MissouriMRDT/ArmBoard_Hardware/README.md

# ArmBoardHardware
Hardware design files for robotic arm

Master branch holds completed versions, branch arm board holds works in progress
