MissouriMRDT/ArmBoard_Hardware/Manufacturing/Armboard BOM.xlsx

Id | Designator | Package | Designation | Item Name | Manufacturer Number | Vendor | Quantity | Cost Per Item | URL | Standard Components Document (https://docs.google.com/spreadsheets/d/1Z3rDIutImW05QqWMk1JalDYzc1NMwjMxJc6CKg8kRtc/edit)
1 | C1, C2, C5, C6, C7, C8, C9, C10, C11 | 10uF | 603 smd | CAP CER 10UF 10V X5R 0603 | C0603C106M8PAC7411 | DigiKey | 9 | 0.48 | C0603C106M8PAC7411 KEMET | Capacitors | DigiKey (https://www.digikey.com/en/products/detail/kemet/C0603C106M8PAC7411/12701345)
2 | D1, D4, D7, D10, D13, D26, D29 |  | 603 smd | Zener diode |  | DigiKey | 7 | 0.10 | Already have them I think
3 | ConnA |  | Anderson PP | Black Housing | 1327G6 | Powerwerx | 8 | 0.39 | https://powerwerx.com/anderson-powerpole-colored-housings
4 | ConnB |  | Anderson PP | Red Housing | 1327 | Powerwerx | 8 | 0.39 | https://powerwerx.com/anderson-powerpole-colored-housings
5 | ConnC |  | Anderson PP | Green Housing | 1327G5 | Powerwerx | 1 | 0.39 | https://powerwerx.com/anderson-powerpole-colored-housings
6 | Conn8, Conn11, Conn12, Conn15, Conn16, Conn19, Conn20, Conn21 | Molex_SL_02 | MRDT_Connectors:MOLEX_SL_02_Horizontal | Molex SL 2 | 705530001 | DigiKey | 8 | 0.82 | https://www.digikey.com/en/products/detail/molex/0705530001/114951?s=N4IgTCBcDaIOoFkAsBOADGgtAOQCIgF0BfIA
7 | Conn9, Conn10, Conn13, Conn14, Conn17, Conn18 | Molex_SL_03 | MRDT_Connectors:MOLEX_SL_03_Horizontal | Molex SL 3 | 705530002 | DigiKey | 6 | 1.18 | https://www.digikey.com/en/products/detail/molex/0705530002/114955
8 | D2, D3, D5, D6, D8, D9, D11, D12, D14, D15, D16, D25, D27, D28, D30, D31 | Blue | 603 smd | LED BLUE CLEAR CHIP SMD | LTST-C191TBKT | DigiKey | 16 | 0.33 | https://www.digikey.com/en/products/detail/lite-on-inc/LTST-C191TBKT/573587
9 | D17, D18, D19, D32, D33 | Green | 603 smd | LED GREEN CLEAR CHIP SMD | LTST-C191KGKT | DigiKey | 11 | 0.26 | https://www.digikey.com/en/products/detail/lite-on-inc/LTST-C191KGKT/386834
10 | Q1 Q2 | MOSFET NpN 6Amps | SMD:SOT-23-3 | 833-SI3420A-TP | SI3420A-TP | Mouser | 2 | 0.37 | https://www.mouser.com/ProductDetail/Micro-Commercial-Components-MCC/SI3420A-TP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
11 | R18, R19 | 330 | 603 smd | RES SMD 330 OHM 5% 1/4W 0603 | ESR03EZPJ331 | Digikey | 2 | 0.10 | https://www.digikey.com/en/products/detail/rohm-semiconductor/ESR03EZPJ331/1762730
13 | 1k1, 1k2, 1k3, 1k4, 1k5, 1k6, 1k7, 1k8, 1k9, 1k10, 1k11, 1k12, 1k13, 1k14, 1k15, 1k16, 1k17, 1k18, 1k19, 1k20, 1k21, 1k22, 1k23, 1k24, 1k25, 1k26, 1k27, 1k28, 1k29, 1k30, 1k31, 1k32, 1k33, 1k34, 1k35, 1k36, 1k37, 1k38, 1k39, 1k40, 1k41, 1k42 | 1k | 603 smd | RES SMD 1K OHM 5% 1/4W 0603 | ESR03EZPJ102 | DigiKey | 42 | 0.10 | https://www.digikey.com/en/products/detail/rohm-semiconductor/ESR03EZPJ102/1762721
14 | R35, R36, R37, R38, R39, R40, R41 | 3.3k | 603 smd | RES SMD 3.3K OHM 5% 1/4W 0603 | ESR03EZPJ332 | DigiKey | 7 | 0.10 | https://www.digikey.com/en/products/detail/rohm-semiconductor/ESR03EZPJ332/4051239
15 | R42, R43, R44, R45, R46, R47, R48 | 10k | 603 smd | RES SMD 10K OHM 5% 1/4W 0603 | ESR03EZPJ103 | DigiKey | 14 | 0.10 | https://www.digikey.com/en/products/detail/rohm-semiconductor/ESR03EZPJ103/1762722
16 | R15, R16,R42, R43, R44, R45, R46, R47, R48 | 120 | 603 smd | RES SMD 100 OHM 5% 1/4W 0603 | ESR03EZPJ101 | DigiKey | 9 | 0.10 | https://www.digikey.com/en/products/detail/te-connectivity-passive-product/CRGCQ0603F120R/8576279
17 | SW1 SW2 SW3 SW4 SW5 SW6 SW7 | SW_Push | Button_Switch_SMD:SW_SPST_TL3305A | SWITCH TACTILE SPST-NO 50MA 12V | TL3305AF160QG | DigiKey | 7 | 0.13 | https://www.digikey.com/en/products/detail/e-switch/TL3305AF160QG/5816195
18 | U1 | TM4C129E_Launchpad | MRDT_Shields:TM4C129E_Launchpad_FULL_SMD_BOTTOM | LAUNCHPAD TM4C129X EVAL BRD |  |  | 1 | 17.00
19 | U2 | OKI | MRDT_Devices:OKI_Horizontal | DC DC CONVERTER 3.3V 5W | OKI-78SR-3.3/1.5-W36H-C | Digikey | 1 | 4.30 | https://www.digikey.com/en/products/detail/murata-power-solutions-inc/OKI-78SR-3.3-1.5-W36H-C/4878851
20 | MC1, MC2, MC3, MC4, MC5, MC6, MC7 | MRDT_ICs:MultiPowerSO_30 | VNH5019A_E | VNH5019A_E |  | DigiKey | 7 | 4.50 | https://www.digikey.com/en/products/detail/stmicroelectronics/VNH5019A-E/3087979
