MissouriMRDT/ArmBoard_Hardware/Hardware/ArmBoard_Hardware/ArmBoard_Hardware.step

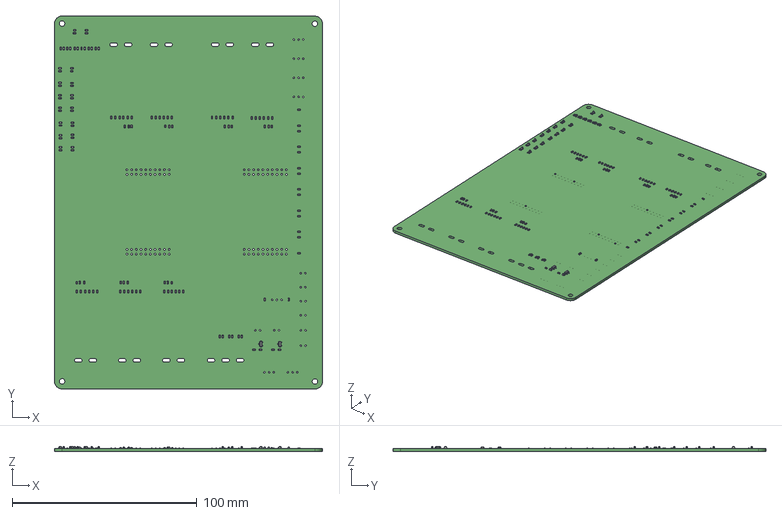
[picture p1: CAD file, 2022-03-09]
Hardware/ArmBoard_Hardware/ArmBoard_Hardware.step
145.2 x 202.0 x 2.85 mm
