MissouriMRDT/ArmBoard_Hardware/Documentation/ArmBoard_Hardware.pdf

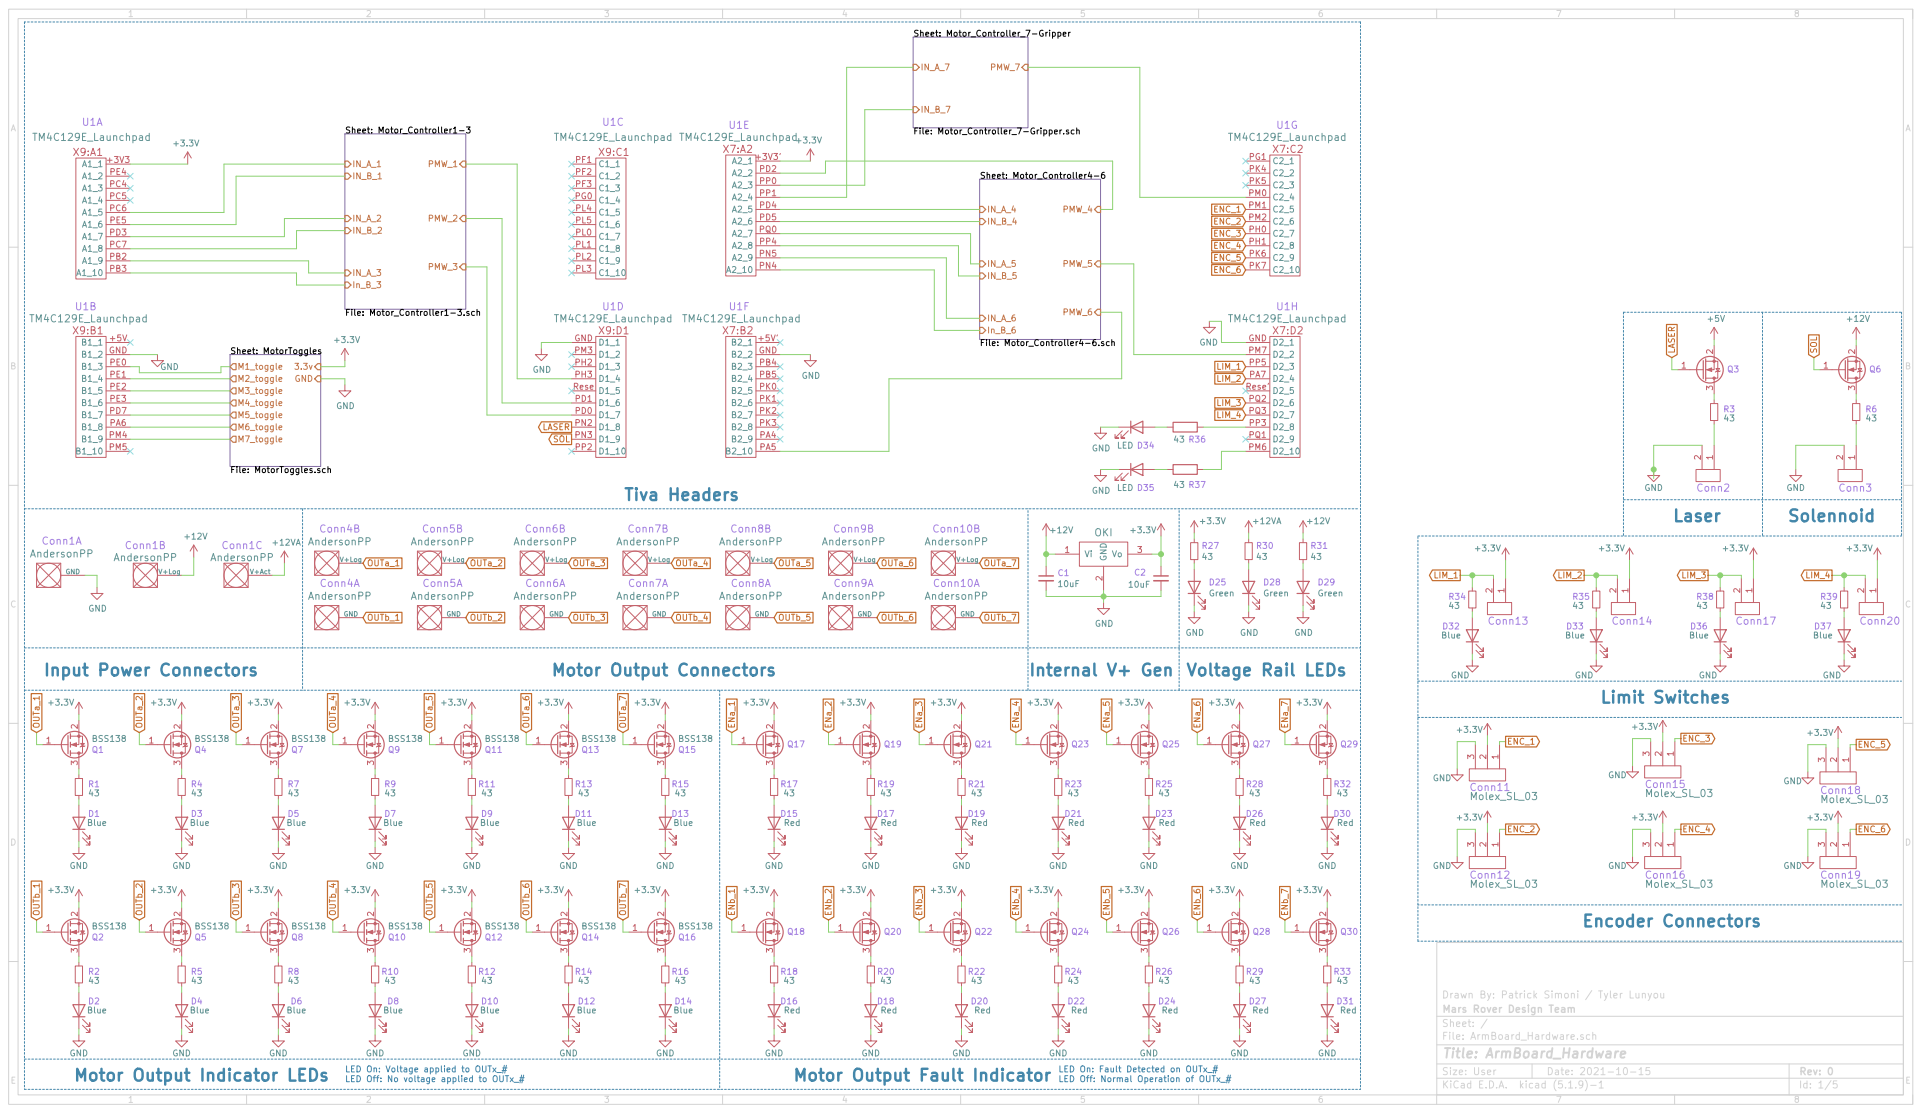
[picture p2: page 1]

Drawn By: Patrick Simoni / Tyler Lunyou
File: ArmBoard_Hardware.sch Sheet: / Mars Rover Design Team

Motor Output Fault Indicator

LED On: Fault Detected on OUTx_#
LED Off: Normal Operation of OUTx_#

LED Off: No voltage applied to OUTx_#

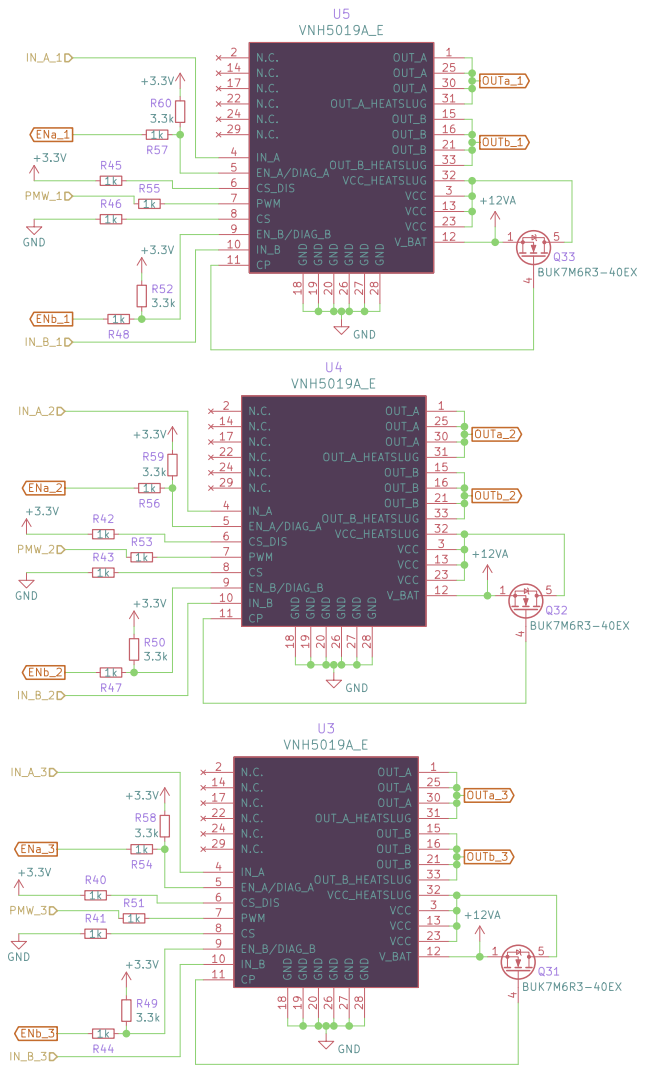
[picture p3: page 2]

Mars Rover Design Team
Sheet: /Motor_Controller1-3/
File: Motor_Controller1-3.sch
Id: 2/5 Title: ArmBoard_Hardware

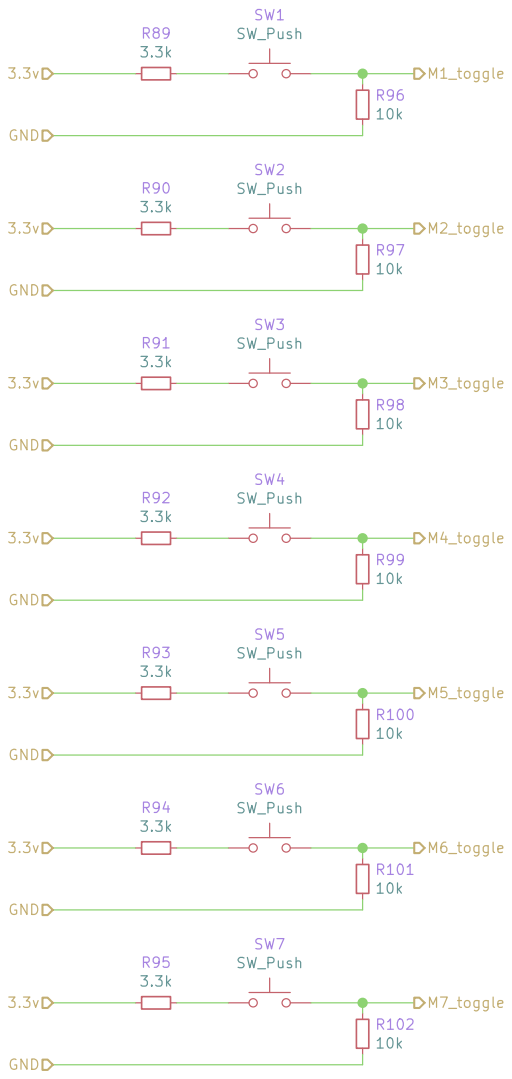
[picture p4: page 3]

Drawn By: Patrick Simoni / Tyler Lunyou
Mars Rover Design Team
Sheet: /MotorToggles/
File: MotorToggles.sch
Id: 3/5 Title: ArmBoard_Hardware

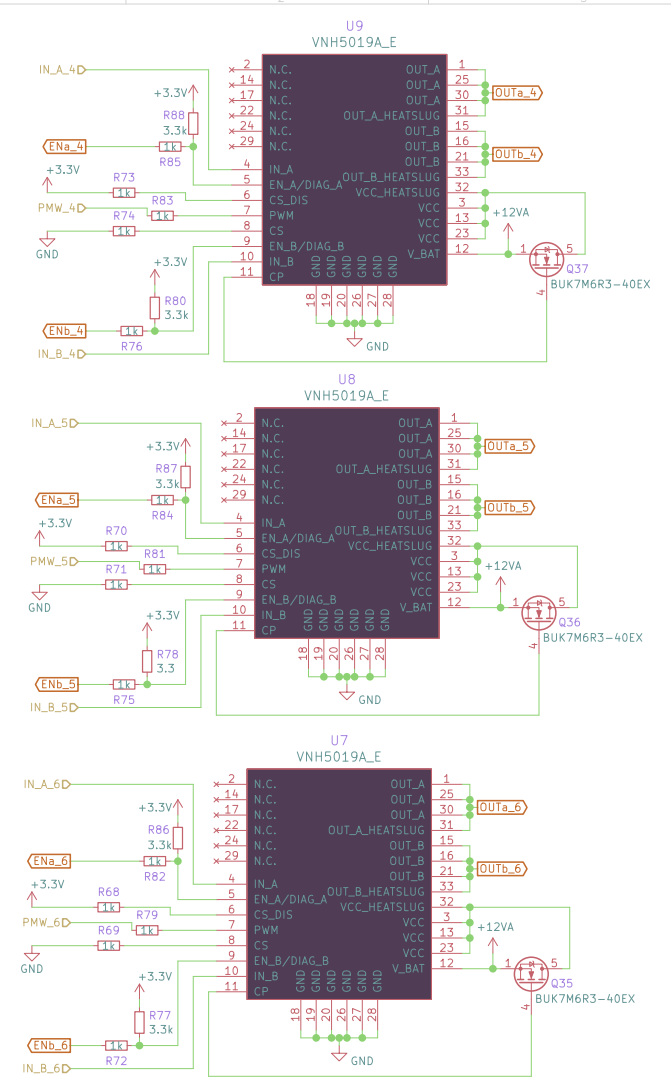
[picture p5: page 4]

Mars Rover Design Team
Sheet: /Motor_Controller4-6/
File: Motor_Controller4-6.sch
Id: 4/5 Title: ArmBoard_Hardware

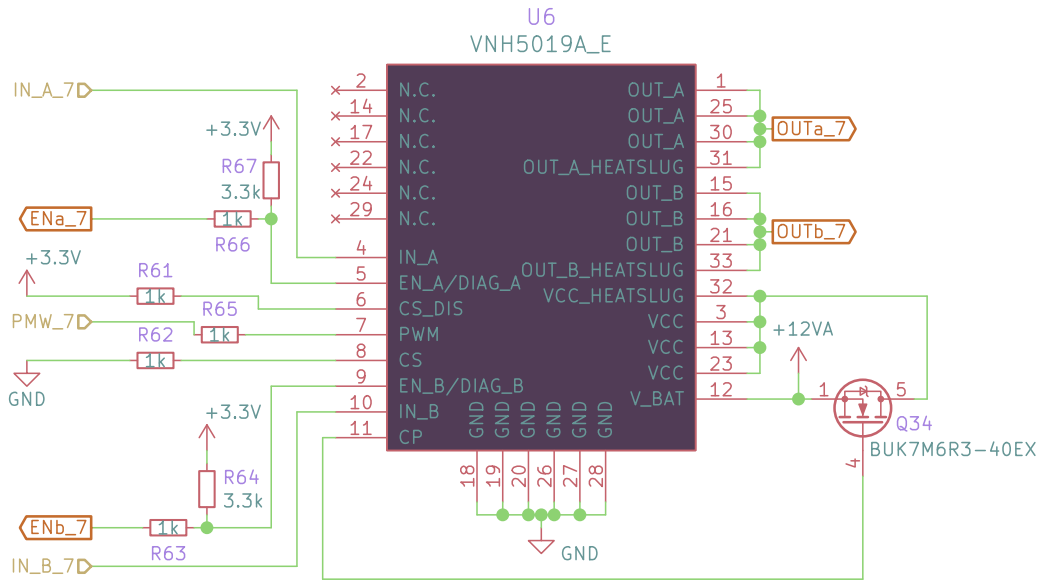
[picture p6: page 5]

Drawn By: Patrick Simoni / Tyler Lunyou
Mars Rover Design Team
Sheet: /Motor_Controller_7-Gripper/
File: Motor_Controller_7-Gripper.sch
Id: 5/5 Title: ArmBoard_Hardware
