MissouriMRDT/ArmBoard_Hardware/Hardware/ArmBoard_Hardware/ArmBoard_Hardware.kicad_pcb

## KiCad design Hardware/ArmBoard_Hardware/ArmBoard_Hardware.kicad_pcb (2022-05-07)

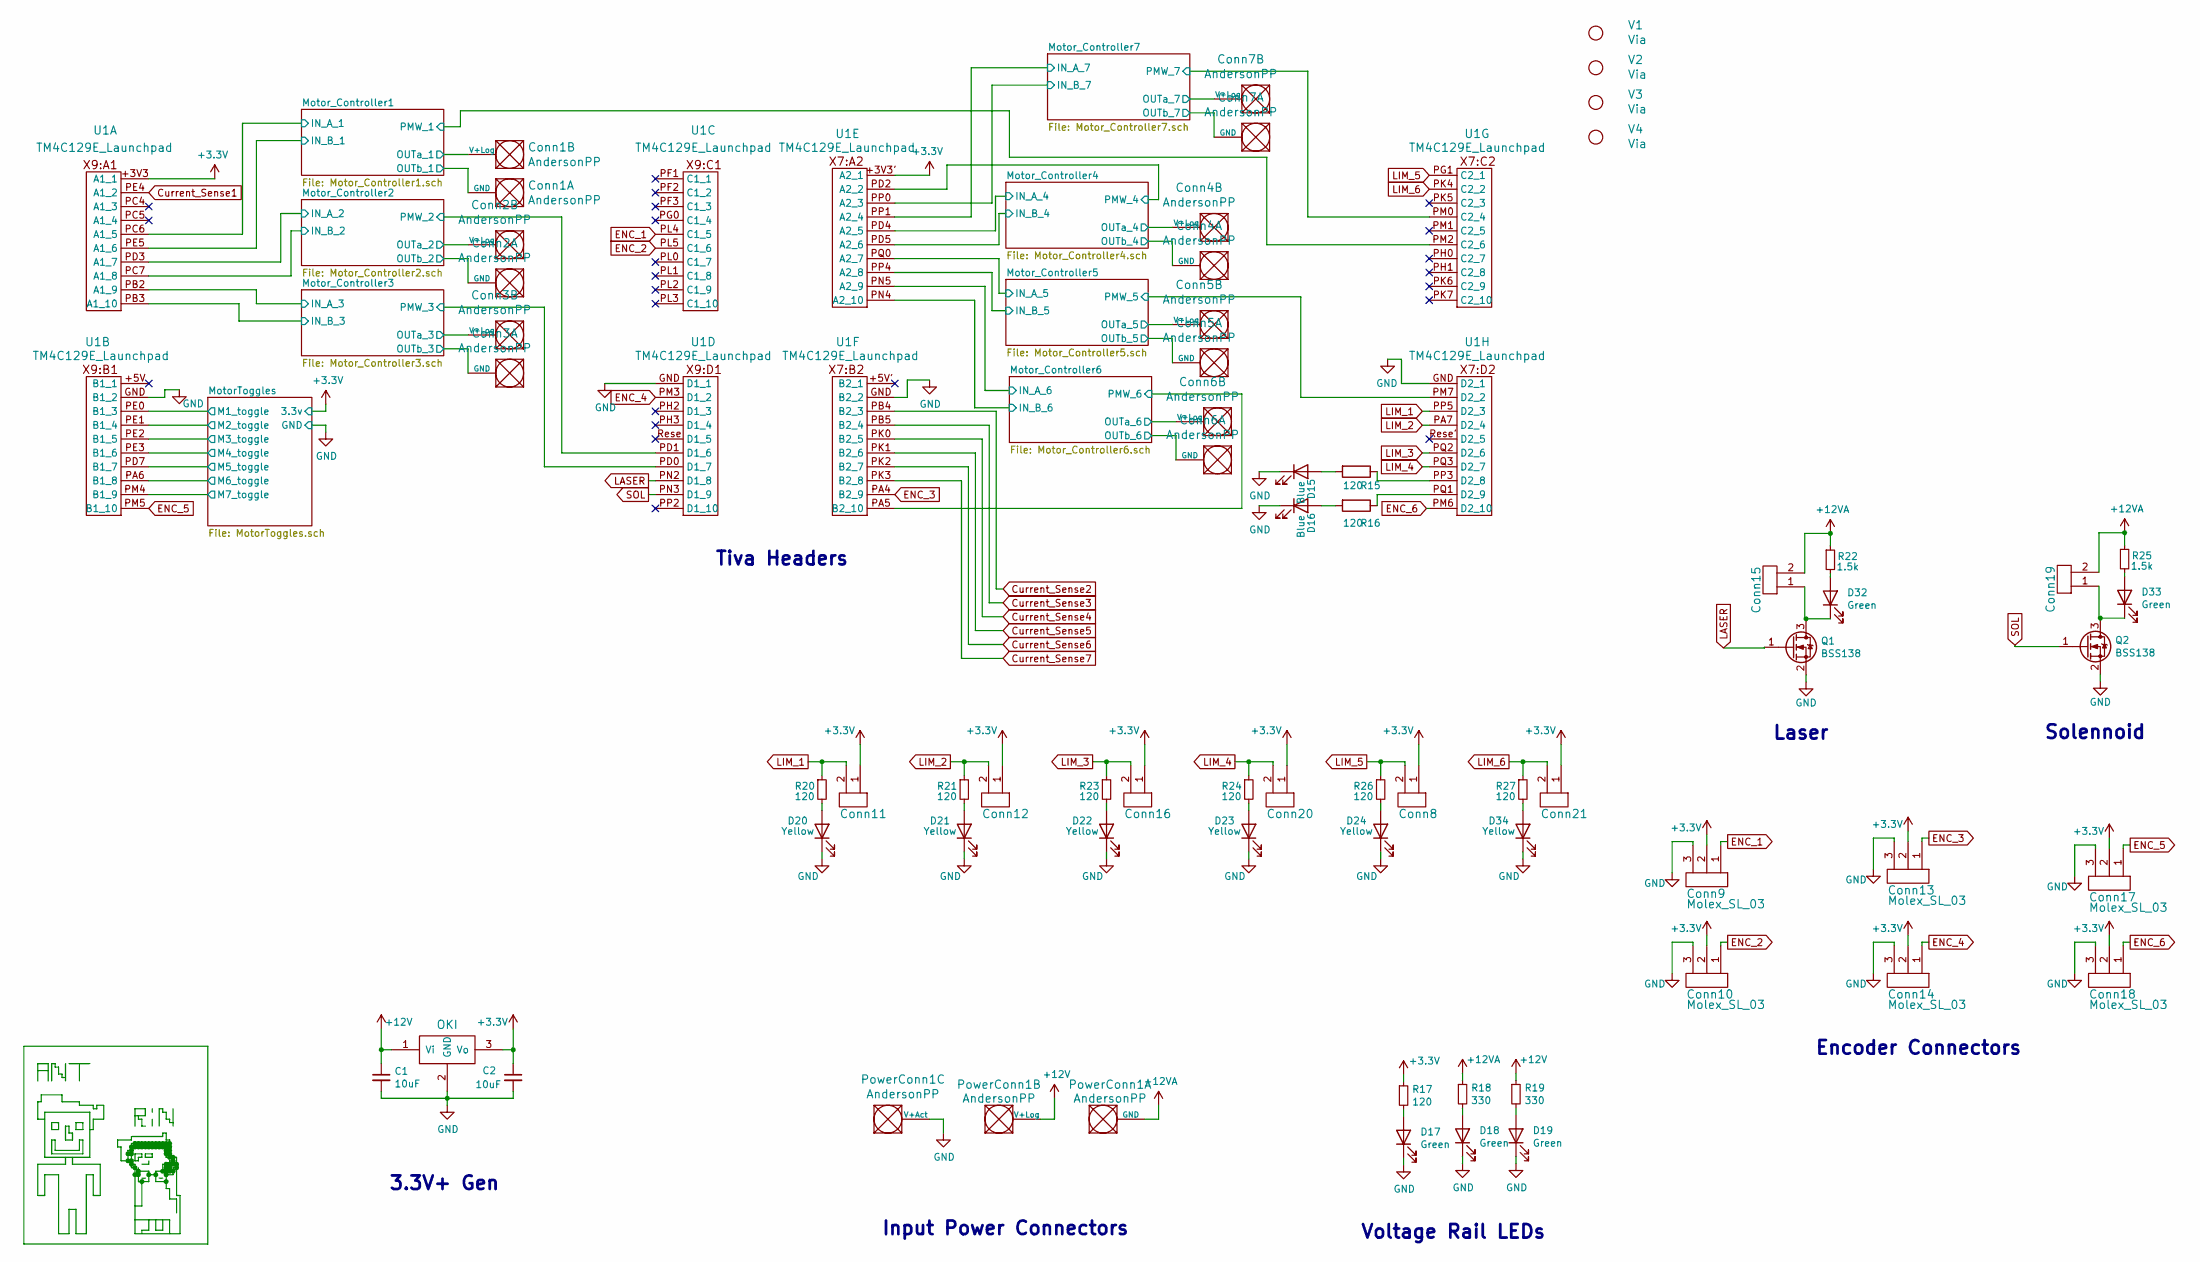
[picture p18: schematic ArmBoard_Hardware.sch]

Parts:
C1, C2: 10uF; C_0603_1608Metric_Pad1.08x0.95mm_HandSolder
Conn1, Conn2, Conn3, Conn4, Conn5, Conn6, Conn7: AndersonPP; Square_Anderson_2_H_Side_By_Side
Conn8, Conn11, Conn12, Conn15, Conn16, Conn19, Conn20, Conn21: Molex_SL_02; MOLEX_SL_02_Vertical
Conn9, Conn10, Conn13, Conn14, Conn17, Conn18: Molex_SL_03; MOLEX_SL_03_Vertical
D15, D16: Blue; LED_0603_1608Metric_Pad1.05x0.95mm_HandSolder
D17, D18, D19, D32, D33: Green; LED_0603_1608Metric_Pad1.05x0.95mm_HandSolder
D20, D21, D22, D23, D24, D34: Yellow; LED_0603_1608Metric_Pad1.05x0.95mm_HandSolder
OKI1: OKI; OKI_Horizontal
PowerConn1: AndersonPP; Square_Anderson_3_H_Side_By_Side
Q1, Q2: BSS138; SOT-23
R15, R16, R17, R20, R21, R23, R24, R26, R27: 120; R_0603_1608Metric_Pad0.98x0.95mm_HandSolder
R18, R19: 330; R_0603_1608Metric_Pad0.98x0.95mm_HandSolder
R22, R25: 1.5k; R_0603_1608Metric_Pad0.98x0.95mm_HandSolder
U1: TM4C129E_Launchpad; TM4C129E_Launchpad_FULL_THT_TOP-MOUNTLESS
V1, V2, V3, V4: Via; 4_40_Hole_Corner

Connections:
+3V3: C2.1, Conn8.1, Conn9.2, Conn10.2, Conn11.1, Conn12.1, Conn13.2, Conn14.2, Conn16.1, Conn17.2, Conn18.2, Conn20.1, Conn21.1, OKI1.3 (Vo), R17.1, U1.+3V3 (A1_1), U1.+3V3' (A2_1); also elsewhere on the board
+12V: C1.1, OKI1.1 (Vi), PowerConn1.2 (V+Log), R19.1
+12VA: Conn15.2, Conn19.2, PowerConn1.1 (GND), R18.1, R22.1, R25.1; also elsewhere on the board
/MotorToggles/M1_toggle: U1.PE0 (B1_3); also elsewhere on the board
/MotorToggles/M2_toggle: U1.PE1 (B1_4); also elsewhere on the board
/MotorToggles/M3_toggle: U1.PE2 (B1_5); also elsewhere on the board
/MotorToggles/M4_toggle: U1.PE3 (B1_6); also elsewhere on the board
/MotorToggles/M5_toggle: U1.PD7 (B1_7); also elsewhere on the board
/MotorToggles/M6_toggle: U1.PA6 (B1_8); also elsewhere on the board
/MotorToggles/M7_toggle: U1.PM4 (B1_9); also elsewhere on the board
/Motor_Controller1/IN_A_1: U1.PC6 (A1_5); also elsewhere on the board
/Motor_Controller1/IN_B_1: U1.PE5 (A1_6); also elsewhere on the board
/Motor_Controller1/OUTa_1: Conn1.2 (V+Log); also elsewhere on the board
/Motor_Controller1/OUTb_1: Conn1.1 (GND); also elsewhere on the board
/Motor_Controller1/PMW_1: U1.PM2 (C2_6); also elsewhere on the board
/Motor_Controller2/IN_A_2: U1.PD3 (A1_7); also elsewhere on the board
/Motor_Controller2/IN_B_2: U1.PC7 (A1_8); also elsewhere on the board
/Motor_Controller2/OUTa_2: Conn2.2 (V+Log); also elsewhere on the board
/Motor_Controller2/OUTb_2: Conn2.1 (GND); also elsewhere on the board
/Motor_Controller2/PMW_2: U1.PD1 (D1_6); also elsewhere on the board
/Motor_Controller3/IN_A_3: U1.PB2 (A1_9); also elsewhere on the board
/Motor_Controller3/IN_B_3: U1.PB3 (A1_10); also elsewhere on the board
/Motor_Controller3/OUTa_3: Conn3.2 (V+Log); also elsewhere on the board
/Motor_Controller3/OUTb_3: Conn3.1 (GND); also elsewhere on the board
/Motor_Controller3/PMW_3: U1.PD0 (D1_7); also elsewhere on the board
/Motor_Controller4/IN_A_4: U1.PD4 (A2_5); also elsewhere on the board
/Motor_Controller4/IN_B_4: U1.PD5 (A2_6); also elsewhere on the board
/Motor_Controller4/OUTa_4: Conn4.2 (V+Log); also elsewhere on the board
/Motor_Controller4/OUTb_4: Conn4.1 (GND); also elsewhere on the board
/Motor_Controller4/PMW_4: U1.PD2 (A2_2); also elsewhere on the board
/Motor_Controller5/IN_A_5: U1.PQ0 (A2_7); also elsewhere on the board
/Motor_Controller5/IN_B_5: U1.PP4 (A2_8); also elsewhere on the board
/Motor_Controller5/OUTa_5: Conn5.2 (V+Log); also elsewhere on the board
/Motor_Controller5/OUTb_5: Conn5.1 (GND); also elsewhere on the board
/Motor_Controller5/PMW_5: U1.PM7 (D2_2); also elsewhere on the board
/Motor_Controller6/IN_A_6: U1.PN5 (A2_9); also elsewhere on the board
/Motor_Controller6/IN_B_6: U1.PN4 (A2_10); also elsewhere on the board
/Motor_Controller6/OUTa_6: Conn6.2 (V+Log); also elsewhere on the board
/Motor_Controller6/OUTb_6: Conn6.1 (GND); also elsewhere on the board
/Motor_Controller6/PMW_6: U1.PA5 (B2_10); also elsewhere on the board
/Motor_Controller7/IN_A_7: U1.PP1 (A2_4); also elsewhere on the board
/Motor_Controller7/IN_B_7: U1.PP0 (A2_3); also elsewhere on the board
/Motor_Controller7/OUTa_7: Conn7.2 (V+Log); also elsewhere on the board
/Motor_Controller7/OUTb_7: Conn7.1 (GND); also elsewhere on the board
/Motor_Controller7/PMW_7: U1.PM0 (C2_4); also elsewhere on the board
Current_Sense1: U1.PE4 (A1_2); also elsewhere on the board
Current_Sense2: U1.PB4 (B2_3); also elsewhere on the board
Current_Sense3: U1.PB5 (B2_4); also elsewhere on the board
Current_Sense4: U1.PK0 (B2_5); also elsewhere on the board
Current_Sense5: U1.PK1 (B2_6); also elsewhere on the board
Current_Sense6: U1.PK2 (B2_7); also elsewhere on the board
Current_Sense7: U1.PK3 (B2_8); also elsewhere on the board
ENC_1: Conn9.1, U1.PL4 (C1_5)
ENC_2: Conn10.1, U1.PL5 (C1_6)
ENC_3: Conn13.1, U1.PA4 (B2_9)
ENC_4: Conn14.1, U1.PM3 (D1_2)
ENC_5: Conn17.1, U1.PM5 (B1_10)
ENC_6: Conn18.1, U1.PM6 (D2_10)
GND: C1.2, C2.2, Conn9.3, Conn10.3, Conn13.3, Conn14.3, Conn17.3, Conn18.3, D15.1 (K), D16.1 (K), D17.1 (K), D18.1 (K), D19.1 (K), D20.1 (K), D21.1 (K), D22.1 (K), D23.1 (K), D24.1 (K), D34.1 (K), OKI1.2 (GND), PowerConn1.3 (V+Act), Q1.2 (S), Q2.2 (S), U1.GND (B1_2); also elsewhere on the board
LASER: Q1.1 (G), U1.PN2 (D1_8)
LIM_1: Conn11.2, R20.1, U1.PP5 (D2_3)
LIM_2: Conn12.2, R21.1, U1.PA7 (D2_4)
LIM_3: Conn16.2, R23.1, U1.PQ2 (D2_6)
LIM_4: Conn20.2, R24.1, U1.PQ3 (D2_7)
LIM_5: Conn8.2, R26.1, U1.PG1 (C2_1)
LIM_6: Conn21.2, R27.1, U1.PK4 (C2_2)
unnamed: Conn15.1, D32.1 (K), Q1.3 (D)
unnamed: Conn19.1, D33.1 (K), Q2.3 (D)
unnamed: D15.2 (A), R15.2
unnamed: D16.2 (A), R16.2
unnamed: D17.2 (A), R17.2
unnamed: D18.2 (A), R18.2
unnamed: D19.2 (A), R19.2
unnamed: D20.2 (A), R20.2
unnamed: D21.2 (A), R21.2
unnamed: D22.2 (A), R23.2
unnamed: D23.2 (A), R24.2
unnamed: D24.2 (A), R26.2
unnamed: D32.2 (A), R22.2
unnamed: D33.2 (A), R25.2
unnamed: D34.2 (A), R27.2
unnamed: R15.1, U1.PP3 (D2_8)
unnamed: R16.1, U1.PQ1 (D2_9)
SOL: Q2.1 (G), U1.PN3 (D1_9)

Notes on the sheet:
Encoder Connectors
Input Power Connectors
3.3V+ Gen
Voltage Rail LEDs
Laser
Solennoid
Tiva Headers

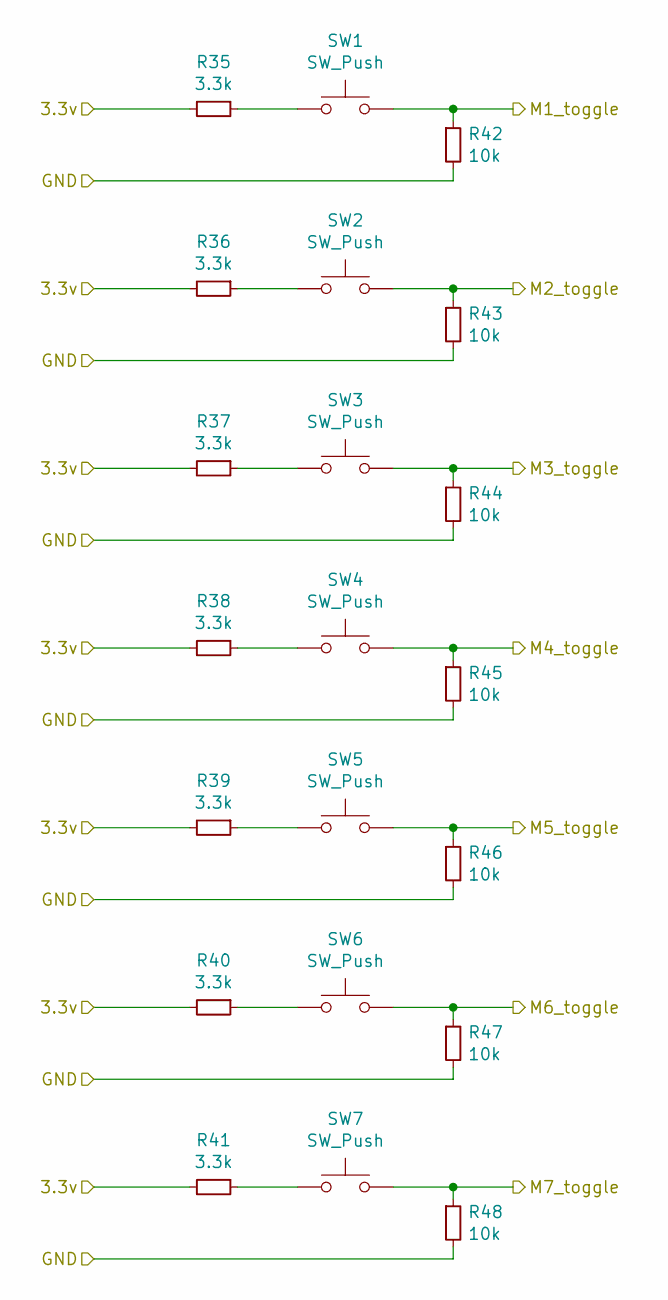
[picture p19: schematic MotorToggles.sch, ArmBoard_Hardware]

Parts:
R35, R36, R37, R38, R39, R40, R41: 3.3k; R_0603_1608Metric_Pad0.98x0.95mm_HandSolder
R42, R43, R44, R45, R46, R47, R48: 10k; R_0603_1608Metric_Pad0.98x0.95mm_HandSolder
SW1, SW2, SW3, SW4, SW5, SW6, SW7: SW_Push; SW_SPST_TL3305A

Connections:
+3V3: R35.2, R36.2, R37.2, R38.2, R39.2, R40.2, R41.2; also elsewhere on the board
/MotorToggles/M1_toggle: R42.1, SW1.2; also elsewhere on the board
/MotorToggles/M2_toggle: R43.1, SW2.2; also elsewhere on the board
/MotorToggles/M3_toggle: R44.1, SW3.2; also elsewhere on the board
/MotorToggles/M4_toggle: R45.1, SW4.2; also elsewhere on the board
/MotorToggles/M5_toggle: R46.1, SW5.2; also elsewhere on the board
/MotorToggles/M6_toggle: R47.1, SW6.2; also elsewhere on the board
/MotorToggles/M7_toggle: R48.1, SW7.2; also elsewhere on the board
GND: R42.2, R43.2, R44.2, R45.2, R46.2, R47.2, R48.2; also elsewhere on the board
unnamed: R35.1, SW1.1
unnamed: R36.1, SW2.1
unnamed: R37.1, SW3.1
unnamed: R38.1, SW4.1
unnamed: R39.1, SW5.1
unnamed: R40.1, SW6.1
unnamed: R41.1, SW7.1

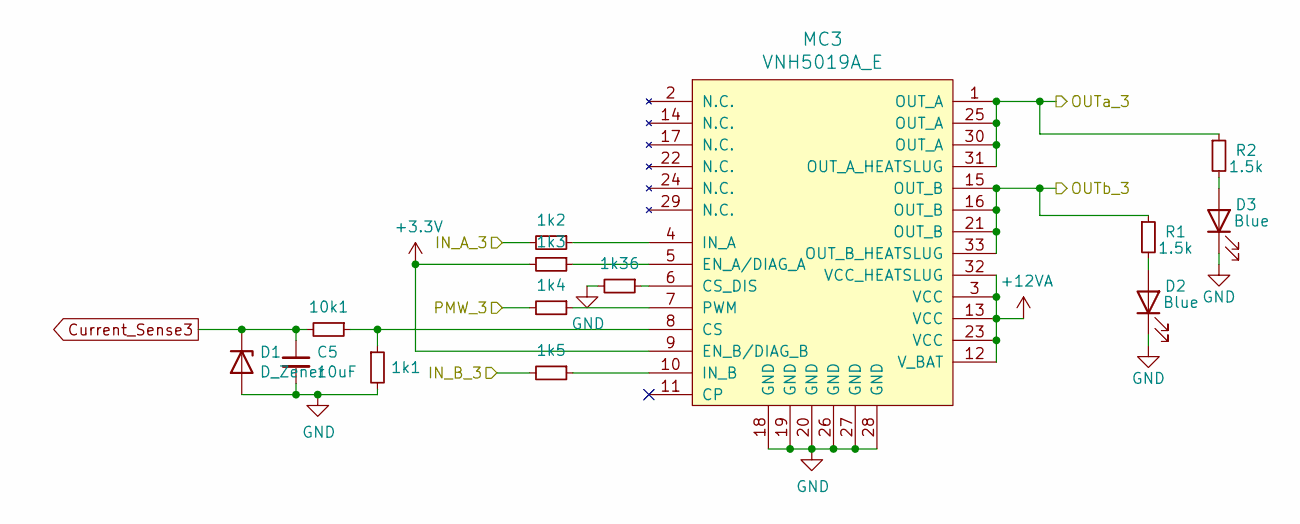
[picture p20: schematic Motor_Controller3.sch, ArmBoard_Hardware]

Parts:
1k1, 1k2, 1k3, 1k4, 1k5, 1k36, 10k1: R_Small; R_0603_1608Metric_Pad0.98x0.95mm_HandSolder
C5: 10uF; C_0603_1608Metric_Pad1.08x0.95mm_HandSolder
D1: D_Zener; D_0603_1608Metric_Pad1.05x0.95mm_HandSolder
D2, D3: Blue; LED_0603_1608Metric_Pad1.05x0.95mm_HandSolder
MC3: VNH5019A_E; MultiPowerSO_30
R1, R2: 1.5k; R_0603_1608Metric_Pad0.98x0.95mm_HandSolder

Connections:
+3V3: 1k3.2, MC3.9 (EN_B/DIAG_B); also elsewhere on the board
+12VA: MC3.3 (VCC), MC3.12 (V_BAT), MC3.13 (VCC), MC3.23 (VCC), MC3.32 (VCC_HEATSLUG); also elsewhere on the board
/Motor_Controller3/IN_A_3: 1k2.2; also elsewhere on the board
/Motor_Controller3/IN_B_3: 1k5.2; also elsewhere on the board
/Motor_Controller3/OUTa_3: MC3.1 (OUT_A), MC3.25 (OUT_A), MC3.30 (OUT_A), MC3.31 (OUT_A_HEATSLUG), R2.1; also elsewhere on the board
/Motor_Controller3/OUTb_3: MC3.15 (OUT_B), MC3.16 (OUT_B), MC3.21 (OUT_B), MC3.33 (OUT_B_HEATSLUG), R1.1; also elsewhere on the board
/Motor_Controller3/PMW_3: 1k4.2; also elsewhere on the board
Current_Sense3: 10k1.2, C5.1, D1.1 (K); also elsewhere on the board
GND: 1k1.2, 1k36.2, C5.2, D1.2 (A), D2.1 (K), D3.1 (K), MC3.18 (GND), MC3.19 (GND), MC3.20 (GND), MC3.26 (GND), MC3.27 (GND), MC3.28 (GND); also elsewhere on the board
unnamed: 1k2.1, MC3.4 (IN_A)
unnamed: 1k3.1, MC3.5 (EN_A/DIAG_A)
unnamed: 1k4.1, MC3.7 (PWM)
unnamed: 1k5.1, MC3.10 (IN_B)
unnamed: 1k36.1, MC3.6 (CS_DIS)
unnamed: 1k1.1, 10k1.1, MC3.8 (CS)
unnamed: D2.2 (A), R1.2
unnamed: D3.2 (A), R2.2

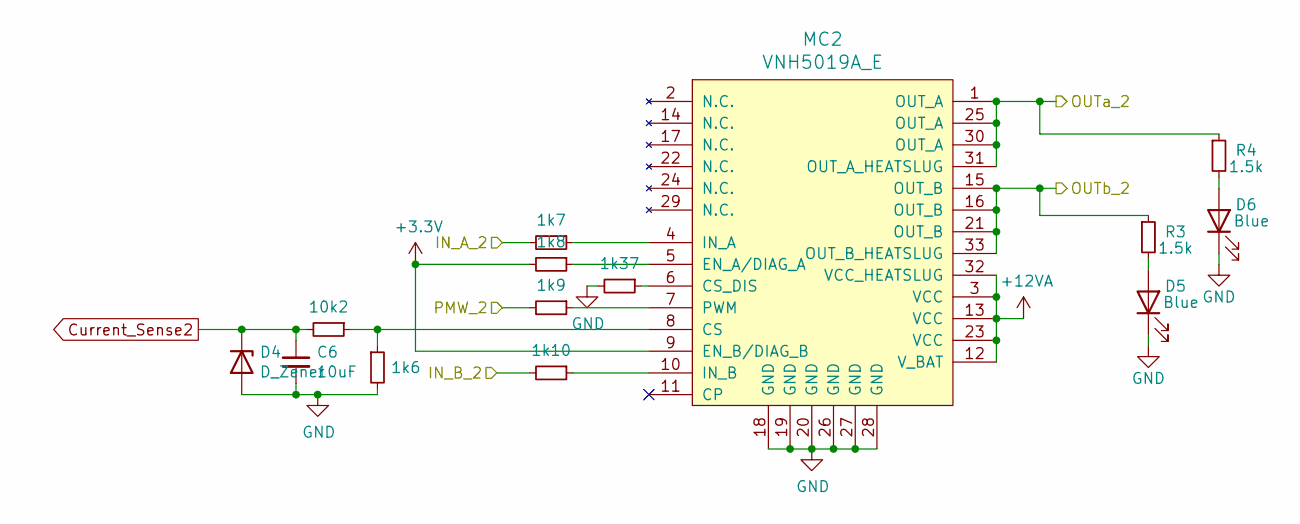
[picture p21: schematic Motor_Controller2.sch, ArmBoard_Hardware]

Parts:
1k6, 1k7, 1k8, 1k9, 1k10, 1k37, 10k2: R_Small; R_0603_1608Metric_Pad0.98x0.95mm_HandSolder
C6: 10uF; C_0603_1608Metric_Pad1.08x0.95mm_HandSolder
D4: D_Zener; D_0603_1608Metric_Pad1.05x0.95mm_HandSolder
D5, D6: Blue; LED_0603_1608Metric_Pad1.05x0.95mm_HandSolder
MC2: VNH5019A_E; MultiPowerSO_30
R3, R4: 1.5k; R_0603_1608Metric_Pad0.98x0.95mm_HandSolder

Connections:
+3V3: 1k8.2, MC2.9 (EN_B/DIAG_B); also elsewhere on the board
+12VA: MC2.3 (VCC), MC2.12 (V_BAT), MC2.13 (VCC), MC2.23 (VCC), MC2.32 (VCC_HEATSLUG); also elsewhere on the board
/Motor_Controller2/IN_A_2: 1k7.2; also elsewhere on the board
/Motor_Controller2/IN_B_2: 1k10.2; also elsewhere on the board
/Motor_Controller2/OUTa_2: MC2.1 (OUT_A), MC2.25 (OUT_A), MC2.30 (OUT_A), MC2.31 (OUT_A_HEATSLUG), R4.1; also elsewhere on the board
/Motor_Controller2/OUTb_2: MC2.15 (OUT_B), MC2.16 (OUT_B), MC2.21 (OUT_B), MC2.33 (OUT_B_HEATSLUG), R3.1; also elsewhere on the board
/Motor_Controller2/PMW_2: 1k9.2; also elsewhere on the board
Current_Sense2: 10k2.2, C6.1, D4.1 (K); also elsewhere on the board
GND: 1k6.2, 1k37.2, C6.2, D4.2 (A), D5.1 (K), D6.1 (K), MC2.18 (GND), MC2.19 (GND), MC2.20 (GND), MC2.26 (GND), MC2.27 (GND), MC2.28 (GND); also elsewhere on the board
unnamed: 1k7.1, MC2.4 (IN_A)
unnamed: 1k8.1, MC2.5 (EN_A/DIAG_A)
unnamed: 1k9.1, MC2.7 (PWM)
unnamed: 1k10.1, MC2.10 (IN_B)
unnamed: 1k37.1, MC2.6 (CS_DIS)
unnamed: 1k6.1, 10k2.1, MC2.8 (CS)
unnamed: D5.2 (A), R3.2
unnamed: D6.2 (A), R4.2

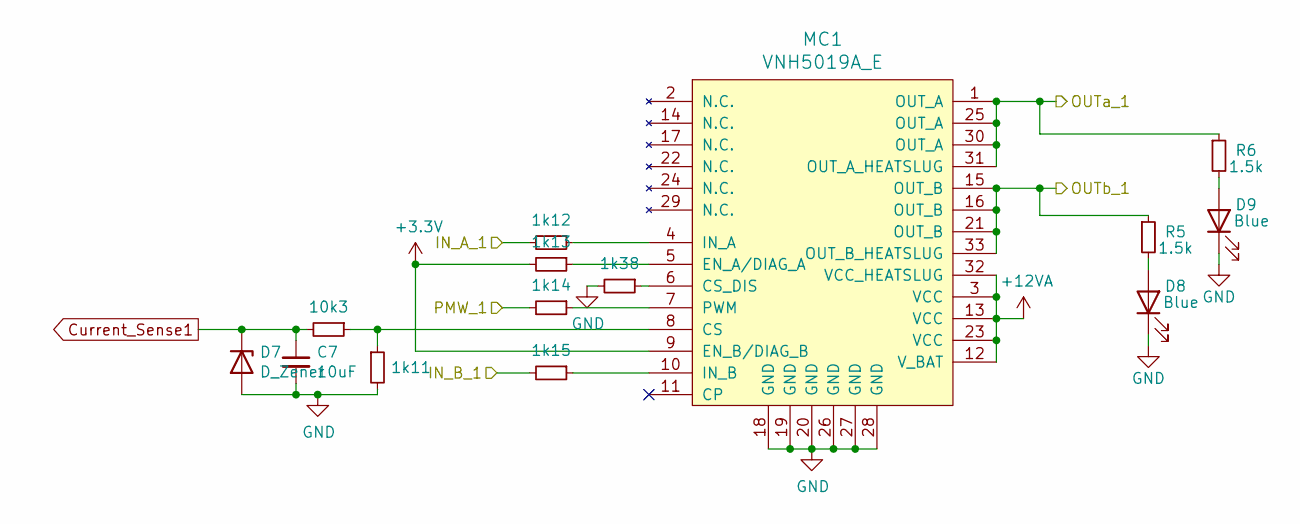
[picture p22: schematic Motor_Controller1.sch, ArmBoard_Hardware]

Parts:
1k11, 1k12, 1k13, 1k14, 1k15, 1k38, 10k3: R_Small; R_0603_1608Metric_Pad0.98x0.95mm_HandSolder
C7: 10uF; C_0603_1608Metric_Pad1.08x0.95mm_HandSolder
D7: D_Zener; D_0603_1608Metric_Pad1.05x0.95mm_HandSolder
D8, D9: Blue; LED_0603_1608Metric_Pad1.05x0.95mm_HandSolder
MC1: VNH5019A_E; MultiPowerSO_30
R5, R6: 1.5k; R_0603_1608Metric_Pad0.98x0.95mm_HandSolder

Connections:
+3V3: 1k13.2, MC1.9 (EN_B/DIAG_B); also elsewhere on the board
+12VA: MC1.3 (VCC), MC1.12 (V_BAT), MC1.13 (VCC), MC1.23 (VCC), MC1.32 (VCC_HEATSLUG); also elsewhere on the board
/Motor_Controller1/IN_A_1: 1k12.2; also elsewhere on the board
/Motor_Controller1/IN_B_1: 1k15.2; also elsewhere on the board
/Motor_Controller1/OUTa_1: MC1.1 (OUT_A), MC1.25 (OUT_A), MC1.30 (OUT_A), MC1.31 (OUT_A_HEATSLUG), R6.1; also elsewhere on the board
/Motor_Controller1/OUTb_1: MC1.15 (OUT_B), MC1.16 (OUT_B), MC1.21 (OUT_B), MC1.33 (OUT_B_HEATSLUG), R5.1; also elsewhere on the board
/Motor_Controller1/PMW_1: 1k14.2; also elsewhere on the board
Current_Sense1: 10k3.2, C7.1, D7.1 (K); also elsewhere on the board
GND: 1k11.2, 1k38.2, C7.2, D7.2 (A), D8.1 (K), D9.1 (K), MC1.18 (GND), MC1.19 (GND), MC1.20 (GND), MC1.26 (GND), MC1.27 (GND), MC1.28 (GND); also elsewhere on the board
unnamed: 1k12.1, MC1.4 (IN_A)
unnamed: 1k13.1, MC1.5 (EN_A/DIAG_A)
unnamed: 1k14.1, MC1.7 (PWM)
unnamed: 1k15.1, MC1.10 (IN_B)
unnamed: 1k38.1, MC1.6 (CS_DIS)
unnamed: 1k11.1, 10k3.1, MC1.8 (CS)
unnamed: D8.2 (A), R5.2
unnamed: D9.2 (A), R6.2

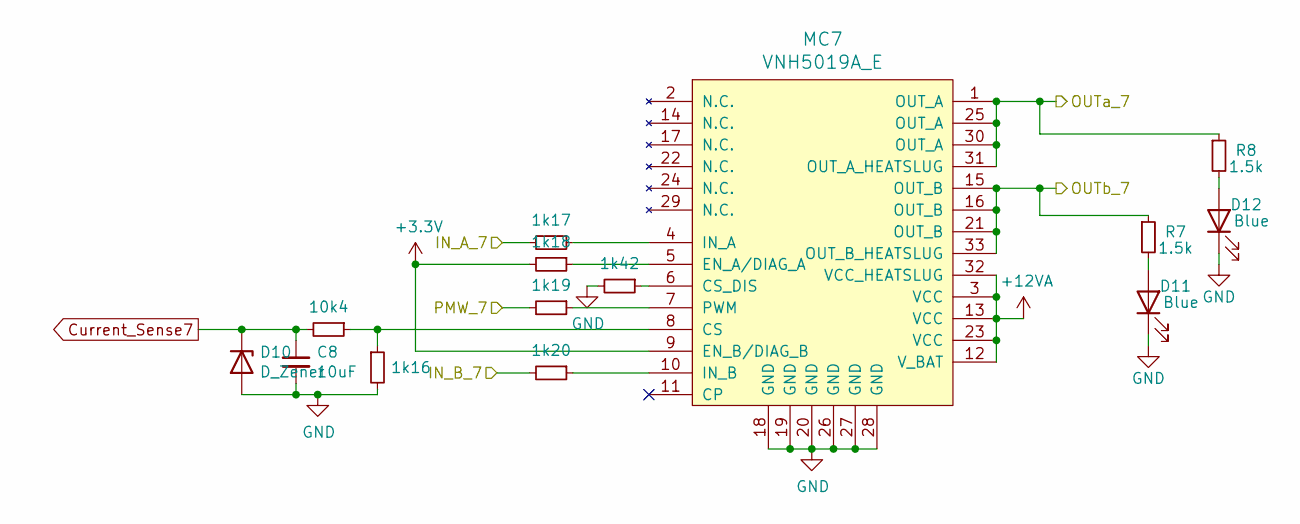
[picture p23: schematic Motor_Controller7.sch, ArmBoard_Hardware]

Parts:
1k16, 1k17, 1k18, 1k19, 1k20, 1k42, 10k4: R_Small; R_0603_1608Metric_Pad0.98x0.95mm_HandSolder
C8: 10uF; C_0603_1608Metric_Pad1.08x0.95mm_HandSolder
D10: D_Zener; D_0603_1608Metric_Pad1.05x0.95mm_HandSolder
D11, D12: Blue; LED_0603_1608Metric_Pad1.05x0.95mm_HandSolder
MC7: VNH5019A_E; MultiPowerSO_30
R7, R8: 1.5k; R_0603_1608Metric_Pad0.98x0.95mm_HandSolder

Connections:
+3V3: 1k18.2, MC7.9 (EN_B/DIAG_B); also elsewhere on the board
+12VA: MC7.3 (VCC), MC7.12 (V_BAT), MC7.13 (VCC), MC7.23 (VCC), MC7.32 (VCC_HEATSLUG); also elsewhere on the board
/Motor_Controller7/IN_A_7: 1k17.2; also elsewhere on the board
/Motor_Controller7/IN_B_7: 1k20.2; also elsewhere on the board
/Motor_Controller7/OUTa_7: MC7.1 (OUT_A), MC7.25 (OUT_A), MC7.30 (OUT_A), MC7.31 (OUT_A_HEATSLUG), R8.1; also elsewhere on the board
/Motor_Controller7/OUTb_7: MC7.15 (OUT_B), MC7.16 (OUT_B), MC7.21 (OUT_B), MC7.33 (OUT_B_HEATSLUG), R7.1; also elsewhere on the board
/Motor_Controller7/PMW_7: 1k19.2; also elsewhere on the board
Current_Sense7: 10k4.2, C8.1, D10.1 (K); also elsewhere on the board
GND: 1k16.2, 1k42.2, C8.2, D10.2 (A), D11.1 (K), D12.1 (K), MC7.18 (GND), MC7.19 (GND), MC7.20 (GND), MC7.26 (GND), MC7.27 (GND), MC7.28 (GND); also elsewhere on the board
unnamed: 1k17.1, MC7.4 (IN_A)
unnamed: 1k18.1, MC7.5 (EN_A/DIAG_A)
unnamed: 1k19.1, MC7.7 (PWM)
unnamed: 1k20.1, MC7.10 (IN_B)
unnamed: 1k42.1, MC7.6 (CS_DIS)
unnamed: 1k16.1, 10k4.1, MC7.8 (CS)
unnamed: D11.2 (A), R7.2
unnamed: D12.2 (A), R8.2

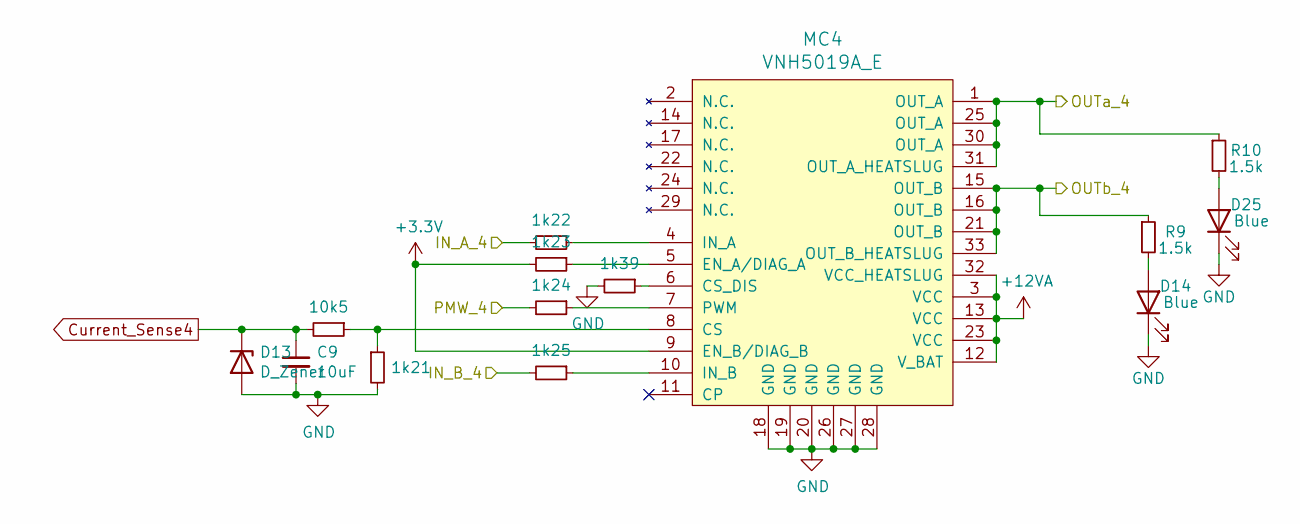
[picture p24: schematic Motor_Controller4.sch, ArmBoard_Hardware]

Parts:
1k21, 1k22, 1k23, 1k24, 1k25, 1k39, 10k5: R_Small; R_0603_1608Metric_Pad0.98x0.95mm_HandSolder
C9: 10uF; C_0603_1608Metric_Pad1.08x0.95mm_HandSolder
D13: D_Zener; D_0603_1608Metric_Pad1.05x0.95mm_HandSolder
D14, D25: Blue; LED_0603_1608Metric_Pad1.05x0.95mm_HandSolder
MC4: VNH5019A_E; MultiPowerSO_30
R9, R10: 1.5k; R_0603_1608Metric_Pad0.98x0.95mm_HandSolder

Connections:
+3V3: 1k23.2, MC4.9 (EN_B/DIAG_B); also elsewhere on the board
+12VA: MC4.3 (VCC), MC4.12 (V_BAT), MC4.13 (VCC), MC4.23 (VCC), MC4.32 (VCC_HEATSLUG); also elsewhere on the board
/Motor_Controller4/IN_A_4: 1k22.2; also elsewhere on the board
/Motor_Controller4/IN_B_4: 1k25.2; also elsewhere on the board
/Motor_Controller4/OUTa_4: MC4.1 (OUT_A), MC4.25 (OUT_A), MC4.30 (OUT_A), MC4.31 (OUT_A_HEATSLUG), R10.1; also elsewhere on the board
/Motor_Controller4/OUTb_4: MC4.15 (OUT_B), MC4.16 (OUT_B), MC4.21 (OUT_B), MC4.33 (OUT_B_HEATSLUG), R9.1; also elsewhere on the board
/Motor_Controller4/PMW_4: 1k24.2; also elsewhere on the board
Current_Sense4: 10k5.2, C9.1, D13.1 (K); also elsewhere on the board
GND: 1k21.2, 1k39.2, C9.2, D13.2 (A), D14.1 (K), D25.1 (K), MC4.18 (GND), MC4.19 (GND), MC4.20 (GND), MC4.26 (GND), MC4.27 (GND), MC4.28 (GND); also elsewhere on the board
unnamed: 1k22.1, MC4.4 (IN_A)
unnamed: 1k23.1, MC4.5 (EN_A/DIAG_A)
unnamed: 1k24.1, MC4.7 (PWM)
unnamed: 1k25.1, MC4.10 (IN_B)
unnamed: 1k39.1, MC4.6 (CS_DIS)
unnamed: 1k21.1, 10k5.1, MC4.8 (CS)
unnamed: D14.2 (A), R9.2
unnamed: D25.2 (A), R10.2

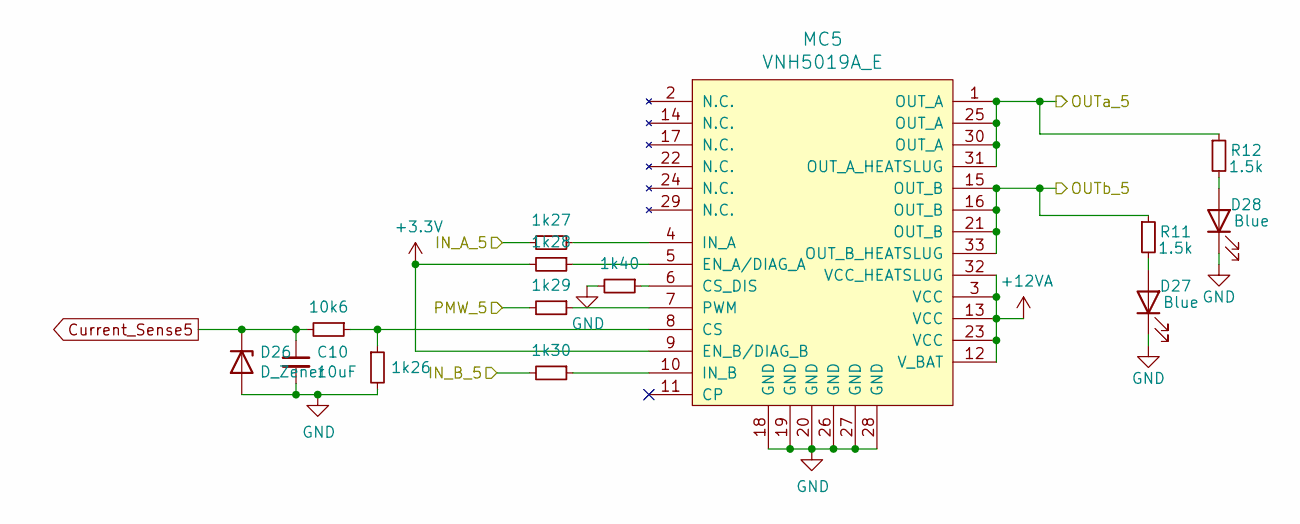
[picture p25: schematic Motor_Controller5.sch, ArmBoard_Hardware]

Parts:
1k26, 1k27, 1k28, 1k29, 1k30, 1k40, 10k6: R_Small; R_0603_1608Metric_Pad0.98x0.95mm_HandSolder
C10: 10uF; C_0603_1608Metric_Pad1.08x0.95mm_HandSolder
D26: D_Zener; D_0603_1608Metric_Pad1.05x0.95mm_HandSolder
D27, D28: Blue; LED_0603_1608Metric_Pad1.05x0.95mm_HandSolder
MC5: VNH5019A_E; MultiPowerSO_30
R11, R12: 1.5k; R_0603_1608Metric_Pad0.98x0.95mm_HandSolder

Connections:
+3V3: 1k28.2, MC5.9 (EN_B/DIAG_B); also elsewhere on the board
+12VA: MC5.3 (VCC), MC5.12 (V_BAT), MC5.13 (VCC), MC5.23 (VCC), MC5.32 (VCC_HEATSLUG); also elsewhere on the board
/Motor_Controller5/IN_A_5: 1k27.2; also elsewhere on the board
/Motor_Controller5/IN_B_5: 1k30.2; also elsewhere on the board
/Motor_Controller5/OUTa_5: MC5.1 (OUT_A), MC5.25 (OUT_A), MC5.30 (OUT_A), MC5.31 (OUT_A_HEATSLUG), R12.1; also elsewhere on the board
/Motor_Controller5/OUTb_5: MC5.15 (OUT_B), MC5.16 (OUT_B), MC5.21 (OUT_B), MC5.33 (OUT_B_HEATSLUG), R11.1; also elsewhere on the board
/Motor_Controller5/PMW_5: 1k29.2; also elsewhere on the board
Current_Sense5: 10k6.2, C10.1, D26.1 (K); also elsewhere on the board
GND: 1k26.2, 1k40.2, C10.2, D26.2 (A), D27.1 (K), D28.1 (K), MC5.18 (GND), MC5.19 (GND), MC5.20 (GND), MC5.26 (GND), MC5.27 (GND), MC5.28 (GND); also elsewhere on the board
unnamed: 1k27.1, MC5.4 (IN_A)
unnamed: 1k28.1, MC5.5 (EN_A/DIAG_A)
unnamed: 1k29.1, MC5.7 (PWM)
unnamed: 1k30.1, MC5.10 (IN_B)
unnamed: 1k40.1, MC5.6 (CS_DIS)
unnamed: 1k26.1, 10k6.1, MC5.8 (CS)
unnamed: D27.2 (A), R11.2
unnamed: D28.2 (A), R12.2

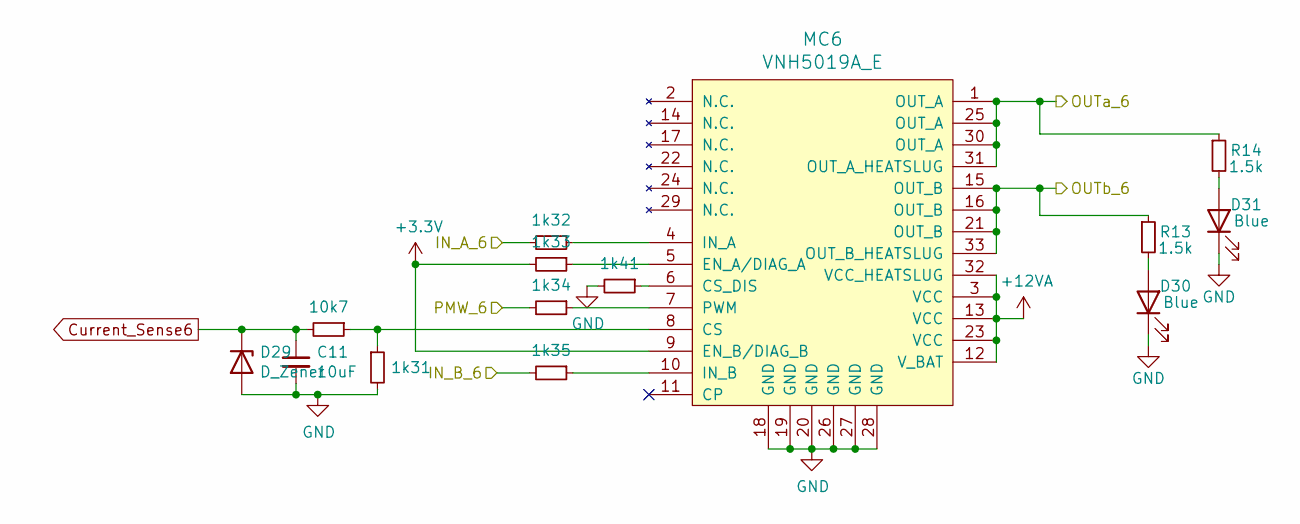
[picture p26: schematic Motor_Controller6.sch, ArmBoard_Hardware]

Parts:
1k31, 1k32, 1k33, 1k34, 1k35, 1k41, 10k7: R_Small; R_0603_1608Metric_Pad0.98x0.95mm_HandSolder
C11: 10uF; C_0603_1608Metric_Pad1.08x0.95mm_HandSolder
D29: D_Zener; D_0603_1608Metric_Pad1.05x0.95mm_HandSolder
D30, D31: Blue; LED_0603_1608Metric_Pad1.05x0.95mm_HandSolder
MC6: VNH5019A_E; MultiPowerSO_30
R13, R14: 1.5k; R_0603_1608Metric_Pad0.98x0.95mm_HandSolder

Connections:
+3V3: 1k33.2, MC6.9 (EN_B/DIAG_B); also elsewhere on the board
+12VA: MC6.3 (VCC), MC6.12 (V_BAT), MC6.13 (VCC), MC6.23 (VCC), MC6.32 (VCC_HEATSLUG); also elsewhere on the board
/Motor_Controller6/IN_A_6: 1k32.2; also elsewhere on the board
/Motor_Controller6/IN_B_6: 1k35.2; also elsewhere on the board
/Motor_Controller6/OUTa_6: MC6.1 (OUT_A), MC6.25 (OUT_A), MC6.30 (OUT_A), MC6.31 (OUT_A_HEATSLUG), R14.1; also elsewhere on the board
/Motor_Controller6/OUTb_6: MC6.15 (OUT_B), MC6.16 (OUT_B), MC6.21 (OUT_B), MC6.33 (OUT_B_HEATSLUG), R13.1; also elsewhere on the board
/Motor_Controller6/PMW_6: 1k34.2; also elsewhere on the board
Current_Sense6: 10k7.2, C11.1, D29.1 (K); also elsewhere on the board
GND: 1k31.2, 1k41.2, C11.2, D29.2 (A), D30.1 (K), D31.1 (K), MC6.18 (GND), MC6.19 (GND), MC6.20 (GND), MC6.26 (GND), MC6.27 (GND), MC6.28 (GND); also elsewhere on the board
unnamed: 1k32.1, MC6.4 (IN_A)
unnamed: 1k33.1, MC6.5 (EN_A/DIAG_A)
unnamed: 1k34.1, MC6.7 (PWM)
unnamed: 1k35.1, MC6.10 (IN_B)
unnamed: 1k41.1, MC6.6 (CS_DIS)
unnamed: 1k31.1, 10k7.1, MC6.8 (CS)
unnamed: D30.2 (A), R13.2
unnamed: D31.2 (A), R14.2

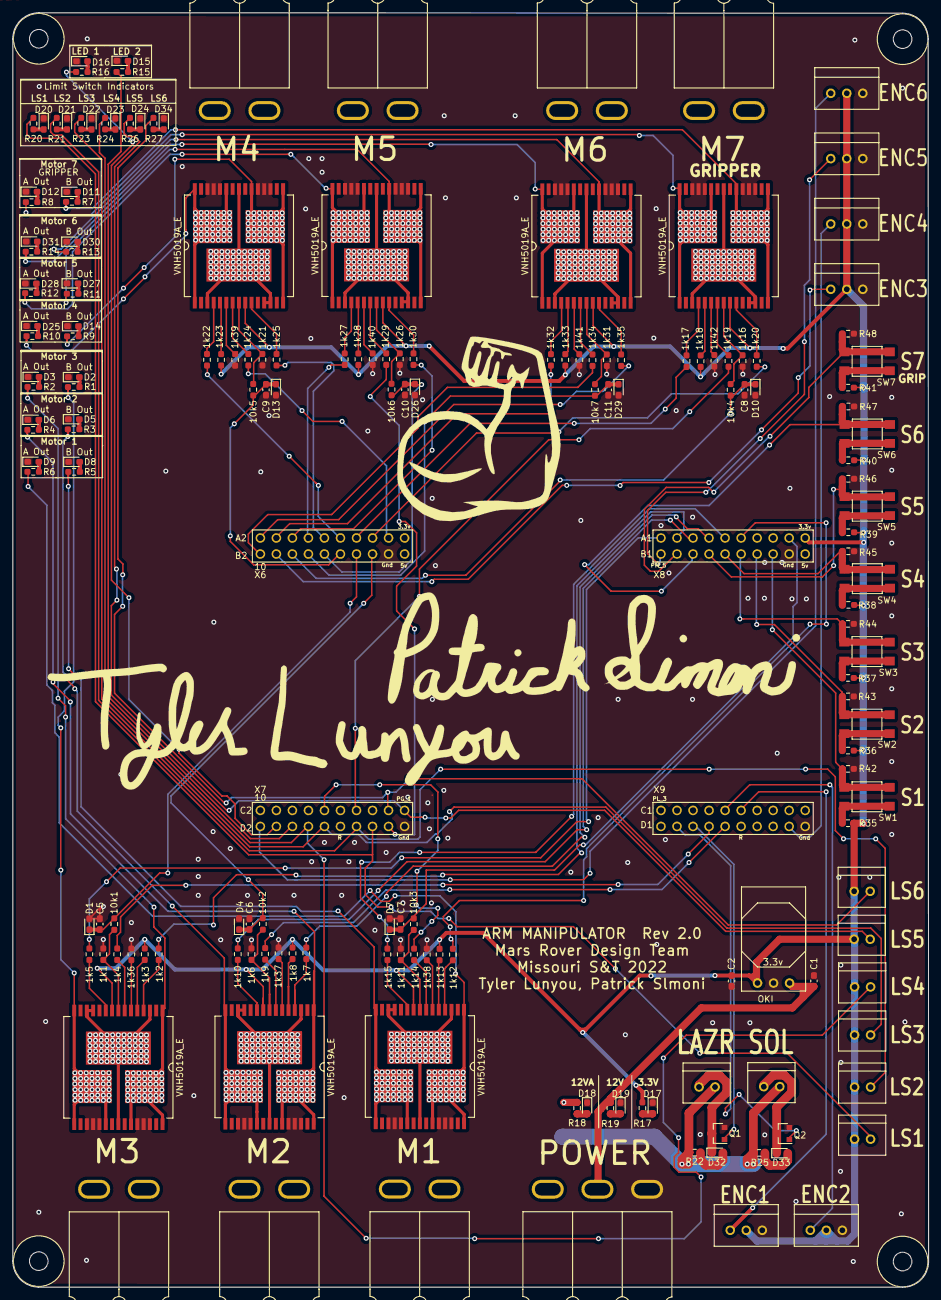
[picture p27: board Hardware/ArmBoard_Hardware/ArmBoard_Hardware.kicad_pcb from above]

Board: 2 copper layers, 145.2 x 202.0 mm, 177 parts (0 on the bottom side), 147 nets.
