MissouriMRDT/ArmBoard_Hardware/Hardware/MotorDriverBreakout/MotorDriverBreakout.kicad_pcb

## KiCad design Hardware/MotorDriverBreakout/MotorDriverBreakout.kicad_pcb (2021-12-30)

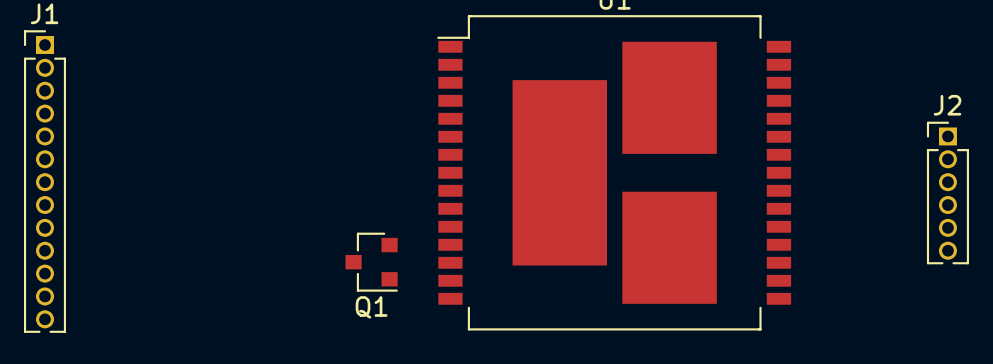
[picture p28: board MotorDriverBreakout.kicad_pcb from above]

Board: 2 copper layers, 4 parts (0 on the bottom side), 11 nets, no tracks yet.

Parts:
J1: Conn_01x13; PinHeader_1x13_P1.27mm_Vertical
J2: Conn_01x06; PinHeader_1x06_P1.27mm_Vertical
Q1: BSN20; SOT-23
U1: VNH5019A-E; ST_MultiPowerSO-30

Connections:
unnamed: J1.1, J1.2, J1.3, U1.6, U1.18, U1.19, U1.20, U1.26, U1.27, U1.28
unnamed: J1.5, U1.9
unnamed: J1.7, U1.5
unnamed: J1.8, U1.7
unnamed: J1.9, U1.10
unnamed: J1.10, U1.4
unnamed: J1.11, J1.12, J1.13, Q1.2, U1.12
unnamed: J2.1, J2.2, J2.3, U1.1, U1.25, U1.30, U1.33
unnamed: J2.4, J2.5, J2.6, U1.15, U1.16, U1.21, U1.32
unnamed: Q1.1, U1.11
unnamed: Q1.3, U1.3, U1.13, U1.23, U1.31
