MissouriMRDT/ArmBoard_Hardware/ArmBoard_Hardware/ArmBoard_Hardware.kicad_pcb

## KiCad design ArmBoard_Hardware/ArmBoard_Hardware.kicad_pcb (2019-12-07, an earlier design)

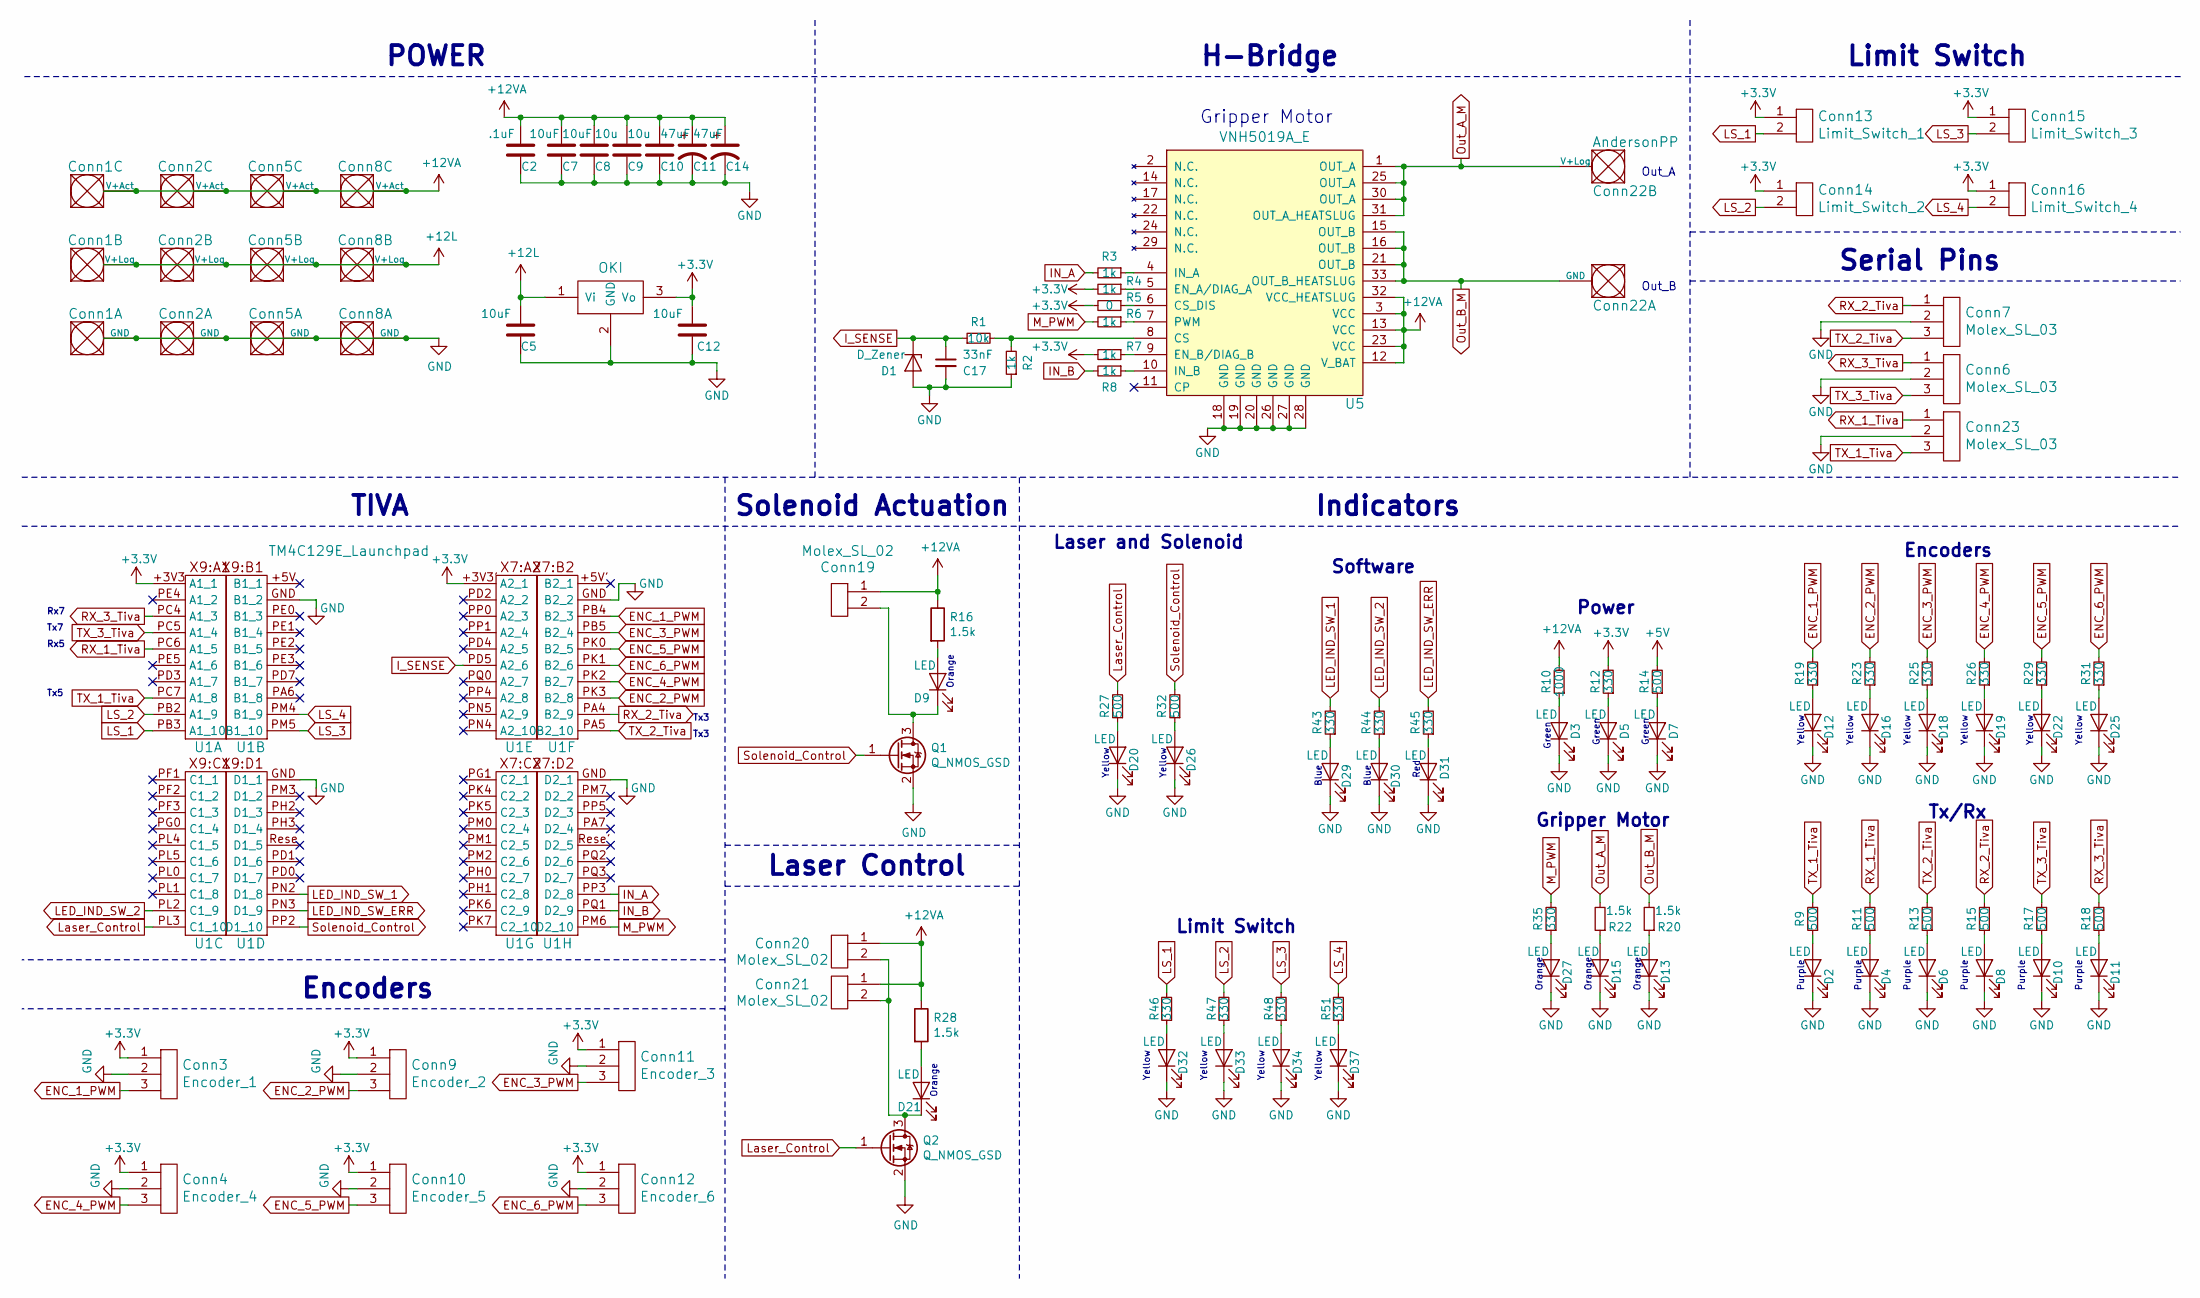
[picture p29: schematic ArmBoard_Hardware.sch]

Parts:
C2: .1uF; C_0603_1608Metric_Pad1.05x0.95mm_HandSolder
C5, C7, C8, C12: 10uF; C_0603_1608Metric_Pad1.05x0.95mm_HandSolder
C9, C10: 10u; C_0603_1608Metric_Pad1.05x0.95mm_HandSolder
C11, C14: 47uF; CP_Radial_D5.0mm_P2.50mm
C17: 33nF; C_0603_1608Metric_Pad1.05x0.95mm_HandSolder
Conn1: AndersonPP; Anderson_3_Horizontal_Side_by_Side
Conn2, Conn5, Conn8: AndersonPP; Anderson_3_Vertical_Side_by_Side
Conn3: Encoder_1; MOLEX_SL_03_Vertical
Conn4: Encoder_4; MOLEX_SL_03_Vertical
Conn6, Conn7, Conn23: Molex_SL_03; MOLEX_SL_03_Vertical
Conn9: Encoder_2; MOLEX_SL_03_Vertical
Conn10: Encoder_5; MOLEX_SL_03_Vertical
Conn11: Encoder_3; MOLEX_SL_03_Vertical
Conn12: Encoder_6; MOLEX_SL_03_Vertical
Conn13: Limit_Switch_1; MOLEX_SL_02_Vertical
Conn14: Limit_Switch_2; MOLEX_SL_02_Vertical
Conn15: Limit_Switch_3; MOLEX_SL_02_Vertical
Conn16: Limit_Switch_4; MOLEX_SL_02_Vertical
Conn19, Conn20, Conn21: Molex_SL_02; MOLEX_SL_02_Vertical
Conn22: AndersonPP; Anderson_2_Vertical_Sidy_by_Side
D1: D_Zener; D_SOD-323_HandSoldering
D2, D3, D4, D5, D6, D7, D8, D9, D10, D11, D12, D13, D15, D16, D18, D19, D20, D21, D22, D25, D26, D27, D29, D30, D31, D32, D33, D34, D37: LED; LED_0603_1608Metric_Pad1.05x0.95mm_HandSolder
Q1, Q2: Q_NMOS_GSD; SOT95P240X112-3N
R1: 10k; R_0603_1608Metric_Pad1.05x0.95mm_HandSolder
R2, R3, R4, R6, R7, R8: 1k; R_0603_1608Metric_Pad1.05x0.95mm_HandSolder
R5: 0; R_0603_1608Metric_Pad1.05x0.95mm_HandSolder
R9, R11, R13, R14, R15, R17, R18, R27, R32: 500; R_0603_1608Metric_Pad1.05x0.95mm_HandSolder
R10: 1000; R_0603_1608Metric_Pad1.05x0.95mm_HandSolder
R12, R19, R23, R25, R26, R29, R31, R35, R43, R44, R45, R46, R47, R48, R51: 330; R_0603_1608Metric_Pad1.05x0.95mm_HandSolder
R16, R20, R22, R28: 1.5k; R_0603_1608Metric_Pad1.05x0.95mm_HandSolder
U1: TM4C129E_Launchpad; TM4C129E_Launchpad_FULL_SMD_BOTTOM
U3: OKI; OKI_Horizontal
U5: VNH5019A_E; MultiPowerSO_30

Connections:
+3V3: C12.2, Conn3.1, Conn4.1, Conn9.1, Conn10.1, Conn11.1, Conn12.1, Conn13.1, Conn14.1, Conn15.1, Conn16.1, R4.2, R5.2, R7.2, R12.2, U1.+3V3 (A1_1), U1.+3V3' (A2_1), U3.3 (Vo)
+12L: C5.2, Conn1.2 (V+Log), Conn2.2 (V+Log), Conn5.2 (V+Log), Conn8.2 (V+Log), U3.1 (Vi)
+12VA: C2.1, C7.1, C8.1, C9.1, C10.1, C11.1, C14.1, Conn1.3 (V+Act), Conn2.3 (V+Act), Conn5.3 (V+Act), Conn8.3 (V+Act), Conn19.1, Conn20.1, Conn21.1, R10.2, R16.1, R28.1, U5.3 (VCC), U5.12 (V_BAT), U5.13 (VCC), U5.23 (VCC), U5.32 (VCC_HEATSLUG)
ENC_1_PWM: Conn3.3, R19.2, U1.PB4 (B2_3)
ENC_2_PWM: Conn9.3, R23.2, U1.PK3 (B2_8)
ENC_3_PWM: Conn11.3, R25.2, U1.PB5 (B2_4)
ENC_4_PWM: Conn4.3, R26.2, U1.PK2 (B2_7)
ENC_5_PWM: Conn10.3, R29.2, U1.PK0 (B2_5)
ENC_6_PWM: Conn12.3, R31.2, U1.PK1 (B2_6)
GND: C2.2, C5.1, C7.2, C8.2, C9.2, C10.2, C11.2, C12.1, C14.2, C17.2, Conn1.1 (GND), Conn2.1 (GND), Conn3.2, Conn4.2, Conn5.1 (GND), Conn6.2, Conn7.2, Conn8.1 (GND), Conn9.2, Conn10.2, Conn11.2, Conn12.2, Conn23.2, D1.2 (A), D2.1 (K), D3.1 (K), D4.1 (K), D5.1 (K), D6.1 (K), D7.1 (K), D8.1 (K), D10.1 (K), D11.1 (K), D12.1 (K), D13.1 (K), D15.1 (K), D16.1 (K), D18.1 (K), D19.1 (K), D20.1 (K), D22.1 (K), D25.1 (K), D26.1 (K), D27.1 (K), D29.1 (K), D30.1 (K), D31.1 (K), D32.1 (K), D33.1 (K), D34.1 (K), D37.1 (K), Q1.2 (S), Q2.2 (S), R2.1, U1.GND (B1_2), U3.2 (GND), U5.18 (GND), U5.19 (GND), U5.20 (GND), U5.26 (GND), U5.27 (GND), U5.28 (GND)
IN_A: R3.2, U1.PP3 (D2_8)
IN_B: R8.2, U1.PQ1 (D2_9)
I_SENSE: C17.1, D1.1 (K), R1.1, U1.PD5 (A2_6)
LED_IND_SW_1: R43.2, U1.PN2 (D1_8)
LED_IND_SW_2: R44.2, U1.PL2 (C1_9)
LED_IND_SW_ERR: R45.2, U1.PN3 (D1_9)
LS_1: Conn13.2, R46.2, U1.PB3 (A1_10)
LS_2: Conn14.2, R47.2, U1.PB2 (A1_9)
LS_3: Conn15.2, R48.2, U1.PM5 (B1_10)
LS_4: Conn16.2, R51.2, U1.PM4 (B1_9)
Laser_Control: Q2.1 (G), R27.2, U1.PL3 (C1_10)
M_PWM: R6.2, R35.2, U1.PM6 (D2_10)
unnamed: Conn19.2, D9.1 (K), Q1.3 (D)
unnamed: Conn20.2, Conn21.2, D21.1 (K), Q2.3 (D)
unnamed: D2.2 (A), R9.1
unnamed: D3.2 (A), R10.1
unnamed: D4.2 (A), R11.1
unnamed: D5.2 (A), R12.1
unnamed: D6.2 (A), R13.1
unnamed: D7.2 (A), R14.1
unnamed: D8.2 (A), R15.1
unnamed: D9.2 (A), R16.2
unnamed: D10.2 (A), R17.1
unnamed: D11.2 (A), R18.1
unnamed: D12.2 (A), R19.1
unnamed: D13.2 (A), R20.1
unnamed: D15.2 (A), R22.1
unnamed: D16.2 (A), R23.1
unnamed: D18.2 (A), R25.1
unnamed: D19.2 (A), R26.1
unnamed: D20.2 (A), R27.1
unnamed: D21.2 (A), R28.2
unnamed: D22.2 (A), R29.1
unnamed: D25.2 (A), R31.1
unnamed: D26.2 (A), R32.1
unnamed: D27.2 (A), R35.1
unnamed: D29.2 (A), R43.1
unnamed: D30.2 (A), R44.1
unnamed: D31.2 (A), R45.1
unnamed: D32.2 (A), R46.1
unnamed: D33.2 (A), R47.1
unnamed: D34.2 (A), R48.1
unnamed: D37.2 (A), R51.1
unnamed: R1.2, R2.2, U5.8 (CS)
unnamed: R3.1, U5.4 (IN_A)
unnamed: R4.1, U5.5 (EN_A/DIAG_A)
unnamed: R5.1, U5.6 (CS_DIS)
unnamed: R6.1, U5.7 (PWM)
unnamed: R7.1, U5.9 (EN_B/DIAG_B)
unnamed: R8.1, U5.10 (IN_B)
Out_A_M: Conn22.2 (V+Log), R22.2, U5.1 (OUT_A), U5.25 (OUT_A), U5.30 (OUT_A), U5.31 (OUT_A_HEATSLUG)
Out_B_M: Conn22.1 (GND), R20.2, U5.15 (OUT_B), U5.16 (OUT_B), U5.21 (OUT_B), U5.33 (OUT_B_HEATSLUG)
RX_1_Tiva: Conn23.1, R11.2, U1.PC6 (A1_5)
RX_2_Tiva: Conn7.1, R15.2, U1.PA4 (B2_9)
RX_3_Tiva: Conn6.1, R18.2, U1.PC4 (A1_3)
Solenoid_Control: Q1.1 (G), R32.2, U1.PP2 (D1_10)
TX_1_Tiva: Conn23.3, R9.2, U1.PC7 (A1_8)
TX_2_Tiva: Conn7.3, R13.2, U1.PA5 (B2_10)
TX_3_Tiva: Conn6.3, R17.2, U1.PC5 (A1_4)

Notes on the sheet:
Limit Switch
Gripper Motor
H-Bridge
Out_A
Out_B
Indicators
Yellow
Green
Green
Serial Pins
Solenoid Actuation
Orange
Power
Encoders
POWER
Laser Control
Software
Red
Blue
Limit Switch
TIVA
Purple
Tx/Rx
Laser and Solenoid
Rx7
Tx7
Rx5
Tx5
Tx3

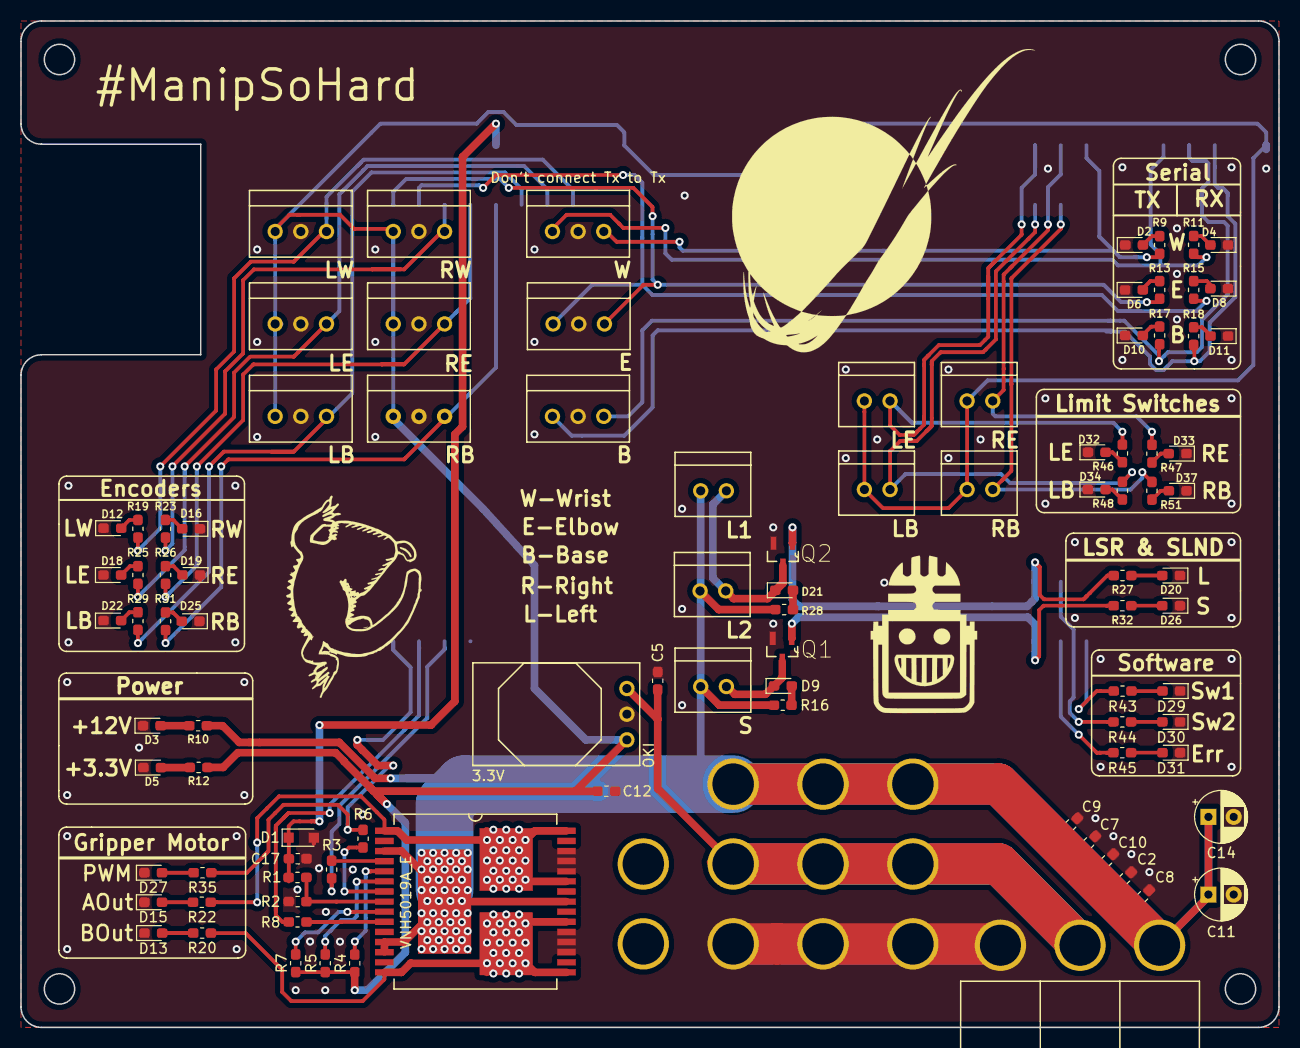
[picture p30: board ArmBoard_Hardware/ArmBoard_Hardware.kicad_pcb from above]

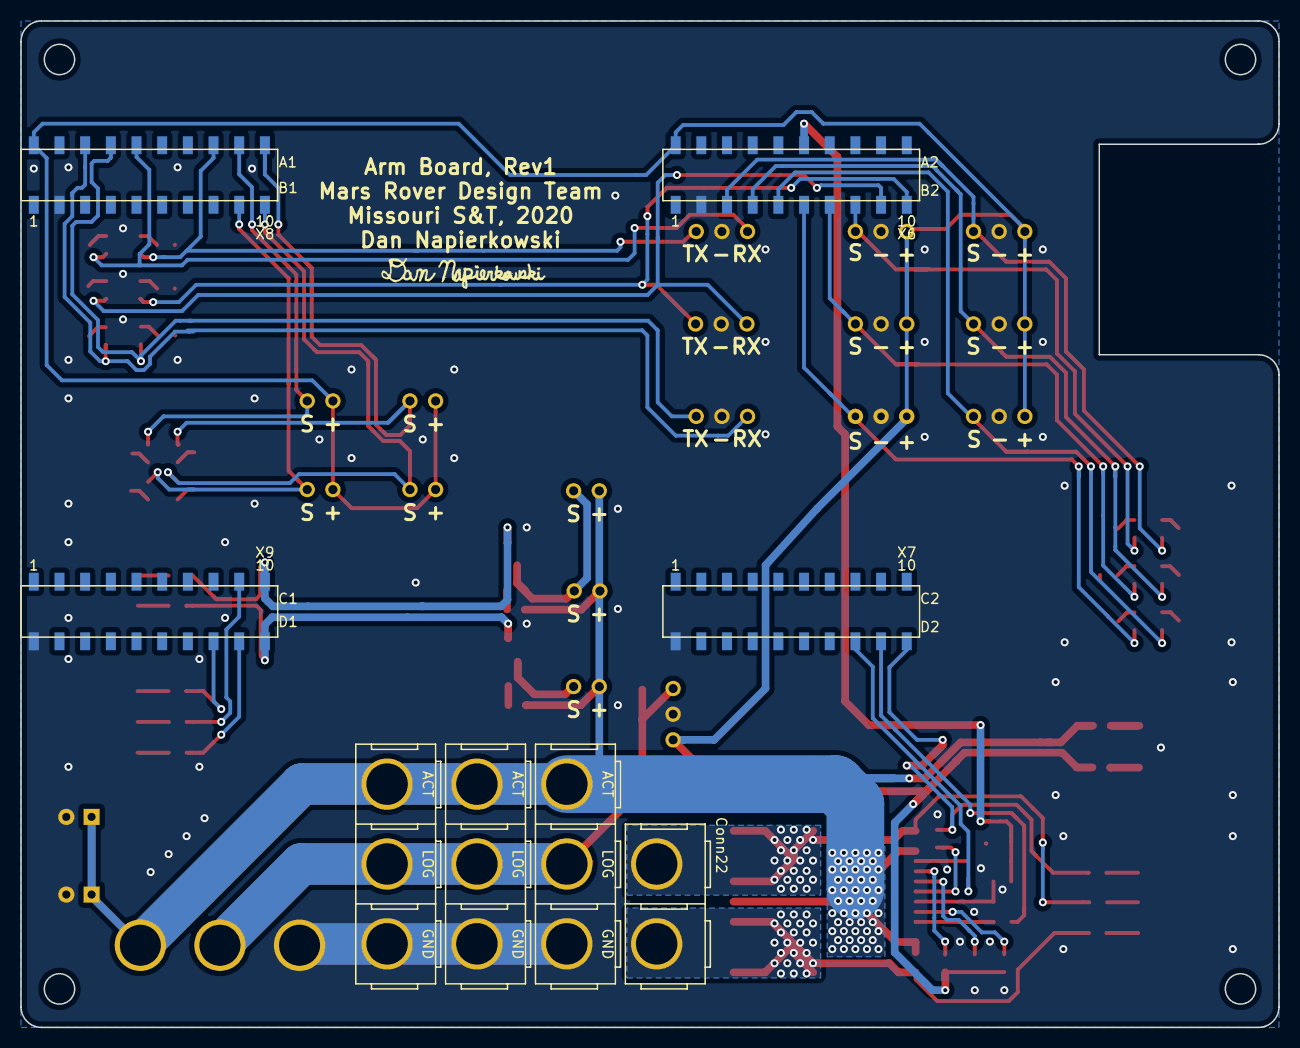
[picture p31: board ArmBoard_Hardware/ArmBoard_Hardware.kicad_pcb from below]

Board: 2 copper layers, 124.5 x 99.6 mm, 101 parts (4 on the bottom side), 68 nets.
