MissouriMRDT/ArmBoard_Hardware/arm board/Arm_Board_2018.brd

## EAGLE design arm board/Arm_Board_2018.brd (2018-02-02)

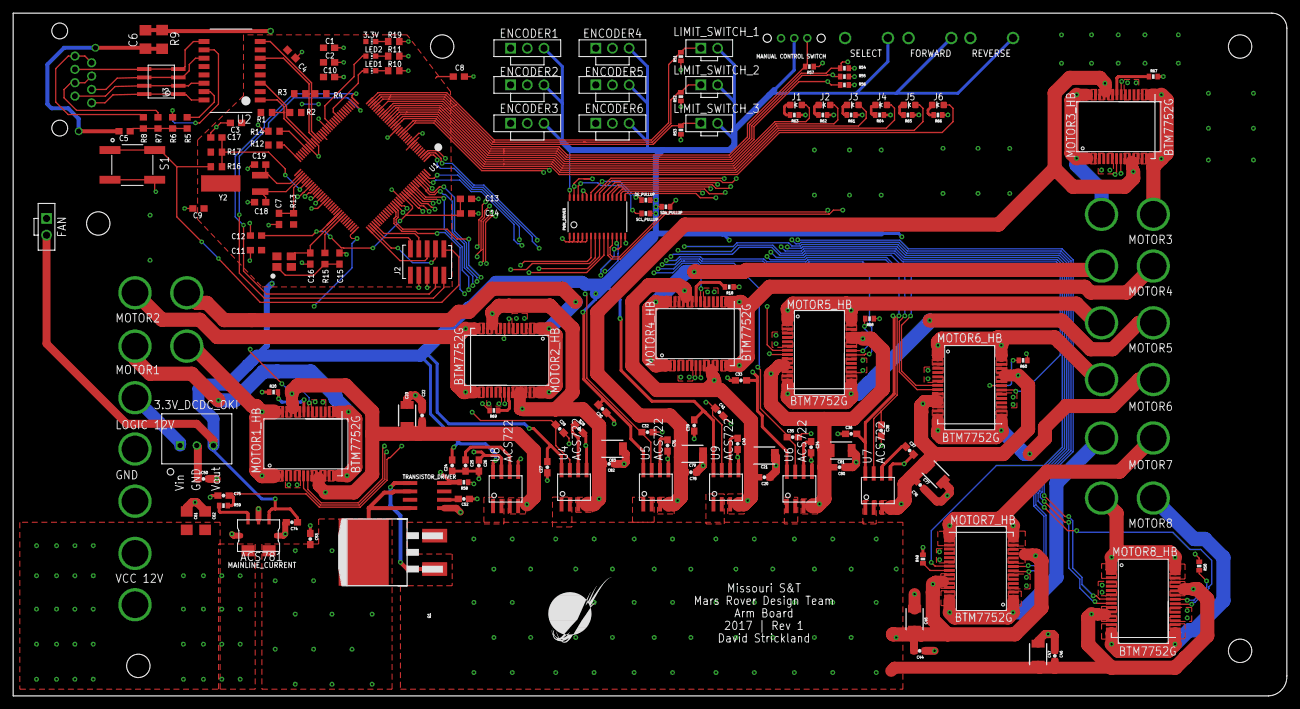
[picture p32: board Arm_Board_2018.brd from above]

Board: 4 copper layers, 193.8 x 103.9 mm, 173 parts (0 on the bottom side), 142 nets.

Parts:
3.3V: ORANGE; CHIP-LED0603
3.3V_DCDC_OKI: Q_OKI-78SR
12V_LOGIC_IN: APPPP45_PCB_HORIZ_RIGHT; APP45_PCB_HORIZ_RIGHT
C1, C2, C3, C4, C7, C8, C9, C10, C11, C12, C17: 0.1uF; C0603
C5: 1000pF; C0603
C6: 4700pF; C1206
C13: 1.0uF; C0603
C14: 2.2uF; C0603
C15, C16, C18, C19: 12pF; C0603
C20, C22, C44, C46, C76, C78, C80, C82: .1uF; 0603-CAP
C21, C23, C45, C47, C77, C79, C81, C83: 100uF; 1210
C24, C26, C27, C29, C30, C32, C33, C35, C36, C38, C39, C41, C74: 0.1uF; 0603-CAP
C25, C28, C31, C34, C37, C40, C75: 1nF; 0603-CAP
C50: 2.2uF; 0603-CAP
C52: 1.0uF; 0603-CAP
C53: 10uF; 0603-CAP
C61, C62: 2.2uF; 1206
D1: J1; LED-0603
D2: J2; LED-0603
D3: J3; LED-0603
D4: J4; LED-0603
D5: J5; LED-0603
D6: J6; LED-0603
ENCODER1, ENCODER2, ENCODER3, ENCODER4, ENCODER5, ENCODER6: ENCODER; MOLEX-70543-0002
FAN: SL02; MOLEX-70543-0001
GND: APPPP45_PCB_HORIZ_RIGHT; APP45_PCB_HORIZ_RIGHT
GROUND: APPPP45_PCB_HORIZ_RIGHT; APP45_PCB_HORIZ_RIGHT
J1: RJ45KEYSTONE-942; KEYSTONE-942
J2: JTAG_ARM_10PIN; CON_2X5_50MIL
LED1, LED2: GREEN; CHIP-LED0603
LIMIT_SWITCH_1, LIMIT_SWITCH_2, LIMIT_SWITCH_3: SL02; MOLEX-70543-0001
MAINLINE_CURRENT: ACS781; 7-POWER_SMD_MODULE
MOTOR1, MOTOR2, MOTOR3, MOTOR4, MOTOR5, MOTOR6, MOTOR7, MOTOR8: APP_2POS_CONFIGGENERAL_CONFIG; APP45_HORIZ_CONFIG
MOTOR1_HB, MOTOR2_HB, MOTOR3_HB, MOTOR4_HB, MOTOR5_HB, MOTOR6_HB, MOTOR7_HB, MOTOR8_HB: BTM7752G; 36-BSSOP
OE_PULLUP: 10K; 0402-RES
POWER_12V, POWER_12V2: APPPP45_PCB_HORIZ_RIGHT; APP45_PCB_HORIZ_RIGHT
PWM_DRIVER: TSSOP28
Q1: Q_IRF7437SMD; D2PACK
R1, R3, R4: 49.9; R0603
R2: 49.4; R0603
R5, R6, R7, R8: 75; R0603
R9: 1M; R1206
R10, R11, R19: 330; R0603
R12: 1M; R0603
R13: 51; R0603
R14: 4.87k 1%; R0603
R15: 2k; R0603
R16: 100; R0603
R17: 10k; R0603
R18, R20, R49, R50, R51, R52, R53, R58, R60, R67, R68, R69: 10K; 0402-RES
R54, R55, R56, R57: 10k; 0402-RES
R59: 1K; 0402-RES
R61, R62, R63, R64, R65, R66: 330; 0402-RES
S1: SWITCH_TACTILE; SWITCH_6MM_6MM_TE_CON_SMD
S2, S3, S4: PUSHBUTTONVERT; APEM-MJTP1243
S5: SWITCH-SPDTVERT; C&K-SS12D07VG4NSGAPA
SCL_PULLUP: 1K; 0402-RES
SDA_PULLUP: 1K; 0402-RES
TRANSISTOR_DRIVER: LT1910; SO8
U1: TM4C1294NCPDT; TQFP-128
U2: HX1198FNL
U3: SLVU2.8-4; SOIC8
U4, U5, U6, U7, U8, U9: ACS722; SOIC8
U$1: MRDT_LOGO
U$2, U$3, U$4, U$5, U$30: MOUNTING_HOLE#6; #6_SCREW
Y1: NX3225GA; NDK3.2X2.5
Y2: CRYATL_32K_SMD; CRYSTAL_32K_SMD

Connections:
12VMOTOR_POWER: C44.2, C45.2, C46.2, C47.2, MOTOR7_HB.11, MOTOR7_HB.12, MOTOR7_HB.13, MOTOR7_HB.14, MOTOR7_HB.29, MOTOR7_HB.30, MOTOR7_HB.31, MOTOR7_HB.32, MOTOR8_HB.11, MOTOR8_HB.12, MOTOR8_HB.13, MOTOR8_HB.14, MOTOR8_HB.29, MOTOR8_HB.30, MOTOR8_HB.31, MOTOR8_HB.32, Q1.2, U4.1, U4.2, U5.1, U5.2, U6.1, U6.2, U7.1, U7.2, U8.1, U8.2, U9.1, U9.2
!RESET: J2.P10, R16.2, S1.P$3, S1.P$4
BUTTON1: R56.1, S2.P$2, U1.P$24
BUTTON2: R55.1, S3.P$2, U1.P$25
BUTTON3: R54.1, S4.P$2, U1.P$27
EN0LED0: LED1.A, U1.P$42
EN0LED1: LED2.A, U1.P$46
EN0RXI_N: R4.2, U1.P$53, U2.P$8
EN0RXI_P: R3.2, U1.P$54, U2.P$6
EN0TXO_N: R2.2, U1.P$56, U2.P$3
EN0TXO_P: R1.2, U1.P$57, U2.P$1
ENCODER_1: ENCODER1.2, U1.P$3
ENCODER_2: ENCODER2.2, U1.P$125
ENCODER_3: ENCODER3.2, U1.P$78
ENCODER_4: ENCODER4.2, U1.P$76
ENCODER_5: ENCODER5.2, U1.P$74
ENCODER_6: ENCODER6.2, U1.P$72
GND: C1.2, C2.2, C3.2, C4.2, C6.2, C7.2, C8.2, C9.2, C10.2, C11.2, C12.2, C13.2, C14.2, C15.2, C16.2, C17.2, C18.2, C19.2, C20.1, C21.1, C22.1, C23.1, C24.1, C25.2, C26.2, C27.1, C28.2, C29.2, C30.1, C31.2, C32.2, C33.1, C34.2, C35.2, C36.1, C37.2, C38.2, C39.1, C40.2, C41.2, C44.1, C45.1, C46.1, C47.1, C50.2, C52.2, C53.1, C61.1, C62.1, C74.2, C75.2, C76.1, C77.1, C78.1, C79.1, C80.1, C81.1, C82.1, C83.1, ENCODER1.1, ENCODER2.1, ENCODER3.1, ENCODER4.1, ENCODER5.1, ENCODER6.1, FAN.1, GND.P$1, GROUND.P$1, J2.P3, J2.P5, MAINLINE_CURRENT.2, MAINLINE_CURRENT.4, MAINLINE_CURRENT.7, MOTOR1_HB.5, MOTOR1_HB.6, MOTOR1_HB.7, MOTOR1_HB.8, MOTOR1_HB.23, MOTOR1_HB.24, MOTOR1_HB.25, MOTOR1_HB.26, MOTOR2_HB.5, MOTOR2_HB.6, MOTOR2_HB.7, MOTOR2_HB.8, MOTOR2_HB.23, MOTOR2_HB.24, MOTOR2_HB.25, MOTOR2_HB.26, MOTOR3_HB.5, MOTOR3_HB.6, MOTOR3_HB.7, MOTOR3_HB.8, MOTOR3_HB.23, MOTOR3_HB.24, MOTOR3_HB.25, MOTOR3_HB.26, MOTOR4_HB.5, MOTOR4_HB.6, MOTOR4_HB.7, MOTOR4_HB.8, MOTOR4_HB.23, MOTOR4_HB.24, MOTOR4_HB.25, MOTOR4_HB.26, MOTOR5_HB.5, MOTOR5_HB.6, MOTOR5_HB.7, MOTOR5_HB.8, MOTOR5_HB.23, MOTOR5_HB.24, MOTOR5_HB.25, MOTOR5_HB.26, MOTOR6_HB.5, MOTOR6_HB.6, MOTOR6_HB.7, MOTOR6_HB.8, MOTOR6_HB.23, MOTOR6_HB.24, MOTOR6_HB.25, MOTOR6_HB.26, MOTOR7_HB.5, MOTOR7_HB.6, MOTOR7_HB.7, MOTOR7_HB.8, MOTOR7_HB.23, MOTOR7_HB.24, MOTOR7_HB.25, MOTOR7_HB.26, MOTOR8_HB.5, MOTOR8_HB.6, MOTOR8_HB.7, MOTOR8_HB.8, MOTOR8_HB.23, MOTOR8_HB.24, MOTOR8_HB.25, MOTOR8_HB.26, PWM_DRIVER.1, PWM_DRIVER.2, PWM_DRIVER.3, PWM_DRIVER.4, PWM_DRIVER.5, PWM_DRIVER.14, PWM_DRIVER.24, PWM_DRIVER.25, R9.1, R10.2, R11.2, R14.1, R18.1, R19.2, R20.1, R49.1, R50.1, R51.1, R52.1, R53.1, R54.2, R55.2, R56.2, R57.2, R58.1, R60.1, R61.1, R62.1, R63.1, R64.1, R65.1, R66.1, R67.1, R68.1, R69.1, S1.P$1, S1.P$2, TRANSISTOR_DRIVER.1, U1.P$10, U1.P$17, U1.P$48, U1.P$55, U1.P$58, U1.P$80, U1.P$114, U4.5, U5.5, U6.5, U7.5, U8.5, U9.5
LED1: D1.A, U1.P$23
LED2: D2.A, U1.P$22
LED3: D3.A, U1.P$21
LED4: D4.A, U1.P$20
LED5: D5.A, U1.P$19
LED6: D6.A, U1.P$18
LIMIT_SWITCH_1: LIMIT_SWITCH_1.1, R51.2, U1.P$32
LIMIT_SWITCH_2: LIMIT_SWITCH_2.1, R52.2, U1.P$31
LIMIT_SWITCH_3: LIMIT_SWITCH_3.1, R53.2, U1.P$30
LOGIC_3.3V: 3.3V.A, 3.3V_DCDC_OKI.3, C1.1, C2.1, C3.1, C4.1, C8.1, C9.1, C10.1, C11.1, C24.2, C27.2, C30.2, C33.2, C36.2, C39.2, C74.1, ENCODER1.3, ENCODER2.3, ENCODER3.3, ENCODER4.3, ENCODER5.3, ENCODER6.3, FAN.2, J2.P1, LIMIT_SWITCH_1.2, LIMIT_SWITCH_2.2, LIMIT_SWITCH_3.2, MAINLINE_CURRENT.1, OE_PULLUP.1, PWM_DRIVER.28, R1.1, R2.1, R3.1, R4.1, R12.2, R13.2, R17.1, S2.P$1, S3.P$1, S4.P$1, S5.P$2, SCL_PULLUP.1, SDA_PULLUP.1, U1.P$7, U1.P$8, U1.P$9, U1.P$16, U1.P$26, U1.P$28, U1.P$39, U1.P$47, U1.P$51, U1.P$52, U1.P$69, U1.P$79, U1.P$90, U1.P$101, U1.P$113, U1.P$122, U2.P$2, U2.P$7, U4.8, U5.8, U6.8, U7.8, U8.8, U9.8
MAINLINE_CURRENT_SENSOR: C75.1, R59.1, U1.P$121
MASTER_POWER_ENABLE: R58.2, TRANSISTOR_DRIVER.4, U1.P$109
MOTOR1_1: MOTOR1.C2, MOTOR1_HB.1, MOTOR1_HB.2, MOTOR1_HB.3, MOTOR1_HB.4, MOTOR1_HB.33, MOTOR1_HB.34, MOTOR1_HB.35, MOTOR1_HB.36
MOTOR1_2: MOTOR1.C1, MOTOR1_HB.15, MOTOR1_HB.16, MOTOR1_HB.17, MOTOR1_HB.18, MOTOR1_HB.19, MOTOR1_HB.20, MOTOR1_HB.21, MOTOR1_HB.22
MOTOR1_CURRENT_SENSOR: C26.1, U1.P$123, U8.7
MOTOR1_ENABLE: MOTOR1_HB.27, U1.P$96
MOTOR1_POWER: C22.2, C23.2, MOTOR1_HB.11, MOTOR1_HB.12, MOTOR1_HB.13, MOTOR1_HB.14, MOTOR1_HB.29, MOTOR1_HB.30, MOTOR1_HB.31, MOTOR1_HB.32, U8.3, U8.4
MOTOR1_PWM1: MOTOR1_HB.9, PWM_DRIVER.6
MOTOR1_PWM2: MOTOR1_HB.10, PWM_DRIVER.7
MOTOR2_1: MOTOR2.C2, MOTOR2_HB.1, MOTOR2_HB.2, MOTOR2_HB.3, MOTOR2_HB.4, MOTOR2_HB.33, MOTOR2_HB.34, MOTOR2_HB.35, MOTOR2_HB.36
MOTOR2_2: MOTOR2.C1, MOTOR2_HB.15, MOTOR2_HB.16, MOTOR2_HB.17, MOTOR2_HB.18, MOTOR2_HB.19, MOTOR2_HB.20, MOTOR2_HB.21, MOTOR2_HB.22
MOTOR2_CURRENT_SENSOR: C29.1, U1.P$124, U4.7
MOTOR2_ENABLE: MOTOR2_HB.27, U1.P$110
MOTOR2_POWER: C82.2, C83.2, MOTOR2_HB.11, MOTOR2_HB.12, MOTOR2_HB.13, MOTOR2_HB.14, MOTOR2_HB.29, MOTOR2_HB.30, MOTOR2_HB.31, MOTOR2_HB.32, U4.3, U4.4
MOTOR2_PWM1: MOTOR2_HB.9, PWM_DRIVER.8
MOTOR2_PWM2: MOTOR2_HB.10, PWM_DRIVER.9
MOTOR3_1: MOTOR3.C2, MOTOR3_HB.1, MOTOR3_HB.2, MOTOR3_HB.3, MOTOR3_HB.4, MOTOR3_HB.33, MOTOR3_HB.34, MOTOR3_HB.35, MOTOR3_HB.36
MOTOR3_2: MOTOR3.C1, MOTOR3_HB.15, MOTOR3_HB.16, MOTOR3_HB.17, MOTOR3_HB.18, MOTOR3_HB.19, MOTOR3_HB.20, MOTOR3_HB.21, MOTOR3_HB.22
MOTOR3_CURRENT_SENSOR: C32.1, U1.P$126, U5.7
MOTOR3_ENABLE: MOTOR3_HB.27, U1.P$15
MOTOR3_POWER: C78.2, C79.2, MOTOR3_HB.11, MOTOR3_HB.12, MOTOR3_HB.13, MOTOR3_HB.14, MOTOR3_HB.29, MOTOR3_HB.30, MOTOR3_HB.31, MOTOR3_HB.32, U5.3, U5.4
MOTOR3_PWM1: MOTOR3_HB.9, PWM_DRIVER.10
MOTOR3_PWM2: MOTOR3_HB.10, PWM_DRIVER.11
MOTOR4_1: MOTOR4.C2, MOTOR4_HB.1, MOTOR4_HB.2, MOTOR4_HB.3, MOTOR4_HB.4, MOTOR4_HB.33, MOTOR4_HB.34, MOTOR4_HB.35, MOTOR4_HB.36
MOTOR4_2: MOTOR4.C1, MOTOR4_HB.15, MOTOR4_HB.16, MOTOR4_HB.17, MOTOR4_HB.18, MOTOR4_HB.19, MOTOR4_HB.20, MOTOR4_HB.21, MOTOR4_HB.22
MOTOR4_CURRENT_SENSOR: C41.1, U1.P$127, U9.7
MOTOR4_ENABLE: MOTOR4_HB.27, U1.P$116
MOTOR4_POWER: C20.2, C21.2, MOTOR4_HB.11, MOTOR4_HB.12, MOTOR4_HB.13, MOTOR4_HB.14, MOTOR4_HB.29, MOTOR4_HB.30, MOTOR4_HB.31, MOTOR4_HB.32, U9.3, U9.4
MOTOR4_PWM1: MOTOR4_HB.9, PWM_DRIVER.12
MOTOR4_PWM2: MOTOR4_HB.10, PWM_DRIVER.13
MOTOR5_1: MOTOR5.C2, MOTOR5_HB.1, MOTOR5_HB.2, MOTOR5_HB.3, MOTOR5_HB.4, MOTOR5_HB.33, MOTOR5_HB.34, MOTOR5_HB.35, MOTOR5_HB.36
MOTOR5_2: MOTOR5.C1, MOTOR5_HB.15, MOTOR5_HB.16, MOTOR5_HB.17, MOTOR5_HB.18, MOTOR5_HB.19, MOTOR5_HB.20, MOTOR5_HB.21, MOTOR5_HB.22
MOTOR5_CURRENT_SENSOR: C35.1, U1.P$1, U6.7
MOTOR5_ENABLE: MOTOR5_HB.27, U1.P$117
MOTOR5_POWER: C80.2, C81.2, MOTOR5_HB.11, MOTOR5_HB.12, MOTOR5_HB.13, MOTOR5_HB.14, MOTOR5_HB.29, MOTOR5_HB.30, MOTOR5_HB.31, MOTOR5_HB.32, U6.3, U6.4
MOTOR5_PWM1: MOTOR5_HB.9, PWM_DRIVER.15
MOTOR5_PWM2: MOTOR5_HB.10, PWM_DRIVER.16
MOTOR6_1: MOTOR6.C2, MOTOR6_HB.1, MOTOR6_HB.2, MOTOR6_HB.3, MOTOR6_HB.4, MOTOR6_HB.33, MOTOR6_HB.34, MOTOR6_HB.35, MOTOR6_HB.36
MOTOR6_2: MOTOR6.C1, MOTOR6_HB.15, MOTOR6_HB.16, MOTOR6_HB.17, MOTOR6_HB.18, MOTOR6_HB.19, MOTOR6_HB.20, MOTOR6_HB.21, MOTOR6_HB.22
MOTOR6_CURRENT_SENSOR: C38.1, U1.P$2, U7.7
MOTOR6_ENABLE: MOTOR6_HB.27, U1.P$118
MOTOR6_POWER: C76.2, C77.2, MOTOR6_HB.11, MOTOR6_HB.12, MOTOR6_HB.13, MOTOR6_HB.14, MOTOR6_HB.29, MOTOR6_HB.30, MOTOR6_HB.31, MOTOR6_HB.32, U7.3, U7.4
MOTOR6_PWM1: MOTOR6_HB.9, PWM_DRIVER.17
MOTOR6_PWM2: MOTOR6_HB.10, PWM_DRIVER.18
MOTOR7_1: MOTOR7.C2, MOTOR7_HB.1, MOTOR7_HB.2, MOTOR7_HB.3, MOTOR7_HB.4, MOTOR7_HB.33, MOTOR7_HB.34, MOTOR7_HB.35, MOTOR7_HB.36
MOTOR7_2: MOTOR7.C1, MOTOR7_HB.15, MOTOR7_HB.16, MOTOR7_HB.17, MOTOR7_HB.18, MOTOR7_HB.19, MOTOR7_HB.20, MOTOR7_HB.21, MOTOR7_HB.22
MOTOR7_ENABLE: MOTOR7_HB.27, U1.P$119
MOTOR7_PWM1: MOTOR7_HB.9, PWM_DRIVER.19
MOTOR7_PWM2: MOTOR7_HB.10, PWM_DRIVER.20
MOTOR8_1: MOTOR8.C2, MOTOR8_HB.1, MOTOR8_HB.2, MOTOR8_HB.3, MOTOR8_HB.4, MOTOR8_HB.33, MOTOR8_HB.34, MOTOR8_HB.35, MOTOR8_HB.36
MOTOR8_2: MOTOR8.C1, MOTOR8_HB.15, MOTOR8_HB.16, MOTOR8_HB.17, MOTOR8_HB.18, MOTOR8_HB.19, MOTOR8_HB.20, MOTOR8_HB.21, MOTOR8_HB.22
MOTOR8_ENABLE: MOTOR8_HB.27, U1.P$120
MOTOR8_PWM1: MOTOR8_HB.9, PWM_DRIVER.21
MOTOR8_PWM2: MOTOR8_HB.10, PWM_DRIVER.22
unnamed: 3.3V_DCDC_OKI.2, C50.1
unnamed: MOTOR4_HB.28, R18.2
unnamed: MOTOR1_HB.28, R20.2
unnamed: C28.1, U4.6
unnamed: 3.3V_DCDC_OKI.1, 12V_LOGIC_IN.P$1
unnamed: C52.1, TRANSISTOR_DRIVER.2
unnamed: C25.1, U8.6
unnamed: C31.1, U5.6
unnamed: C34.1, U6.6
unnamed: C37.1, U7.6
unnamed: C40.1, U9.6
unnamed: MOTOR6_HB.28, R60.2
unnamed: Q1.1, TRANSISTOR_DRIVER.5
unnamed: MOTOR3_HB.28, R67.2
unnamed: MOTOR8_HB.28, R50.2
unnamed: C53.2, MAINLINE_CURRENT.6, Q1.TAB, TRANSISTOR_DRIVER.6, TRANSISTOR_DRIVER.8
unnamed: MOTOR7_HB.28, R49.2
unnamed: MOTOR5_HB.28, R68.2
unnamed: MOTOR2_HB.28, R69.2
unnamed: D1.C, R63.2
unnamed: D2.C, R62.2
unnamed: D6.C, R66.2
unnamed: D3.C, R61.2
unnamed: D4.C, R64.2
unnamed: D5.C, R65.2
unnamed: MAINLINE_CURRENT.3, R59.2
N_$1: R5.2, U2.P$15
N_$3: R6.2, U2.P$10
N_$4: J1.P$7, U2.P$14, U3.2, U3.7
N_$5: J1.P$6, U2.P$11, U3.3, U3.6
N_$6: J1.P$8, U2.P$16, U3.1, U3.8
N_$7: J1.P$3, U2.P$9, U3.4, U3.5
N_$8: LED2.C, R11.1
N_$9: LED1.C, R10.1
N_$10: C7.1, R13.1, U1.P$68
N_$11: J1.P$4, J1.P$5, R7.2
N_$12: R12.1, U1.P$64
N_$13: J1.P$1, J1.P$2, R8.2
N_$14: C5.1, R5.1, R6.1, R7.1, R8.1
N_$15: C5.2, C6.1, R9.2
N_$16: C12.1, C13.1, C14.1, U1.P$87, U1.P$115
N_$17: R15.2, U1.P$89
N_$18: C16.1, U1.P$88, Y1.P$3
N_$19: R14.2, U1.P$59
N_$20: C17.1, R16.1, R17.2, U1.P$70
N_$21: C15.1, R15.1, Y1.P$1
N_$22: C18.1, U1.P$67, Y2.P$2
N_$23: C19.1, U1.P$66, Y2.P$1
N_$26: 3.3V.C, R19.1
PWM_DRIVER_SCL: PWM_DRIVER.26, SCL_PULLUP.2, U1.P$112
PWM_DRIVER_SDA: PWM_DRIVER.27, SDA_PULLUP.2, U1.P$111
PWM_OUTPUT_ENABLE: OE_PULLUP.2, PWM_DRIVER.23, U1.P$14
RX: J2.P7, U1.P$33
SWITCH: R57.1, S5.P$3, U1.P$29
TARGET_TCK/SWCLK: J2.P4, U1.P$100
TARGET_TDI: J2.P8, U1.P$98
TARGET_TDO/SWO: J2.P6, U1.P$97
TARGET_TMS/SWDIO: J2.P2, U1.P$99
TX: J2.P9, U1.P$34
VCC_12V: C61.2, C62.2, MAINLINE_CURRENT.5, POWER_12V.P$1, POWER_12V2.P$1
