MissouriMRDT/ArmBoard_Hardware/(commit log)

2015-10-14 Added Tiva C design files
    [EK-TM4C1294XL REV D Public Bill Of Materials.xls, EK-TM4C1294XL REV D.brd, EK-TM4C1294XL REV D.sch]
2015-10-14 Stripped Tiva C design files of all non-shieldable components
    Basically just took the design files and deleted everything but the
    output pin layout
    [EK-TM4C1294XL REV D-shield.brd, EK-TM4C1294XL REV D-shield.sch]
2015-10-14 Started converting generic Tiva C shield into dev shield, Added dynamixel capabilities
    Added dynamixal uart buffer, 1x03 connectors, data led
    [tive-c-dev-shield.brd, tive-c-dev-shield.sch]
2015-12-20 i did pretty much the whole sch. sorry i suck at this committing thing...
    [arm-board.brd, arm-board.sch]
2015-12-20 swapped led_xb_tx package
    [arm-board.brd, arm-board.sch]
2015-12-20 played with placement a bit
    [arm-board.brd, arm-board.sch]
2015-12-23 finished most of the arm board, excl encoders
    waiting on clarification on timer ccp pins before connecting encoders
    [arm-board.brd, arm-board.sch]
2016-01-12 swapped mlx-3-pin for mlx-2x3-pin
    [arm-board.brd, arm-board.sch]
2016-01-14 changing switch fets, rearranging board
    [arm-board.brd, arm-board.sch]
2016-01-14 swap for all horiz conns, placement and routing
    [arm-board.brd, arm-board.sch]
2016-01-20 renamed some components
    [arm-board.brd, arm-board.sch]
2016-01-21 added high side fet drivers, rearranged
    [arm-board.brd, arm-board.sch]
2016-01-22 added horiz connectors
    [arm-board.brd, arm-board.sch]
2016-01-23 routing rev 1 arm board, started gripper boards
    rev 1 - bare minimum, no power control, no tristate buffer
    rev 2 - no power control, tristate buffer
    [arm-board-rev1.brd, arm-board-rev1.sch, arm-board-rev2.brd, arm-board-rev2.sch, gripper-board-rev1.brd, gripper-board-rev1.sch]
2016-01-23 finished routing, FINAL REV1 PENDING PEER REVIEW
    [arm-board-rev1.brd, arm-board-rev1.sch]
2016-01-23 added label/logo and 2 dio's to xbee
    [arm-board-rev1.brd, arm-board-rev1.sch]
2016-01-24 moved xbee in a little, reviewed by Drue on arm ; REV 1 FINAL of Gripper Board
    [arm-board-rev1.brd, arm-board-rev1.sch, gripper-board-rev1.brd, gripper-board-rev1.sch]
2016-01-24 added dims, gerbs
    [arm-board-rev1.brd, gripper-board-rev1.brd]
2016-01-30 moved around and organized in folders, added sdc2130 moco profile, added arm-board-rev1-bom
    [arm-board-rev1.brd, arm-board-rev1.sch, arm-board-rev2.brd, arm-board-rev2.sch, gripper-board-rev1.brd, gripper-board-rev1.sch]
2016-02-01 removed experimental bom generator code
2016-02-11 moved some stuff around
    [arm-board-rev2.brd, arm-board-rev2.sch]
2016-02-12 finished design (not incl current sense), needs placement/routing
    [arm-board-rev2.brd, arm-board-rev2.sch]
2016-02-15 routing sucks but its done...
    [arm-board-rev2.brd, arm-board-rev2.sch]
2016-02-15 added gerbers and stuff
    dims 4.9x2.2in
    [arm-board-rev2.brd, arm-board-rev2.sch]
2016-02-16 new gerbs
    [arm-board-rev2.brd]
2016-02-16 updated gerbs
    [arm-board-rev2.brd]
2016-02-16 updated gerbs. it finally worked this time
    [arm-board-rev2.brd]
2016-02-17 added bom
    [arm-board-rev2.csv]
2016-03-17 added calibrated profile
2016-03-21 copied current drill rev1 sch to branch
    [drill-rev-1.sch]
2016-03-21 removed acs current sensor, replaced vnh5180 with vnh5050
    [drill-rev-1.brd, drill-rev-1.sch]
2016-03-21 started placement/routing
    [drill-rev-1.brd, drill-rev-1.sch]
2016-03-21 finished routing/placement
    [drill-rev-1.brd, drill-rev-1.sch]
2016-03-21 generated gerbers for single board and for panelizatoin
2016-03-21 regen gerbers and saved panelized brd file
    [drill-rev-1.brd, drill-rev-1.sch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]
2016-03-21 regen gerbers
    [drill-rev-1.brd, drill-rev-1_p.brd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]
2016-03-26 added drill dxf and bom
    [drill-rev-1-bom.csv, drill-rev-1.dxf]
2016-03-26 fixed dxf
    [drill-rev-1.dxf]
2016-03-26 fixed dx
    [drill-rev-1.dxf]
2016-04-26 started gripper rev3
    [gripper-rev3.sch]
2016-04-26 finished sch, started placement/routing
    [gripper-rev3.brd, gripper-rev3.sch]
2016-04-27 Trying to just commit gripper-board rev3 files. Might be messing something up. Anyways, finished sch and started routing/placement.
    [EK-TM4C1294XL REV D-shield.brd, EK-TM4C1294XL REV D-shield.sch, EK-TM4C1294XL REV D.brd, EK-TM4C1294XL REV D.sch, arm-board-rev1-bom.csv, arm-board-rev1.brd, arm-board-rev1.sch, arm-board-rev2.brd]
2016-04-27 Revert "Trying to just commit gripper-board rev3 files. Might be messing something up. Anyways, finished sch and started routing/placement."
    This reverts commit f03b0275fc6722b45484372efe3efaf876efa4ac.
    [EK-TM4C1294XL REV D-shield.brd, EK-TM4C1294XL REV D-shield.sch, EK-TM4C1294XL REV D.brd, EK-TM4C1294XL REV D.sch, arm-board-rev1-bom.csv, arm-board-rev1.brd, arm-board-rev1.sch, arm-board-rev2.brd]
2016-04-27 finalized sch, brd; need to check DRC
    [gripper-rev3.brd, gripper-rev3.sch]
2016-04-27 added mounting holes
    [gripper-rev3.brd]
2016-04-27 passed drc
    [gripper-rev3.brd]
2016-04-27 gripper gerbs
    [gripper-rev3.brd]
2016-05-02 renamed buck converter voltage setting resistors to specify high tolerance, added bom csv
    [gripper-rev3.brd, gripper-rev3.csv, gripper-rev3.sch]
2016-05-05 made modifications for testing
    - moved pwm to PD6
    - moved INB to PB5
    - removed custom moisture sensor M3
    - added crystal oscillator to ATMEGA328p
    - added resistors to make moisture sensor M4 work
    NOTE: These changes were added post-production and were not actually
    incorporated in the REV3 board. Disregard board design, schematic
    changed for reference only.
    [drill-rev-1.brd, drill-rev-1.sch]
2016-05-05 removed MOIST_3 net from sch
    [drill-rev-1.brd, drill-rev-1.sch]
2016-05-06 started rev3, changed a lot of stuff, middle of placement/routing
    [arm-board-rev3.brd, arm-board-rev3.sch]
2016-05-07 working on rev3
    [arm-board-rev3.brd, arm-board-rev3.sch]
2016-05-09 finished first draft, gened gerbs
    [arm-board-rev3.brd, arm-board-rev3.sch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]
2016-05-10 regened gerbers, fixed Sierra Circuits's issues regarding clearance between drill holes and copper
    [arm-board-rev3.brd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]
2016-05-10 WARNING fixed potential issue of LTC2645 in upper left corner (U$9) not being connected to 5V - may need to fix on board when it arrives, ad
    [arm-board-rev3-bom.csv, arm-board-rev3.brd]
2016-05-10 didnt change anything, just noting i forgot to add a power indicator led on end effector 12V output
    [arm-board-rev3.sch]
2016-05-30 added gripper rev 2
    [gripper-rev-2a.brd, gripper-rev-2a.sch]
2017-01-13 Wiping for new year's start
    [EK-TM4C1294XL REV D Public Bill Of Materials.xls, EK-TM4C1294XL REV D-shield.brd, EK-TM4C1294XL REV D-shield.sch, EK-TM4C1294XL REV D.brd, EK-TM4C1294XL REV D.sch, tive-c-dev-shield.brd, tive-c-dev-shield.sch]
2017-01-13 Committing Rev 1.0 schematic
    [arm_board.sch]
2017-01-13 Correcting schematic issue, adding preliminary board.
    The previous power guarding method -- using the LT1910 to current sense
    and also turn off the power line at the same time -- wasn't going to
    work as its current sensing was way too small. Instead I've replaced
    that part of the process with an actual current sensor to let the
    microcontroller know when we've had an overcurrent condition.
    [arm_board.brd, arm_board.sch]
2017-01-14 Version 1.0-alpha ready for review
    [arm_board.brd, arm_board.sch]
2017-01-15 Correcting issues, adding powerout to gripper
    I changed the tags on the schm to use xref, I messed with the brd to get
    rid of erc errors, I redid the power lines going to and from the H
    bridges so now it has a total of .04 inches of trace width going to and
    from it, and I resized the board so that the sideways andersons would
    fit on it.
    Still need to put on mounting holes
    [arm_board.brd, arm_board.sch]
2017-01-15 corrected improperly ordered andersons, added docs
    [arm_board.brd]
2017-01-15 added mrdt logo
    [arm_board.brd, arm_board.sch]
2017-01-16 getting rid of unnecessary ground traces
    [arm_board.brd]
2017-01-16 adding a third mounting hole
    [arm_board.brd, arm_board.sch]
2017-01-16 adding circle via notation, adding top ground plane
    added top ground plane to try and make it easier on the gripper-output
    ground pin to disperse the ground plane
    [arm_board.brd]
2017-01-16 adding a bit more vias to assist top plane with connecting to bottom plane
    [arm_board.brd]
2017-01-20 adjusted power lines to GRIP to allow for better ground access
    [arm_board.brd]
2017-01-20 Replaced signal square vias with round vias
    [arm_board.brd]
2017-01-21 Downsized board, added 2 more layers
    Went for 4 layers in order to be able to halve the board size, was able
    to move the H bridge ic's and connectors much closer while preserving
    the ground plane thanks to moving signals to two separate planes.
    [arm_board.brd, arm_board.sch]
2017-01-22 Cleaned up signals, made room for tiva ethernet port
    [arm_board.brd]
2017-01-23 adjusted texts, docs, similar layers
    [arm_board.brd]
2017-01-25 Moved a bad line out of the way
    [arm_board.brd]
2017-01-25 text was in the wrong spot
    [arm_board.brd]
2017-01-26 A few trace changes
    Decreased the length of the 3.3V logic line, and got rid of a couple of
    leftover unnecessary traces I forgot to take out
    [arm_board.brd]
2017-01-26 U$5 Power OR switcher was missing an input wire
    [arm_board.brd, arm_board.sch]
2017-01-27 Created branch for endeffector board
    [arm_board.sch, gripper board.brd, gripper board.sch]
2017-01-28 Redid design. 3x6 inches, all conns on 2 sides, 2 layer
    [arm_board.brd, arm_board.sch]
2017-01-28 cleaned traces, removed top gnd, cut out ethernet
    Top ground was useless anyway
    [arm_board.brd]
2017-01-28 Resized text, other small edits
    [arm_board.brd]
2017-01-31 replacing xbee with max3232
    now wiring serial directly instead of wirelessly
    [arm_board.brd, arm_board.sch]
2017-01-31 Added pin documentation to the brd
    [arm_board.brd, arm_board.sch]
2017-01-31 tiny clearance mistake
    [arm_board.brd]
2017-01-31 changing text size
    [arm_board.brd]
2017-01-31 fixed bug, nfault pulled to ground instead of 3.3V
    I corrected it, pulling it to 3.3V instead and adjusting the brd
    [arm_board.brd, arm_board.sch]
2017-01-31 redid one motor trace for better ground plane
    New line looks a little weird, but it helps preserve the ground plane in
    the path between the gripper ground and the arm ground
    [arm_board.brd]
2017-01-31 Resized dual power line for better safety
    was .39, made it .42
    [arm_board.brd]
2017-01-31 cleaned up schm a bit
    [arm_board.brd, arm_board.sch]
2017-02-01 slightly expanded dual power plane's input to current sensor
    [arm_board.brd]
2017-02-01 changed text a bit
    [arm_board.brd]
2017-02-01 moved via away from poly, changed bottom trace to better ground top MC
    [arm_board.brd]
2017-02-01 cleaned unnecessary traces
    [arm_board.brd]
2017-02-02 Fixed Motor Numbering
    [arm_board.brd, arm_board.sch]
2017-02-02 Reattaching git head shenanigans
    [arm_board.brd, arm_board.sch]
2017-02-02 lowered board size, redid MC order, spaced out MC's and components
    [arm_board.brd]
2017-02-02 Changed pull up resistor layouts, moved text out of stop zones
    [arm_board.brd]
2017-02-02 Update ignore for .lck, changed text, couple traces
    [arm_board.brd]
2017-02-02 Rearranged encoders
    [arm_board.brd, arm_board.sch]
2017-02-02 taking care of erroneous drc errors
    [arm_board.brd]
2017-02-02 Spaced things apart farther after looking at a printed image
    [arm_board.brd, arm_board.sch]
2017-02-03 Moved drill hole away from encoder connector
    [arm_board.brd]
2017-02-03 end effector redesign
    [gripper board.brd, gripper board.sch]
2017-02-03 Restructured folder system
    [arm_board.brd, arm_board.sch]
2017-02-04 Moved transistor up a bit
    [arm_board.brd]
2017-02-04 added a power led
    [arm_board.brd, arm_board.sch]
2017-02-04 I proceeded to move that tiva power LED
    [arm_board.brd]
2017-02-04 changed text to vector font
    [arm_board.brd]
2017-02-04 components now use mrdt library
    [arm_board.brd, arm_board.sch]
2017-02-04 Replaced opamp with one that actually exists
    Turns out the one from sparkfun doesn't describe any model capable of
    being found on digikey. wtf
    [arm_board.brd, arm_board.sch]
2017-02-05 I put the led on backwards. :-1:
    [arm_board.brd, arm_board.sch]
2017-02-05 Rearranged text
    [arm_board.brd]
2017-02-07 Replaced 100uF 603 caps with 1210 caps
    [arm_board.brd, arm_board.sch]
2017-02-07 removing weird extra brd file
    [gripper board.brd]
2017-03-02 changed sizing for 8 oz/inch copper allowance
    [arm_board.brd]
2017-03-02 Changed sizing on two power caps, text editing
    [arm_board.brd]
2017-03-02 Changed opamp to proper size
    [arm_board.brd]
2017-03-02 Brought Schm in line with brd. Correct DRV8X issues
    The schm wasn't uploaded with the brd the last few uploads, so now it's
    back in line.
    Changed some of the pins on the motor drivers from ground to 3.3V; turns
    out those pins disable the chip if set to gnd or are left floating
    [arm_board.brd, arm_board.sch]
2017-03-02 Added new lin reg IC to power tiva
    [arm_board.brd, arm_board.sch]
2017-03-02 removed useless serial, added power header
    We can use the header to disable power going to the tiva if we want to
    run it off of usb while running the board
    [arm_board.brd, arm_board.sch]
2017-03-02 added another cap for the tiva's other Vin pin
    [arm_board.brd, arm_board.sch]
2017-03-02 added gripper components to schm
    [arm_board.brd, arm_board.sch]
2017-03-03 First attempt at making V2
    [arm_board.brd, arm_board.sch]
2017-03-03 Changing text size and font
    [arm_board.brd, arm_board.sch]
2017-03-03 adjusted opamp reference voltage
    Forgot to account for opamp zero value offset in my calculations
    [arm_board.brd, arm_board.sch]
2017-03-09 Minor signal/mounting hole tweaks to better ground return
    [arm_board.brd]
2017-03-09 Cleaned sch up a bit for readability
    [arm_board.sch]
2017-03-14 Fixed improper FBpin & gripper HB pin
    [arm_board.brd, arm_board.sch]
2017-03-14 added larger inductor
    [arm_board.brd, arm_board.sch]
2017-03-15 Updated title text
    [arm_board.brd]
2017-03-15 Added output for a 5v fan
    [arm_board.brd, arm_board.sch]
2017-03-16 labeled the tiva power enable headers
    [arm_board.brd]
2017-03-21 Minor spacing tweaks
    [arm_board.brd]
2017-03-22 added my sexy sig to my board
    [arm_board.brd]
2017-03-22 Forcing the space tweaking commit
    did this earlier but woulnd't show up on the desktop app for some
    reason, so I redownloaded the zip and recommited it
    [arm_board.brd]
2017-03-23 no idea what changed. GImme my sig back
    [arm_board.brd]
2017-03-23 Moved and changed descriptor text
    [arm_board.brd]
2017-03-23 Removed deprecated gripper board files
    V1 no longer in use
    [gripper board.brd, gripper board.sch]
2017-03-27 corrected the lack of gripmtr_pwm pin
    [arm_board.brd, arm_board.sch]
2017-03-30 Moved heart out of the way of trace
    [arm_board.brd]
2017-03-30 Removed unnecessary serial pins
    [arm_board.brd, arm_board.sch]
2017-03-30 Organized 1210 capacitors
    [arm_board.brd]
2017-03-30 Adjusted text for easier view/better org
    [arm_board.brd, arm_board.sch]
2017-04-01 Changed connector spacings, text updates
    [arm_board.brd]
2017-04-16 Added in level shifter for the servo pwm signal
    [arm_board.brd, arm_board.sch]
2017-04-16 Added: Lim switch IO, changed power caps
    [arm_board.brd, arm_board.sch]
2017-04-16 Added in limit switch 6
    [arm_board.brd, arm_board.sch]
2017-04-20 Changed Encoder 2 input pin to PD_2
    [arm_board.brd, arm_board.sch]
2017-04-20 Board right side's line wasn't straight. Fixed
    [arm_board.brd]
2017-04-21 Slight spacing changes
    [arm_board.brd]
2017-04-21 Added Isense resistors to h bridges 4 and 5
    This is to enable current chopping capability
    [arm_board.brd, arm_board.sch]
2017-04-22 Added Isense res to mots 4 and 5. Expanded main pwr trace
    [arm_board.brd]
2017-04-28 Routed GripHBridge COM pins to ground
    [arm_board.brd, arm_board.sch]
2017-04-28 Changed 8050 to 8010. 5V fan changed to 12V fan.
    [arm_board.brd, arm_board.sch]
2017-04-29 Added new regulator for the servo
    [arm_board.brd, arm_board.sch]
2017-04-29 Text editting
    [arm_board.brd]
2017-04-29 Swapped servo regulator input to draw from 12V line
    [arm_board.brd, arm_board.sch]
2017-04-29 Changed sense resistor size
    Miscalculated originally; it needs 2 watt rating
    [arm_board.brd, arm_board.sch]
2017-04-29 Spacing adjustment on one capacitor
    [arm_board.brd]
2017-04-29 Removed opamp and components
    [arm_board.brd, arm_board.sch]
2017-04-29 Rearranged HB power caps and limit switch connectors
    [arm_board.brd, arm_board.sch]
2017-04-29 Changed servo_ctl line tracing
    [arm_board.brd]
2017-05-02 Rearranged Limit swithes
    [arm_board.brd, arm_board.sch]
2017-05-02 Finished an unfinished trace
    [arm_board.brd]
2017-09-29 Preliminary Schematic for 2018 arm board
    Created the schematic for the 2018 arm board. No work has beedn done on
    the board diagram yet.
    [Arm_Board_2018.brd, Arm_Board_2018.sch]
2017-09-29 Removed last year's arm board
    [arm_board.brd, arm_board.sch]
2017-09-29 Switched wires to nets, corrected couple of naming errors
    [Arm_Board_2018.brd, Arm_Board_2018.sch]
2017-09-30 Fixed remaining SCH issues, warnings, and missing parts
    [Arm_Board_2018.brd, Arm_Board_2018.sch]
2017-09-30 Changed +3V3 to LOGIC_3.3V
    [Arm_Board_2018.brd, Arm_Board_2018.sch]
2017-09-30 Corrected error with resis div on H bridges
    [Arm_Board_2018.sch]
2017-09-30 Revert "Changed +3V3 to LOGIC_3.3V"
    This reverts commit afd64b7472180079d62c8d462dc00da2640ede11.
    [Arm_Board_2018.brd, Arm_Board_2018.sch]
2017-10-13 Attached most of the powerlines
    All major components put on the board. Most powerlines have been run.
    Started to route a logic bus.
    [Arm_Board_2018.brd, Arm_Board_2018.sch]
2017-10-29 Made schematic changes from CDR
    Still need to finish the board but the schematic was finished with the
    exception of some pin allocations
    [Arm_Board_2018.brd]
2017-11-04 Add all pins, finished Rev 1, Not board reviewed
    Added all the pins that were missing. Finished routing all logic lines.
    Made board slightly smaller.
    [Arm_Board_2018.brd, Arm_Board_2018.sch]
2017-11-04 Connected the 3V3 plane to Logic 3.3V input
    Fixed the fact that the tiva would not have any power without connecting
    to the logic line.
    [Arm_Board_2018.brd, Arm_Board_2018.sch]
2017-11-04 Added Labels
    Increased the size of motor 1 power and output by 18 mil but not enough
    room to do the same for motor 2.
    Named itmes appropriately and added labels where necessary.
    [Arm_Board_2018.brd, Arm_Board_2018.sch]
2017-11-04 changed colors for visability
    [Arm_Board_2018.brd, Arm_Board_2018.sch]
2017-11-04 polygon error
    [Arm_Board_2018.brd]
2017-11-11 Fixed the things brought up during board review.
    Changed logic line to 12V and added a 3.3V oki.
    Thickened power traces to 85mil(min to keep IC from frying on max
    current draw.)
    Removed AC coupling on the current sensors.
    Separated the Schematic better.
    [Arm_Board_2018.brd, Arm_Board_2018.sch]
2017-11-12 Made small changes for readability
    [Arm_Board_2018.brd, Arm_Board_2018.sch]
2017-11-16 Removed all blind vias
    Fixed DRC which allowed for creation of blind vias so they cannot be
    created anymore. Removed existing blind vias and fixed any resulting
    errors.
    [Arm_Board_2018.brd, Arm_Board_2018.sch]
2018-02-11 reworking for new H bridges
    [Arm_Board_2018.brd, Arm_Board_2018.sch]
2018-02-12 Further progress
    [Arm_Board_2018.brd, Arm_Board_2018.sch]
2018-02-12 all things routed
    [Arm_Board_2018.brd, Arm_Board_2018.sch]
2018-02-12 reworked on board text, added space for ethernet
    [Arm_Board_2018.brd]
2018-02-13 added more polygons
    [Arm_Board_2018.brd]
2018-02-13 Revert "added more polygons"
    This reverts commit 0127a168e7661bc7332a66d9e3b5fca905d482c1.
    [Arm_Board_2018.brd]
2018-02-13 somehow brd and schm got OOC, fixed by changing a random class
    [Arm_Board_2018.brd]
2018-02-13 Revert "Revert "added more polygons""
    This reverts commit 8383b08ee77d4a5092546d9016847e14d77b1181.
    [Arm_Board_2018.brd]
2018-02-13 Some minor touch ups
    [Arm_Board_2018.brd, Arm_Board_2018.sch]
2018-10-13 Added ArmBoardMC Project file
    Added ArmBoardMC Project file
    [ArmBoardMC_2019_Rev1.kicad_pcb, ArmBoardMC_2019_Rev1.sch]
2018-10-13 Added TIVA schematic
    [ArmBoardMC_2019_Rev1.sch]
2018-10-16 DriveBoardFirstDesign
    DriveBoard kicad files created and made same as the 2018 training drive board
    [Arm_Board_2018.brd, Arm_Board_2018.sch, DriveBoard_Hardware.kicad_pcb, DriveBoard_Hardware.sch]
2018-10-17 CreatedPatchPanel
    Created a empty kicad file for Patch Panel
    [PatchPanel.kicad_pcb, PatchPanel.sch]
2018-10-19 completed patchpanel, wait on driveboard
    completed all designs for patch panel, it's ready to go.
    Laser, solenoid, servos ports were added. Waiting for futher instruction on laser, and solenoid input format.
    [DriveBoard_Hardware.sch, PatchPanel.kicad_pcb, PatchPanel.sch]
2018-10-20 fixed driveboard, and add power filter on MotorController
    [ArmBoardMC_2019_Rev1.sch, DriveBoard_Hardware.sch]
2018-10-20 rearrange encorders
    [ArmBoardMC_2019_Rev1.sch]
2018-10-20 Added H-Bridge and Encoders
    Added H-Bridge main symbol, then also added ancoders with signal flags
    [ArmBoardMC_2019_Rev1.sch, Schematic Page 2.sch]
2018-10-20 Made changes
    [ArmBoardMC_2019_Rev1.sch]
2018-10-20 Added Connector and Max3232
    [ArmBoardMC_2019_Rev1.sch]
2018-10-20 Added Flags for Encoder Pins connections, and PWM pins
    [ArmBoardMC_2019_Rev1.sch]
2018-10-20 Added Limit Switches
    [ArmBoardMC_2019_Rev1.sch]
2018-10-20 Finished connecting connector pins to level shifter
    [ArmBoardMC_2019_Rev1.sch]
2018-10-21 Finished connecting pins, and Level Shifter
    We connected the rest of the pins on the H-Bridge's, Limit Switches, and finished the level shifter
    [ArmBoardMC_2019_Rev1.sch]
2018-10-21 Changed Andersons on MC from Log to Act
    [ArmBoardMC_2019_Rev1.sch]
2018-10-21 Changed positioning a bit
    [DriveBoard_Hardware.sch]
2018-10-21 Organized Schematic to fit on a printable page
    You're welcome Andrew.
    [ArmBoardMC_2019_Rev1.sch]
2018-10-21 Quick Backup incase something breaks
    [ArmBoardMC_2019_Rev1.sch]
2018-10-21 Annotated Schematic
    [ArmBoardMC_2019_Rev1.sch]
2018-10-21 Gave Capacitors and Resistors values
    [ArmBoardMC_2019_Rev1.sch]
2018-10-21 Added more values and assigned footprint libraries to schematic
    Hopefully it transfers over to your end
    [ArmBoardMC_2019_Rev1.sch]
2018-10-21 Fixed Tiva issue
    There was a copy of a section of it. Doesnt cause further problems.
    [ArmBoardMC_2019_Rev1.sch]
2018-10-21 Placed Footprints onto PCB schematic Design
    [ArmBoardMC_2019_Rev1.kicad_pcb, ArmBoardMC_2019_Rev1.sch]
2018-10-21 Created and started workign on high level placement
    [ArmBoardMC_2019_Rev1.kicad_pcb, ArmBoardMC_2019_Rev1.sch]
2018-10-21 Finished the temporary high level placement
    Going to be made more efficient in the future
    [ArmBoardMC_2019_Rev1.kicad_pcb]
2018-10-21 Started redoing high level placement
    [ArmBoardMC_2019_Rev1.kicad_pcb]
2018-10-22 push kicad files
2018-10-24 Updated high level placement
    Made decent progress but still a lot to do
    [ArmBoardMC_2019_Rev1.kicad_pcb, ArmBoardMC_2019_Rev1.sch]
2018-10-24 finish PDR requirement check list
    [DriveBoard_Hardware.sch]
2018-10-24 Finished high level placement and adjusted schematic
    High level placement for PDR is finished. I had to change up the schematic a bit in order for it to work
    [ArmBoardMC_2019_Rev1.kicad_pcb, ArmBoardMC_2019_Rev1.sch]
2018-10-24 Added Pin and Connections .txt files and added the connections to the connections file
2018-10-24 Added Tiva Pinlayout to Pin Layout.txt file and fixed one mistate on a tiva flag
    Still need to add type of pin being used (I.E Analog, Digitical, etc.)
    [ArmBoardMC_2019_Rev1.sch]
2018-10-24 Added pin type to pin layout
2018-10-26 Made changes to schematics and boards
    Approved for PDR by Andrew
    [ArmBoardMC_2019_Rev1.sch, DriveBoard_Hardware.sch]
2018-10-26 Updated PCB
    [ArmBoardMC_2019_Rev1.kicad_pcb]
2018-10-26 Fixed some changes on the PCB that were accidentally deleted
2018-10-26 Made some changes to PCB
    [ArmBoardMC_2019_Rev1.kicad_pcb]
2018-10-26 added another molex2 on patch panel
    [PatchPanel.kicad_pcb, PatchPanel.sch]
2018-10-26 Made a few more slight changes to the PCBS
    [ArmBoardMC_2019_Rev1.kicad_pcb, DriveBoard_Hardware.kicad_pcb]
2018-11-03 Started wiring armboard
    [ArmBoardMC_2019_Rev1.kicad_pcb]
2018-11-03 Moved Pins around to allow for more convenient routing
    [ArmBoardMC_2019_Rev1.sch]
2018-11-03 Generated new netlist
    [ArmBoardMC_2019_Rev1.kicad_pcb]
2018-11-03 Moved more pins
    [ArmBoardMC_2019_Rev1.sch]
2018-11-03 Added 2nd set of TX and RX signal
    Added 2nd set for a Bi-Directional Signal
    [ArmBoardMC_2019_Rev1.sch]
2018-11-03 Worked on wiring
    [ArmBoardMC_2019_Rev1.kicad_pcb, ArmBoardMC_2019_Rev1.sch]
2018-11-11 Worked on wiring some more
    [ArmBoardMC_2019_Rev1.kicad_pcb]
2018-11-11 Continued wiring
    [ArmBoardMC_2019_Rev1.kicad_pcb]
2018-11-11 Finished wiring
    [ArmBoardMC_2019_Rev1.kicad_pcb]
2018-11-13 Schematic layout
    [DriveBoard_Hardware.kicad_pcb, DriveBoard_Hardware.sch]
2018-11-13 fix a little
    [DriveBoard_Hardware.kicad_pcb, DriveBoard_Hardware.sch]
2018-11-15 finshed wiring
    [DriveBoard_Hardware.kicad_pcb]
2018-11-24 Added proper GND power flags
    [ArmBoardMC_2019_Rev1.sch]
2018-11-24 Finished power flags, began adding leds
    [ArmBoardMC_2019_Rev1.kicad_pcb, ArmBoardMC_2019_Rev1.sch]
2018-11-25 Made some changes to board wiring
    changed from 9.84 mil wire to 15.00 mil wire and changed some of the routing to be more efficient and clean
    [ArmBoardMC_2019_Rev1.kicad_pcb, ArmBoardMC_2019_Rev1.sch]
2018-11-25 Revert "Made some changes to board wiring"
    This reverts commit da9662cbcf42a8357acbb6e05bfca608f18f2124.
    [ArmBoardMC_2019_Rev1.kicad_pcb, ArmBoardMC_2019_Rev1.sch]
2018-11-25 Fixed a few wiring mistakes
    [ArmBoardMC_2019_Rev1.kicad_pcb]
2018-11-26 finished board design
    [DriveBoard_Hardware.kicad_pcb, DriveBoard_Hardware.sch]
2018-11-26 Added some LEDs
    Waiting for confirmation on how I should implement the LEDs, revert if needed.
    [ArmBoardMC_2019_Rev1.sch]
2018-11-26 Added edgecuts
    [ArmBoardMC_2019_Rev1.kicad_pcb]
2018-11-26 Made some small changes on armboard wiring
    [ArmBoardMC_2019_Rev1.kicad_pcb]
2018-11-27 files' name change
    [ArmDriveBoard_Hardware.kicad_pcb, ArmDriveBoard_Hardware.sch, DriveBoard_Hardware.sch, PatchPanel.kicad_pcb, PatchPanel.sch]
2018-11-28 Changed some orginization
    Renamed ArmDriveBoard to ArmDriveboard_Hardware
    Renamed ArmBoardMC to ArmMotorController_Hardware
    Moved our txt files into documentation folder
    [ArmBoardMC_2019_Rev1.kicad_pcb, ArmBoardMC_2019_Rev1.sch, ArmDriveBoard_Hardware.kicad_pcb, ArmDriveBoard_Hardware.sch, Schematic Page 2.sch]
2018-11-28 Began properly orginizing schematic
    [ArmBoardMC_2019_Rev1.sch]
2018-11-28 Added AP1509 3.3v
    [ArmBoardMC_2019_Rev1.sch]
2018-11-28 Put components into sections, renamed a few pins, changed library for Encoder and Limit Switch
    [ArmBoardMC_2019_Rev1.sch]
2018-11-28 Added Indicator Section and updated Notes to show what I have done so far
    [ArmBoardMC_2019_Rev1.sch]
2018-11-28 Forgot to save, same as last
    [ArmBoardMC_2019_Rev1.sch]
2018-11-28 Renamed files to be more consistent
    [ArmMotorController_Hardware.kicad_pcb, ArmMotorController_Hardware.sch, ArmMotorController_Hardware.xml]
2018-11-28 Changed ENC and PWM pin conflicts we had and put required text next to them
    [ArmMotorController_Hardware.sch]
2018-11-28 Moved more pins around to hopefully have more efficient layout
    [ArmMotorController_Hardware.sch]
2018-11-28 Changed all resistor values to 500
    [ArmMotorController_Hardware.sch]
2018-11-28 Finished all LEDS except LS(low priority)
    This push is pre-annotation
    [ArmMotorController_Hardware.sch]
2018-11-28 Post Annotation
    [ArmMotorController_Hardware.sch]
2018-11-28 Made references consistent post annotation
    [ArmMotorController_Hardware.sch]
2018-11-28 Updated Pin Layout and renamed MOTOR#_PWM to Mo#_PWM
    [_saved_ArmMotorController_Hardware.sch]
2018-11-28 repeat of last
    [ArmMotorController_Hardware.sch, _saved_ArmMotorController_Hardware.sch]
2018-11-29 Ran DRC with no errors, but weird warnings.
    [ArmMotorController_Hardware.sch]
2018-11-29 Assigned new footprints, don't know if theyre correct yet so don't make a new netlist.
    [ArmMotorController_Hardware.sch]
2018-11-29 few minor c hanges
    [ArmMotorController_Hardware.sch]
2018-11-29 Met with Jacob and fixed a couple of things
    Replaced Andersons in the "indicator" section with Global Labels, made H-Bridges VCC = 12v
    [ArmMotorController_Hardware.sch]
2018-11-29 Re-annotated to keep annotationss looking nice
    [ArmMotorController_Hardware.sch]
2018-11-29 Assigned footprints and generated netlist
    [ArmMotorController_Hardware.sch]
2018-11-29 Fixed a footprint issue and made a new netlist
    [ArmMotorController_Hardware.sch]
2018-12-02 Updated PCB netlist and started rewiring
    [ArmMotorController_Hardware.kicad_pcb]
2018-12-03 Added "Interface" section with the buttons attached to the tiva
    [ArmMotorController_Hardware.sch]
2018-12-03 Annotated interface components and added their footprints
    [ArmMotorController_Hardware.sch]
2018-12-04 began high-level placement of pcb and added new footprints to board
    [ArmMotorController_Hardware.kicad_pcb, ArmMotorController_Hardware.sch]
2018-12-05 Continued wiring, H-bridges mostly done
    [ArmMotorController_Hardware.kicad_pcb, ArmMotorController_Hardware.sch]
2018-12-05 More wiring done
    [ArmMotorController_Hardware.sch]
2018-12-05 idk it says I cahnged something, maybe I didn't save on last one?
    [ArmMotorController_Hardware.sch]
2018-12-05 Changed the 5v AP1509's GND and V+Log to Flags to remove the extra anderson was being used on
    Still waiting on Jacobs approval, revert if needed
    [ArmMotorController_Hardware.sch]
2018-12-05 AP1509 should be wired correctly
    [ArmMotorController_Hardware.kicad_pcb, ArmMotorController_Hardware.sch, _saved_ArmMotorController_Hardware.sch]
2018-12-05 Fixed schematic issue
    [ArmMotorController_Hardware.sch, _saved_ArmMotorController_Hardware.sch]
2018-12-05 generated and read new netlist for schematic change
    [ArmMotorController_Hardware.kicad_pcb, ArmMotorController_Hardware.sch]
2018-12-05 Changed indicator pins around so they route better
    [ArmMotorController_Hardware.kicad_pcb, ArmMotorController_Hardware.sch]
2018-12-05 wiring cont.
    [ArmMotorController_Hardware.kicad_pcb, ArmMotorController_Hardware.sch]
2018-12-05 Continued wiring, moved LS pins to make wiring cleaner , generated netlist
    [ArmMotorController_Hardware.kicad_pcb, ArmMotorController_Hardware.sch]
2018-12-05 LS are wired to TIVA
    [ArmMotorController_Hardware.kicad_pcb]
2018-12-05 New route for LS
    [ArmMotorController_Hardware.kicad_pcb]
2018-12-05 Enc wired to tiva
    [ArmMotorController_Hardware.kicad_pcb]
2018-12-05 Wired Motor 1&2 to the tiva
    [ArmMotorController_Hardware.kicad_pcb, ArmMotorController_Hardware.sch]
2018-12-05 finish board design
    [ArmDriveBoard_Hardware.kicad_pcb, ArmDriveBoard_Hardware.sch]
2018-12-05 More wiring
    [ArmMotorController_Hardware.kicad_pcb, _saved_ArmMotorController_Hardware.sch]
2018-12-05 All wires connected except for LEDs
    [ArmMotorController_Hardware.kicad_pcb, _saved_ArmMotorController_Hardware.sch]
2018-12-05 powered 3232
    [ArmMotorController_Hardware.kicad_pcb, ArmMotorController_Hardware.sch]
2018-12-05 Finished wiring, LEDs should be done
    [ArmMotorController_Hardware.kicad_pcb]
2018-12-05 Added text above the VNH's
    [ArmMotorController_Hardware.kicad_pcb]
2018-12-06 added logo and signature at the bottom
    [ArmMotorController_Hardware.kicad_pcb]
2018-12-07 Added circuit requested by Andrew, generated netlist, read netlist
    [ArmMotorController_Hardware.kicad_pcb, ArmMotorController_Hardware.sch]
2018-12-07 nothing worth noting
    [ArmMotorController_Hardware.kicad_pcb]
2018-12-07 Began moving the new schematic change into place and added a junction to the schematic
    [ArmMotorController_Hardware.kicad_pcb, ArmMotorController_Hardware.sch]
2018-12-08 Finished attaching the new circuit and made sure everything was connected
    [ArmMotorController_Hardware.kicad_pcb]
2018-12-08 Moved I_Sense indicators to their own section, fixed a few other small things
    [ArmMotorController_Hardware.sch]
2018-12-08 Revert "Moved I_Sense indicators to their own section, fixed a few other small things"
    This reverts commit 230d23307c9f7ab4a9b159dcebd73e9f64d3cae1.
    [ArmMotorController_Hardware.sch]
2018-12-08 Revert "Revert "Moved I_Sense indicators to their own section, fixed a few other small things""
    This reverts commit 71a20b82b12dedea9c44dee98f2892ec0f8925a9.
    [ArmMotorController_Hardware.sch]
2018-12-08 FInished the schematic changes and attched them on the PCB
    [ArmMotorController_Hardware.kicad_pcb, ArmMotorController_Hardware.sch]
2018-12-08 Rearranged schematic Layout
    [ArmMotorController_Hardware.sch]
2018-12-08 Annotated and gen new net list
    [ArmMotorController_Hardware.sch]
2018-12-08 Generated the Netlist a few more times and read them
    [ArmMotorController_Hardware.kicad_pcb, ArmMotorController_Hardware.sch]
2018-12-08 Fixed a few problems on VNH 1&2 + via stiching
    [ArmMotorController_Hardware.kicad_pcb]
2018-12-08 Moved the 3.3v power line for the VNH under it and fixed some gnd connections
    [ArmMotorController_Hardware.kicad_pcb]
2018-12-09 Fixed a few things on layout and added labels
    [ArmMotorController_Hardware.kicad_pcb]
2018-12-09 Generated new netlist for the new inductor footprint
    That thing is a beast wth
    [ArmMotorController_Hardware.kicad_pcb, ArmMotorController_Hardware.sch]
2018-12-09 Changed layout of 1509 for new Inductor
    [ArmMotorController_Hardware.kicad_pcb]
2018-12-09 idk it says I changed something, same as before.
    [ArmMotorController_Hardware.kicad_pcb]
2018-12-09 Changed reference placements
    [ArmMotorController_Hardware.kicad_pcb]
2018-12-10 worked on everything
    [ArmDriveBoard_Hardware.kicad_pcb, ArmDriveBoard_Hardware.sch, _saved_ArmDriveBoard_Hardware.sch]
2018-12-10 I hope it works this time
    [ArmDriveBoard_Hardware.kicad_pcb]
2018-12-13 hope this will work 2.0
    [ArmDriveBoard_Hardware.kicad_pcb, _saved_ArmDriveBoard_Hardware.sch]
2018-12-14 Working on BOM
    [ArmMotorController_Hardware.csv, ArmMotorController_Hardware.sch, ArmMotorController_Hardware.xml, ArmMotorController_Hardware_BOM.csv]
2018-12-14 add silkscreen
    [ArmDriveBoard_Hardware.kicad_pcb, _saved_ArmDriveBoard_Hardware.sch]
2018-12-14 continued bom
    [ArmMotorController_Hardware_BOM.csv]
2018-12-14 Finished BOM ??
    [ArmMotorController_Hardware_BOM.csv]
2018-12-14 Did some stuff probably
    [ArmMotorController_Hardware.kicad_pcb]
2018-12-14 4th review
    [ArmDriveBoard_Hardware.kicad_pcb, ArmDriveBoard_Hardware.sch]
2018-12-14 changes with lipina
    [ArmMotorController_Hardware.kicad_pcb]
2018-12-15 Revert "4th review"
    This reverts commit 72948813f317e6daba9957eff83db5ba944c7337.
    [ArmDriveBoard_Hardware.kicad_pcb, ArmDriveBoard_Hardware.sch]
2018-12-15 fix problems on 4th review
    [ArmDriveBoard_Hardware.kicad_pcb, ArmDriveBoard_Hardware.sch]
2018-12-15 Ajusted Silkscreen
    [ArmDriveBoard_Hardware.kicad_pcb]
2018-12-15 this will work!
    [ArmDriveBoard_Hardware.kicad_pcb]
2018-12-18 last push
    [ArmDriveBoard_Hardware.kicad_pcb]
2018-12-18 Added OKI back to the schematic
    [ArmMotorController_Hardware.sch]
2018-12-18 Annotated and generated new netlist
    [ArmMotorController_Hardware.sch]
2018-12-18 Read new netlist
    [ArmMotorController_Hardware.sch]
2018-12-18 Changed LED pins and generated new netlist.
    [ArmMotorController_Hardware.sch]
2018-12-18 Added some silkscreens and replaced OKI
    [ArmMotorController_Hardware.kicad_pcb]
2018-12-18 Added MRDT silkscreens
    [ArmMotorController_Hardware.kicad_pcb]
2018-12-18 Updated Pin layout
2018-12-19 Changed a few things
    [ArmMotorController_Hardware.kicad_pcb, ArmMotorController_Hardware.sch]
2018-12-19 More changes
    [ArmMotorController_Hardware.kicad_pcb, _saved_ArmMotorController_Hardware.sch]
2018-12-19 Updated pcb layout and BOM
    [ArmMotorController_Hardware_BOM.csv, _saved_ArmMotorController_Hardware.sch]
2018-12-19 Updated BOM again
    [ArmMotorController_Hardware_BOM.csv]
2018-12-19 GENERATED GERBS
    [ArmMotorController_Hardware-B.Cu.gbr, ArmMotorController_Hardware-B.Mask.gbr, ArmMotorController_Hardware-B.Paste.gbr, ArmMotorController_Hardware-B.SilkS.gbr, ArmMotorController_Hardware-Edge.Cuts.gbr, ArmMotorController_Hardware-F.Cu.gbr, ArmMotorController_Hardware-F.Mask.gbr, ArmMotorController_Hardware-F.Paste.gbr]
2018-12-19 A few changes i guess
    [ArmMotorController_Hardware.kicad_pcb, ArmMotorController_Hardware.sch, ArmMotorController_Hardware_BOM.csv, _saved_ArmMotorController_Hardware.sch]
2018-12-21 created step files
    [0.1.stp, ArmDriveBoard_Hardware-B.Cu.dxf, ArmDriveBoard_Hardware-B.Mask.dxf, ArmDriveBoard_Hardware-B.Paste.dxf, ArmDriveBoard_Hardware-B.SilkS.dxf, ArmDriveBoard_Hardware-Edge.Cuts.dxf, ArmDriveBoard_Hardware-F.Cu.dxf, ArmDriveBoard_Hardware-F.Mask.dxf]
2019-02-02 Updated to 2019 R2
    [ArmDriveBoard_Hardware.kicad_pcb, ArmMotorController_Hardware.kicad_pcb]
2019-02-24 Changed diode on schematic and gen new netlist
    [ArmMotorController_Hardware.sch]
2019-02-24 Moved H-Bridges down to reduce size by ~.87in
    [ArmMotorController_Hardware.kicad_pcb]
2019-02-24 ran DRC i think
    [ArmMotorController_Hardware.kicad_pcb]
2019-02-25 Added VNH changes to VNH 1
    [ArmMotorController_Hardware.sch]
2019-02-26 not much changed
    [ArmMotorController_Hardware.sch]
2019-02-26 added n.c to Cs_Dis
    [ArmMotorController_Hardware.sch]
2019-02-26 Completed required changes on VNH
    [ArmMotorController_Hardware.sch]
2019-02-26 Made changes to schematic
    changes based on notes in documentation
    [ArmMotorController_Hardware.sch]
2019-02-26 read netlist
    [ArmMotorController_Hardware.kicad_pcb]
2019-02-27 Save before annotation
    [ArmMotorController_Hardware.sch]
2019-02-27 Revert "Save before annotation"
    This reverts commit 96b77a3618298a2b4a54ba2dc320ac5e0febed40.
    [ArmMotorController_Hardware.sch]
2019-02-27 Lets try this again (pre netlist)
    [ArmMotorController_Hardware.sch]
2019-02-27 Maybe now
    [ArmMotorController_Hardware.sch]
2019-02-27 Added new LEDs to VNH
    [ArmMotorController_Hardware.kicad_pcb, ArmMotorController_Hardware.sch]
2019-02-27 Continued placing new components
    [ArmMotorController_Hardware.kicad_pcb, ArmMotorController_Hardware.sch]
2019-02-27 Added missing resistors to schematic and layout
    [ArmMotorController_Hardware.kicad_pcb, ArmMotorController_Hardware.sch]
2019-02-27 More component placement
    [ArmMotorController_Hardware.kicad_pcb]
2019-02-27 some wiring
2019-02-27 change branch
    [ArmDriveBoard_Hardware.kicad_pcb, ArmDriveBoard_Hardware.sch]
2019-02-27 Revert "change branch"
    This reverts commit 3f8c422171aad8bdd6037f6269eb9654437f20e9.
    [ArmDriveBoard_Hardware.kicad_pcb, ArmDriveBoard_Hardware.sch]
2019-02-27 Cleaned layout and traces
    [ArmDriveBoard_Hardware.kicad_pcb, ArmDriveBoard_Hardware.sch]
2019-02-27 More placement and wiring
    [ArmMotorController_Hardware.kicad_pcb]
2019-02-27 More more component placement and wiring
    [ArmMotorController_Hardware.kicad_pcb]
2019-02-27 Pin swap
    Swapped M3_Pwm and M4_Pwm
    Changed the pin layout . txt to match
    [ArmMotorController_Hardware.sch]
2019-02-27 Made new netlist and read for the pin swap
    [ArmMotorController_Hardware.kicad_pcb]
2019-02-28 More more more wiring and component placement
    [ArmMotorController_Hardware.kicad_pcb]
2019-02-28 Everything connected
    [ArmMotorController_Hardware.kicad_pcb]
2019-02-28 Few minor layout edits
    [ArmMotorController_Hardware.kicad_pcb]
2019-02-28 Added some via stiching
    [ArmMotorController_Hardware.kicad_pcb]
2019-02-28 Same as last but apparently didnt save
    [ArmMotorController_Hardware.kicad_pcb]
2019-02-28 added some via
    [ArmDriveBoard_Hardware.kicad_pcb]
2019-02-28 Minor layout changes
    [ArmMotorController_Hardware.kicad_pcb]
2019-03-01 Rev 2 board review
    [ArmMotorController_Hardware.sch]
2019-03-01 Added more LEDs and e-caps
    Current running total of 30 leds
    [ArmMotorController_Hardware.sch]
2019-03-01 Swapped LS flags (Pre annotate and Netlist)
    [ArmMotorController_Hardware.sch]
2019-03-01 Changed some schematic inconsistencies and made netlist
    [ArmMotorController_Hardware.sch]
2019-03-02 More layout edits
    [ArmMotorController_Hardware.kicad_pcb]
2019-03-02 Fixed schematic error and read new net
    [ArmMotorController_Hardware.kicad_pcb, ArmMotorController_Hardware.sch]
2019-03-02 Made layout changes and deleted 1 e-cap
    [ArmMotorController_Hardware.kicad_pcb, ArmMotorController_Hardware.sch]
2019-03-02 Finished LEDS on LS and TX/RX
    [ArmMotorController_Hardware.kicad_pcb]
2019-03-02 Everything is connected
    [ArmMotorController_Hardware.kicad_pcb]
2019-03-02 layout mostly done
    [ArmMotorController_Hardware.kicad_pcb]
2019-03-02 Updated schematic
    Moved Zener diode to VNH and adjust schematic layout
    [ArmMotorController_Hardware.sch]
2019-03-02 Updated Pin layout txt file and notes
2019-03-02 Updated BOM
    [ArmMotorController_Hardware.xml, ArmMotorController_HardwareRev2.csv, ArmMotorController_Rev2_Hardware_BOM.csv, _saved_ArmMotorController_Hardware.sch]
2019-03-02 Finished updating bom and added some silkscreens
    [ArmMotorController_Hardware.kicad_pcb, ArmMotorController_Rev2_Hardware_BOM.csv]
2019-03-02 schematic changes
    [ArmMotorController_Hardware.sch, _saved_ArmMotorController_Hardware.sch]
2019-03-03 finished updating BOM
    [ArmMotorController_Rev2_Hardware_BOM.csv]
2019-03-03 last try
    [ArmDriveBoard_Hardware.kicad_pcb, ArmDriveBoard_Hardware.sch]
2019-03-03 Small sch adjustments
    [ArmMotorController_Hardware.sch]
2019-03-03 Updated schematic and added davids sig
    [ArmMotorController_Hardware.kicad_pcb, ArmMotorController_Hardware.sch]
2019-03-03 Created Gerbs
    [ArmDriveBoard_Hardware-B.Cu.gbr, ArmDriveBoard_Hardware-B.Mask.gbr, ArmDriveBoard_Hardware-B.Paste.gbr, ArmDriveBoard_Hardware-B.SilkS.gbr, ArmDriveBoard_Hardware-Edge.Cuts.gbr, ArmDriveBoard_Hardware-F.Cu.gbr, ArmDriveBoard_Hardware-F.Mask.gbr, ArmDriveBoard_Hardware-F.Paste.gbr]
2019-03-03 CHanged VNH led config
    [ArmMotorController_Hardware.kicad_pcb, ArmMotorController_Hardware.sch]
2019-03-03 Layout changes
    [ArmMotorController_Hardware.kicad_pcb, ArmMotorController_Hardware.sch]
2019-03-03 More layout changes
    [ArmMotorController_Hardware.kicad_pcb]
2019-03-04 Layout changes and gen gerbs and drill
    [ArmMotorController_Hardware-B.Cu.dxf, ArmMotorController_Hardware-B.Mask.dxf, ArmMotorController_Hardware-B.Paste.dxf, ArmMotorController_Hardware-B.SilkS.dxf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]
2019-03-04 fixed tiva footprint
    [ArmMotorController_Hardware-B.Cu.gbr, ArmMotorController_Hardware-B.Mask.gbr, ArmMotorController_Hardware-B.Paste.gbr, ArmMotorController_Hardware-B.SilkS.gbr, ArmMotorController_Hardware-Edge.Cuts.gbr, ArmMotorController_Hardware-F.Cu.gbr, ArmMotorController_Hardware-F.Mask.gbr, ArmMotorController_Hardware-F.Paste.gbr]
2019-03-05 Updated some footprints with 3d models
    [ArmMotorController_Hardware.kicad_pcb]
2019-04-06 Actually updated pin layout
    Sorry
2019-04-16 fix for Rev 3 driveboard
    [ArmDriveBoard_Hardware.kicad_pcb, _saved_ArmDriveBoard_Hardware.sch]
2019-04-16 fixed schematic
    [ArmDriveBoard_Hardware.sch, _saved_ArmDriveBoard_Hardware.sch]
2019-04-17 created getbs and step
    [ArmDriveBoard_Hardware-B.Cu.gbr, ArmDriveBoard_Hardware-B.Mask.gbr, ArmDriveBoard_Hardware-B.Paste.gbr, ArmDriveBoard_Hardware-B.SilkS.gbr, ArmDriveBoard_Hardware-Edge.Cuts.gbr, ArmDriveBoard_Hardware-F.Cu.gbr, ArmDriveBoard_Hardware-F.Mask.gbr, ArmDriveBoard_Hardware-F.Paste.gbr]
2019-05-04 made rev 2
    [ArmDriveBoard_Hardware-B.Cu.gbr, ArmDriveBoard_Hardware-B.Mask.gbr, ArmDriveBoard_Hardware-B.Paste.gbr, ArmDriveBoard_Hardware-B.SilkS.gbr, ArmDriveBoard_Hardware-Edge.Cuts.gbr, ArmDriveBoard_Hardware-F.Cu.gbr, ArmDriveBoard_Hardware-F.Mask.gbr, ArmDriveBoard_Hardware-F.Paste.gbr]
2019-09-30 Started schematic
    [ArmDriveBoard_Hardware.sch, _saved_ArmDriveBoard_Hardware.sch]
2019-09-30 Continued schematic
    Added more indicators, took off some limit switches
    [ArmDriveBoard_Hardware.sch, _saved_ArmMotorController_Hardware.sch]
2019-10-01 Continued Schematic 2: Electric Boogaloo
    Added 2 more encoders, got rid of manual controls per Dahlman's request, removed 2 H-bridges, removed 2 limit switches, and re-arranged schematic.
    [ArmMotorController_Hardware.sch, _saved_ArmMotorController_Hardware.sch]
2019-10-08 KeytonSucksContinuedSchematic3
    Power stuff, Tiva, solenoid yeet yeet
    [ArmMotorController_Hardware.sch]
2019-10-11 Finished Schematic
    [ArmMotorController_Hardware.sch]
2019-10-11 Fixed Schematic Annotations
    [ArmMotorController_Hardware.sch]
2019-10-11 Started Board Placement
    [ArmMotorController_Hardware.kicad_pcb, ArmMotorController_Hardware.sch]
2019-10-12 brian bad
    [ArmMotorController_Hardware.kicad_pcb, ArmMotorController_Hardware.sch]
2019-10-12 Dan is fucking dumb. Like really dumb.
    Fixed schematic footprints and set preliminary layout of the PCB.
    [ArmMotorController_Hardware.kicad_pcb, ArmMotorController_Hardware.sch]
2019-10-12 PDR PCB layout finished
    [ArmMotorController_Hardware.kicad_pcb, ArmMotorController_Hardware.sch]
2019-11-17 Brian Owes me $5
    Changed schematic to fix problems, did traces
    [ArmMotorController_Hardware.kicad_pcb]
2019-11-18 HEY LOOK AT ME COMMITTING TO GITHUB
    Made Schematic look pretty
    [ArmMotorController_Hardware.kicad_pcb, ArmMotorController_Hardware.sch]
2019-11-18 Changes to traces and cleanup
    [ArmMotorController_Hardware.kicad_pcb, ArmMotorController_Hardware.sch]
2019-11-18 Finishing touches
    Brian bout to owe me $10
    [ArmMotorController_Hardware.kicad_pcb, ArmMotorController_Hardware.sch]
2019-11-19 added new mosfet, kicked ass and chewed bubblegum
2019-11-19 This is done, so if I do something stupid come back here
    [0.1.stp, ArmDriveBoard_Hardware-B.Cu.dxf, ArmDriveBoard_Hardware-B.Mask.dxf, ArmDriveBoard_Hardware-B.Paste.dxf, ArmDriveBoard_Hardware-B.SilkS.dxf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]
2019-11-20 Done with vanity stuff minus my custom silkscreens
    [ArmMotorController_Hardware.sch]
2019-11-20 Real push
    [ArmMotorController_Hardware.kicad_pcb, ArmMotorController_Hardware.sch]
2019-11-21 Added Silks, 100% done
    [ArmMotorController_Hardware.kicad_pcb]
2019-11-21 eat a bagel
    [ArmMotorController_Hardware.kicad_pcb]
2019-12-05 Frick me, my B
    [ArmMotorController_Hardware-B.Cu.dxf, ArmMotorController_Hardware-B.Mask.dxf, ArmMotorController_Hardware-B.Paste.dxf, ArmMotorController_Hardware-B.SilkS.dxf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]
2019-12-06 Reducing Electrical Leads bitching potential
    [ArmBoard_Hardware.csv, ArmBoard_Hardware.kicad_pcb, ArmBoard_Hardware.sch, BOM Template.xlsx]
2019-12-06 If anyone touches this I will kill them, and then myself
    [ArmBoard_Bom.xlsx, ArmBoard_Hardware.csv, ArmBoard_Hardware.kicad_pcb, ArmBoard_Hardware.sch, ArmMotorController_Hardware-B.Cu.dxf, ArmMotorController_Hardware-B.Mask.dxf, ArmMotorController_Hardware-B.Paste.dxf, ArmMotorController_Hardware-B.SilkS.dxf]
2019-12-07 Hurt me daddy
    [ArmBoard_Hardware.kicad_pcb, ArmBoard_Hardware.sch]
2019-12-07 Suck my toes
    [ArmBoard_Bom.xlsx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]
2019-12-07 (Just redid some traces for prettyiness)
    [ArmBoard_Hardware-B_Cu.gbr, ArmBoard_Hardware-B_Mask.gbr, ArmBoard_Hardware-B_Paste.gbr, ArmBoard_Hardware-B_SilkS.gbr, ArmBoard_Hardware-Edge_Cuts.gbr, ArmBoard_Hardware-F_Cu.gbr, ArmBoard_Hardware-F_Mask.gbr, ArmBoard_Hardware-F_Paste.gbr]
2020-02-06 3 up, three down, suck my toes
    [ArmBoard_Hardware.kicad_pcb, ArmBoard_Hardware.sch]
2020-02-07 This board is a basterdization of what it once was
    [ArmBoard_Hardware.kicad_pcb, ArmBoard_Hardware.sch]
2020-08-24 Renaming things for documentation
    [ArmBoardBom.xlsx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]
2021-10-01 Init Commit
    Removed old files. Added new project, reference docs,
    [ArmBoard_Hardware-B_Cu.gbr, ArmBoard_Hardware-B_Mask.gbr, ArmBoard_Hardware-B_Paste.gbr, ArmBoard_Hardware-B_SilkS.gbr, ArmBoard_Hardware-Edge_Cuts.gbr, ArmBoard_Hardware-F_Cu.gbr, ArmBoard_Hardware-F_Mask.gbr, ArmBoard_Hardware-F_Paste.gbr]
2021-10-02 Moved everything to a new format. Instead of using global lables I used hierarchical so it would look better. needs to be double checked. check and make sure we dont have any unused schematic files
    [ArmBoard_Hardware.sch, Motor_Controller1-3.sch, Motor_Controller4-6.sch, Motor_Controller_7-Gripper.sch, Motor_Driver_2.sch, Motor_Driver_3.sch, Tiva.sch]
2021-10-10 ENx_# Updated
    [ArmBoard_Hardware.sch, Motor_Controller4-6.sch, Motor_Controller_7-Gripper.sch]
2021-10-15 Pwms have been routed to Pwm Pins. and I added the laser and solenoid mosfets and connectors
    [ArmBoard_Hardware.sch]
2021-10-16 made the main sch smaller
    [ArmBoard_Hardware.sch]
2021-10-16 annotated, moved stuff around
    [ArmBoard_Hardware.sch]
2021-10-16 moved text
    [ArmBoard_Hardware.sch]
2021-10-16 wire fix
    [ArmBoard_Hardware.sch]
2021-10-16 Added MotorToggles
    Removed extra schematic files, added a MotorToggle sheet for the toggle buttons, sheet docs were updated
    [ArmBoard_Hardware.sch, MotorDriverBreakout.sch, MotorToggles.sch, Motor_Controller1-3.sch, Motor_Controller4-6.sch, Motor_Controller_7-Gripper.sch, Motor_Driver_2.sch, Motor_Driver_3.sch]
2021-10-16 Pin Assignments
2021-10-16 Updated Numbering and BOM
    [ArmBoard_Hardware.sch]
2021-10-16 Revised Layout for PDR
    [ArmBoard_Hardware.sch]
2021-10-21 Added Schematics
2021-11-08 need to change the mosfet and the other footrpints under it
    [ArmBoard_Hardware.sch, MotorToggles.sch, Motor_Controller1-3.sch, Motor_Controller4-6.sch, Motor_Controller_7-Gripper.sch]
2021-11-09 still need to do BOM, updated the footprints besides the mosfets
    [ArmBoard_Hardware.sch]
2021-11-10 Updated Symbols
    Fixed orientation of Led Fets, removed Fets for fault detection indicators to minimize components
    [ArmBoard_Hardware.sch]
2021-11-10 beginning layout, need to double check footprints and create BOM
2021-11-12 began the layout
    [ArmBoard_Hardware.kicad_pcb]
2021-11-16 week 2 of layout. andersons fixed and are in correct direction for now. moved VNHs up. plan to put tiva on back of board.
    [ArmBoard_Hardware.kicad_pcb, ArmBoard_Hardware.sch]
2021-11-16 sorting layout
    [ArmBoard_Hardware.kicad_pcb]
2021-11-16 extended board by 0.5in to height
    [ArmBoard_Hardware.kicad_pcb]
2021-11-16 components over top of moco VNHs
    [ArmBoard_Hardware.kicad_pcb]
2021-11-16 moved connectors
    [ArmBoard_Hardware.kicad_pcb]
2021-11-17 mounting holes
    [ArmBoard_Hardware.kicad_pcb]
2021-11-17 late night with the boy
    [ArmBoard_Hardware.kicad_pcb, ArmBoard_Hardware.sch, MotorToggles.sch, Motor_Controller1-3.sch, Motor_Controller4-6.sch, Motor_Controller_7-Gripper.sch]
2021-11-20 Fixed Oscillators
    [ArmBoard_Hardware.kicad_pcb, ArmBoard_Hardware.sch, Motor_Controller1-3.sch, Motor_Controller4-6.sch, Motor_Controller_7-Gripper.sch]
2021-11-20 Layout work
    m1 and 2 are basically done, just need control signals
    [ArmBoard_Hardware.kicad_pcb]
2021-11-24 Worked on Motor Drivers
    added major tracing of motor drivers
    [ArmBoard_Hardware.kicad_pcb, Motor_Controller4-6.sch]
2021-11-24 Power Rails and LEDs
    Routed Power and Power Indicators, starting to route signals
    [ArmBoard_Hardware.kicad_pcb, ArmBoard_Hardware.sch]
2021-11-24 Molex Signals Routed
    [ArmBoard_Hardware.kicad_pcb, ArmBoard_Hardware.sch]
2021-11-27 Routed Major Signals
    [ArmBoard_Hardware.kicad_pcb]
2021-11-27 All Routing Done
    Ran DRC with all checking options, fixed any errors
    [ArmBoard_Hardware.kicad_pcb]
2021-11-30 minor edits, trace corrections
    [ArmBoard_Hardware.kicad_pcb]
2021-12-01 armboard review
    [ArmBoard_Hardware.sch, Motor_Controller1-3.sch, Motor_Controller4-6.sch, Motor_Controller_7-Gripper.sch]
2021-12-02 Removed all signal routing
    Whelp it's gonna look better by tonight
    [ArmBoard_Hardware.kicad_pcb]
2021-12-02 Rerouting traces
    [ArmBoard_Hardware.kicad_pcb]
2021-12-02 Updated Footprints
    [ArmBoard_Hardware.kicad_pcb]
2021-12-02 LEDs routed, footprints correctly assigned
    [ArmBoard_Hardware.kicad_pcb, ArmBoard_Hardware.sch, MotorToggles.sch]
2021-12-03 added signatures
    [ArmBoard_Hardware.kicad_pcb]
2021-12-03 Rerouted all traces
    [ArmBoard_Hardware.kicad_pcb]
2021-12-03 silk screen rev1
    [ArmBoard_Hardware.kicad_pcb]
2021-12-04 rev 1 ready for final lookover and order
    [ArmBoardBom.xlsx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]
2021-12-04 Replaced Fets
    [ArmBoard_Hardware.kicad_pcb, ArmBoard_Hardware.sch]
2021-12-08 generated gerbs and step files
    [ArmBoard_Hardware-B_Cu.gbr, ArmBoard_Hardware-B_Mask.gbr, ArmBoard_Hardware-B_Paste.gbr, ArmBoard_Hardware-B_SilkS.gbr, ArmBoard_Hardware-Edge_Cuts.gbr, ArmBoard_Hardware-F_Cu.gbr, ArmBoard_Hardware-F_Mask.gbr, ArmBoard_Hardware-F_Paste.gbr]
2021-12-30 reverted hardware files back two commits (0152c5e)
    the past two commits lost signatures and board information. This commit adds back the signatures while keeping gerbs in /Manufacturing.
    [ArmBoard_Hardware.kicad_pcb, ArmBoard_Hardware.sch]
2021-12-31 Rescued the Libaries
    [ArmBoard_Hardware.sch, Motor_Controller1-3.sch, Motor_Controller4-6.sch, Motor_Controller_7-Gripper.sch]
2022-01-19 added mounting holes, still not sure what happned to them but they disapeared
    [ArmBoard_Hardware.kicad_pcb]
2022-02-09 rev2 begins
    [ArmBoard_Hardware.kicad_pcb, ArmBoard_Hardware.sch, MotorToggles.sch, Motor_Controller1-3.sch, Motor_Controller1.sch, Motor_Controller2.sch, Motor_Controller3.sch, Motor_Controller4.sch]
2022-02-09 consept pcb
    [ArmBoard_Hardware.kicad_pcb, ArmBoard_Hardware.sch]
2022-02-11 Rev 2, still needs new mosfet circuit and new solenoid mosfet tthat can handle it
    [ArmBoard_Hardware.kicad_pcb, ArmBoard_Hardware.sch, MotorToggles.sch]
2022-02-12 added missing lables to connectors
    [ArmBoard_Hardware.kicad_pcb, Motor_Controller1.sch, Motor_Controller2.sch, Motor_Controller3.sch, Motor_Controller4.sch, Motor_Controller5.sch, Motor_Controller6.sch, Motor_Controller7.sch]
2022-02-12 minor changes
    [ArmBoard_Hardware.kicad_pcb]
2022-02-12 bad via on 12va fixed
    [ArmBoard_Hardware.kicad_pcb]
2022-02-12 MOSFETS are remade, need to just clean up and review
    [ArmBoard_Hardware.kicad_pcb, ArmBoard_Hardware.sch]
2022-02-12 get rid of 5v led
    [ArmBoard_Hardware.kicad_pcb, ArmBoard_Hardware.sch]
2022-02-12 visual improvements
    [ArmBoard_Hardware.kicad_pcb]
2022-02-15 added limit switches to a total of 6
    [ArmBoard_Hardware.sch]
2022-02-22 moved stuff on schematic
    [ArmBoard_Hardware.sch]
2022-02-22 Started Changes
    Via spacing and density
    [ArmBoard_Hardware.kicad_pcb]
2022-02-22 Fixed edge cuts
    [ArmBoard_Hardware.kicad_pcb]
2022-02-22 schematic changes, encoder changes, led changes
    [ArmBoard_Hardware.sch, Motor_Controller1.sch, Motor_Controller2.sch, Motor_Controller3.sch, Motor_Controller4.sch, Motor_Controller5.sch, Motor_Controller6.sch]
2022-02-22 Made size smaller
    [ArmBoard_Hardware.kicad_pcb]
2022-02-22 need to change encoder traces, need to add ground resistors to the vnh's and the led trace needs to be redone
    [ArmBoard_Hardware.kicad_pcb]
2022-02-22 reworked vnh resistors on M3, do that for the others
    [ArmBoard_Hardware.kicad_pcb]
2022-02-26 save before runs
    [ArmBoard_Hardware.kicad_pcb]
2022-02-26 rev 2 finishing passes
    [ArmBoard_Hardware.kicad_pcb, Motor_Controller7.sch]
2022-03-01 finishing passes
    [ArmBoard_Hardware.kicad_pcb]
2022-03-03 minor changes, changed the vnh traces
    [ArmBoard_Hardware-B_Cu.gbr, ArmBoard_Hardware-B_Mask.gbr, ArmBoard_Hardware-B_Paste.gbr, ArmBoard_Hardware-B_SilkS.gbr, ArmBoard_Hardware-Edge_Cuts.gbr, ArmBoard_Hardware-F_Cu.gbr, ArmBoard_Hardware-F_Mask.gbr, ArmBoard_Hardware-F_Paste.gbr]
2022-03-05 more changes, realignment of alot of stuff
    [ArmBoard_Hardware.kicad_pcb, ArmBoard_Hardware.sch]
2022-03-05 square anderson
    [ArmBoard_Hardware.kicad_pcb, ArmBoard_Hardware.sch]
2022-03-07 moved the andersons
    [ArmBoard_Hardware.kicad_pcb]
2022-03-07 moved traces
    [ArmBoard_Hardware.kicad_pcb]
2022-03-08 trace cleanup
    [ArmBoard_Hardware.kicad_pcb]
2022-03-09 Board Review
    [ArmBoard_Hardware.kicad_pcb]
2022-03-14 more ground
    [ArmBoard_Hardware.csv, ArmBoard_Hardware.kicad_pcb]
2022-03-15 gerbs added and zipped
    [ArmBoard_Hardware-B_Cu.gbr, ArmBoard_Hardware-B_Mask.gbr, ArmBoard_Hardware-B_Paste.gbr, ArmBoard_Hardware-B_SilkS.gbr, ArmBoard_Hardware-Edge_Cuts.gbr, ArmBoard_Hardware-F_Cu.gbr, ArmBoard_Hardware-F_Mask.gbr, ArmBoard_Hardware-F_Paste.gbr]
2022-03-15 final gerbs
    [ArmBoard_Hardware-B_Cu.gbr, ArmBoard_Hardware-B_Mask.gbr, ArmBoard_Hardware-B_Paste.gbr, ArmBoard_Hardware-B_SilkS.gbr, ArmBoard_Hardware-Edge_Cuts.gbr, ArmBoard_Hardware-F_Cu.gbr, ArmBoard_Hardware-F_Mask.gbr, ArmBoard_Hardware-F_Paste.gbr]
2022-03-16 added names and labeling
    [ArmBoard_Hardware-B_Cu.gbr, ArmBoard_Hardware-B_Mask.gbr, ArmBoard_Hardware-B_Paste.gbr, ArmBoard_Hardware-B_SilkS.gbr, ArmBoard_Hardware-Edge_Cuts.gbr, ArmBoard_Hardware-F_Cu.gbr, ArmBoard_Hardware-F_Mask.gbr, ArmBoard_Hardware-F_Paste.gbr]
2022-04-27 updated BOM mosfet
    [Armboard BOM.xlsx]
2022-05-07 rev 2.1 updated with new pwm pin from PM2 to Motor1 PWM1 instead of PH3
    [ArmBoard_Hardware.kicad_pcb, ArmBoard_Hardware.sch]
