MissouriMRDT/ArmBoard_Hardware/(notices)

Notices in the files:
parts and their libraries:
SparkFun-Passives: Licensing: Creative Commons ShareAlike 4.0 International - https://creativecommons.org/licenses/by-sa/4.0
Copyright 2016 Accelerated Designs. All rights reserved.
